SiChiTong/AGV_PowerBoard/NOAH_PM_V0.2_201709291753.pdf

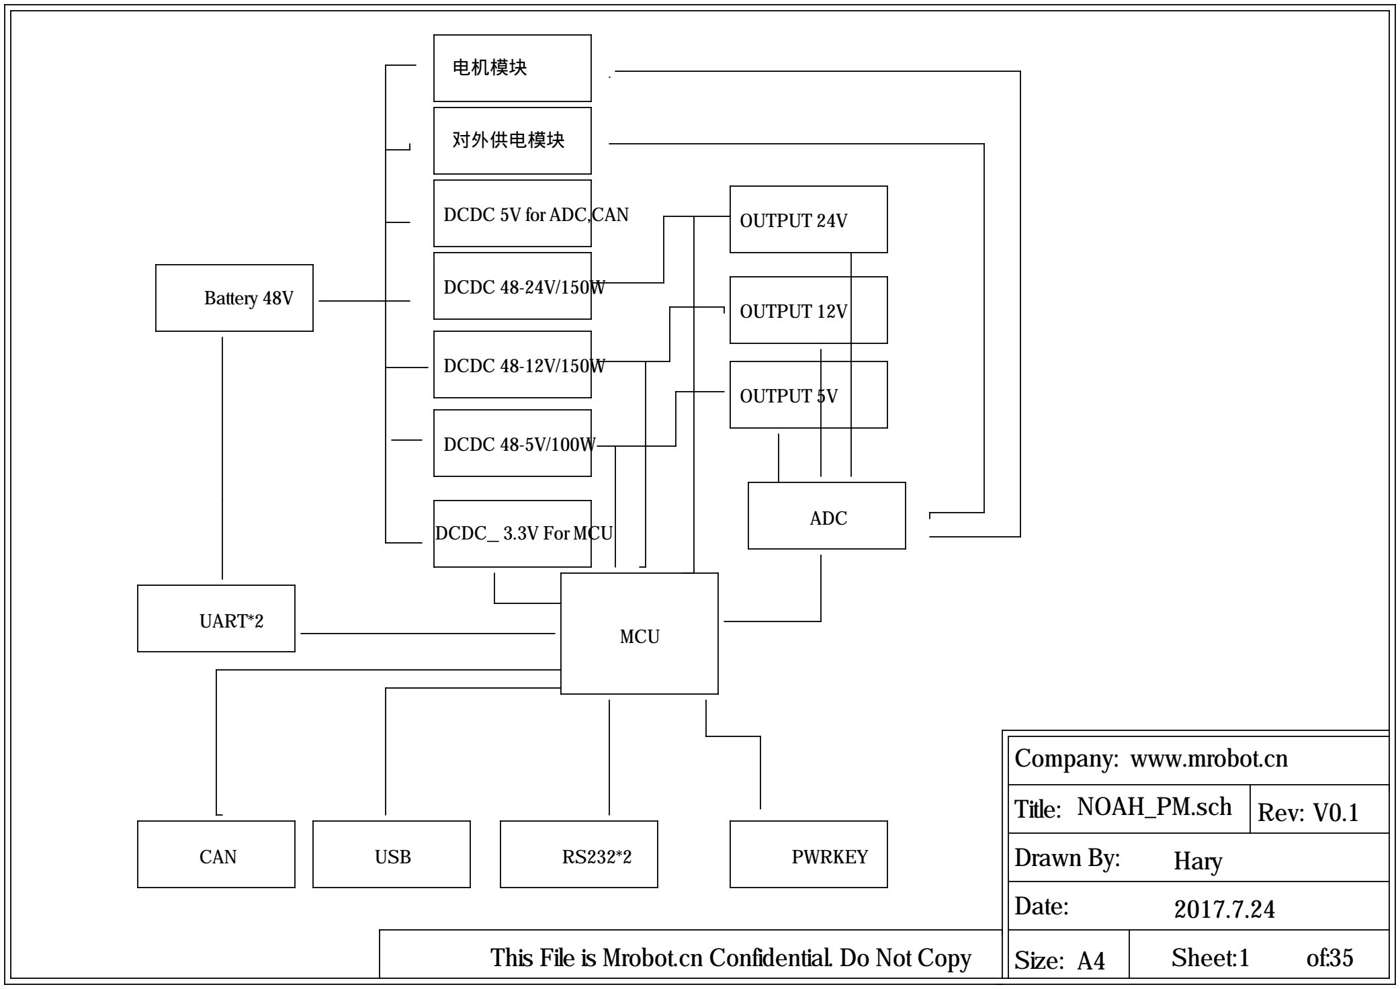
[picture p1: figure]
Company: www.mrobot.cn; Title:; Drawn By:; Date:; Size:; NOAH_PM.sch; Rev: V0.1; Hary; DCDC 48-24V/150W; DCDC 48-12V/150W; DCDC 48-5V/100W; Battery 48V; MCU; OUTPUT 24V; OUTPUT 12V; OUTPUT 5V; ADC; UART*2; CAN; USB; PWRKEY; DCDC_3.3V For MCU; DCDC 5V for ADC,CAN; 对外供电模块; 电机模块

This File is Mrobot.cn Confidential. Do Not Copy | A4 | Sheet: | of: 1 | 35

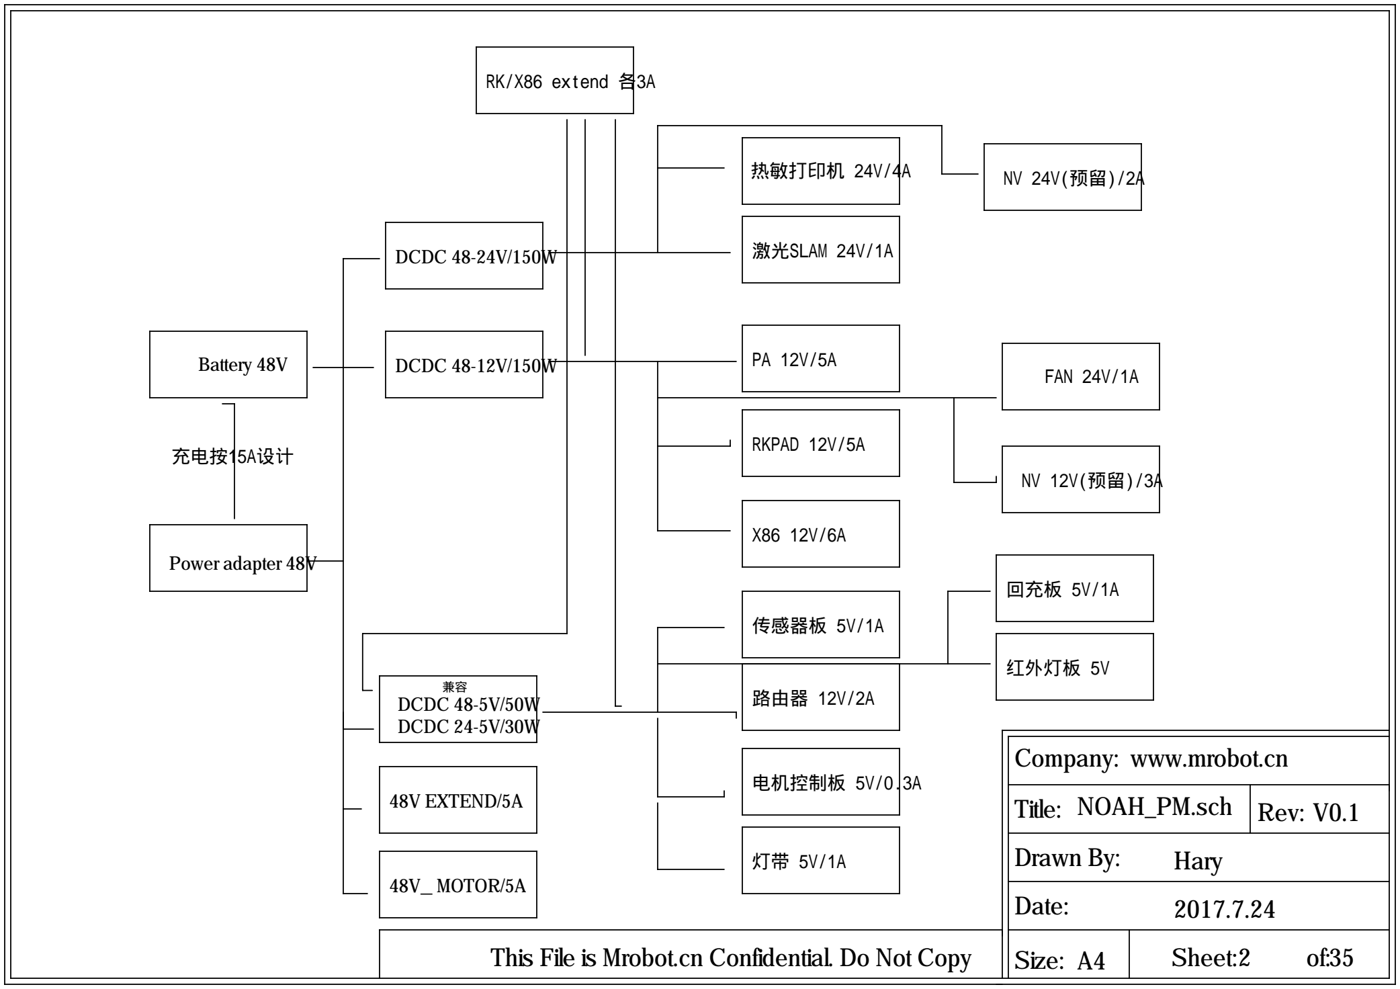
[picture p2: figure]
Company: www.mrobot.cn; Title:; Drawn By:; Date:; NOAH_PM.sch; Rev: V0.1; Hary; Battery 48V; DCDC 48-24V/150W; DCDC 48-12V/150W; DCDC 48-5V/50W; 热敏打印机 24V/4A; 激光SLAM 24V/1A; RKPAD 12V/5A; RK/X86 extend 各3A; 传感器板 5V/1A; 路由器 12V/2A; 电机控制板 5V/0.3A; FAN 24V/1A; 回充板 5V/1A; 红外灯板 5V; 48V EXTEND/5A; 48V_MOTOR/5A; Power adapter 48V; 充电按15A设计; DCDC 24-5V/30W

This File is Mrobot.cn Confidential. Do Not Copy | A4 | Sheet: | of: 2 | 35

# DC-DCÄ£¿é

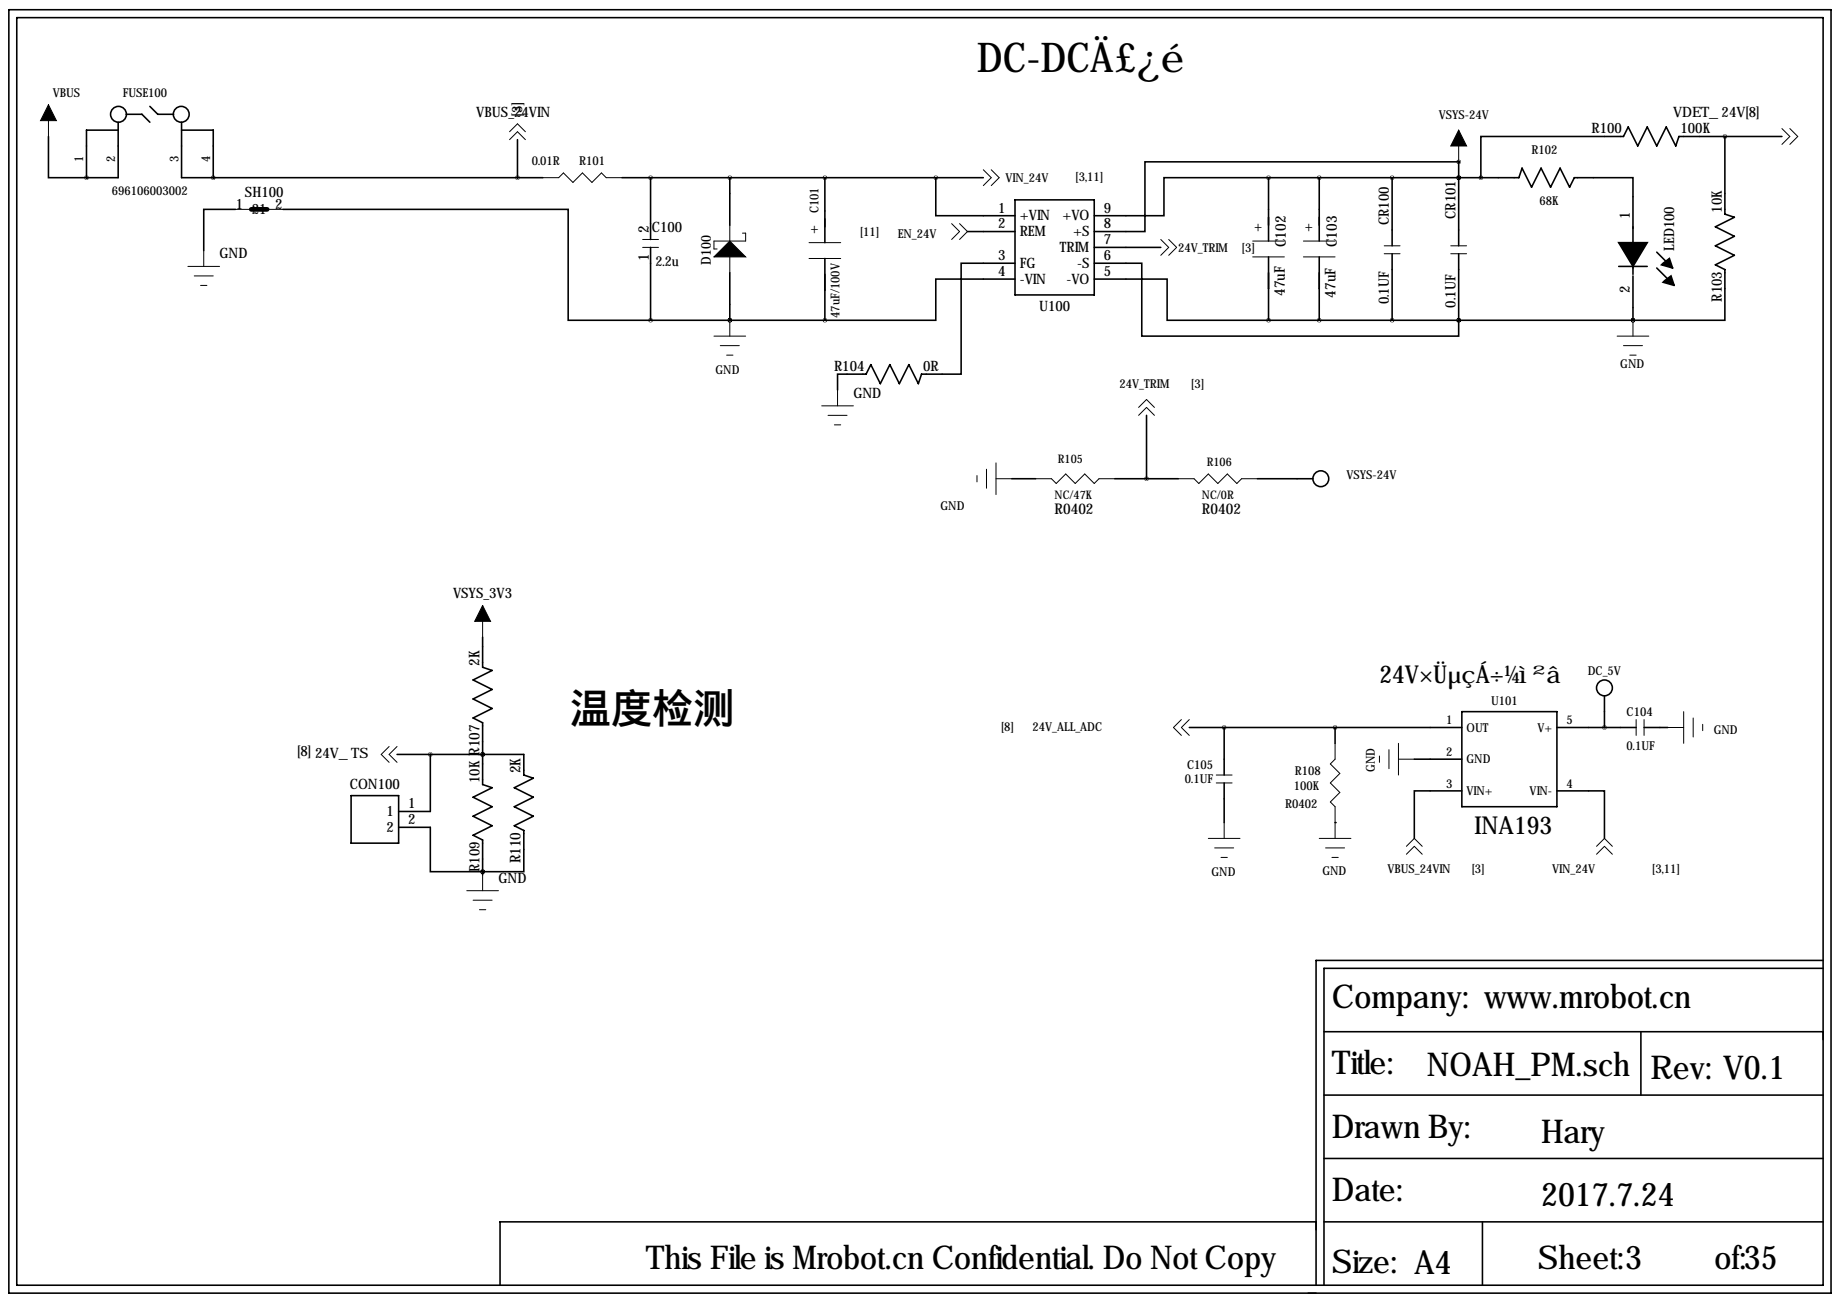
[picture p3: page 3]

Company: www.mrobot.cn

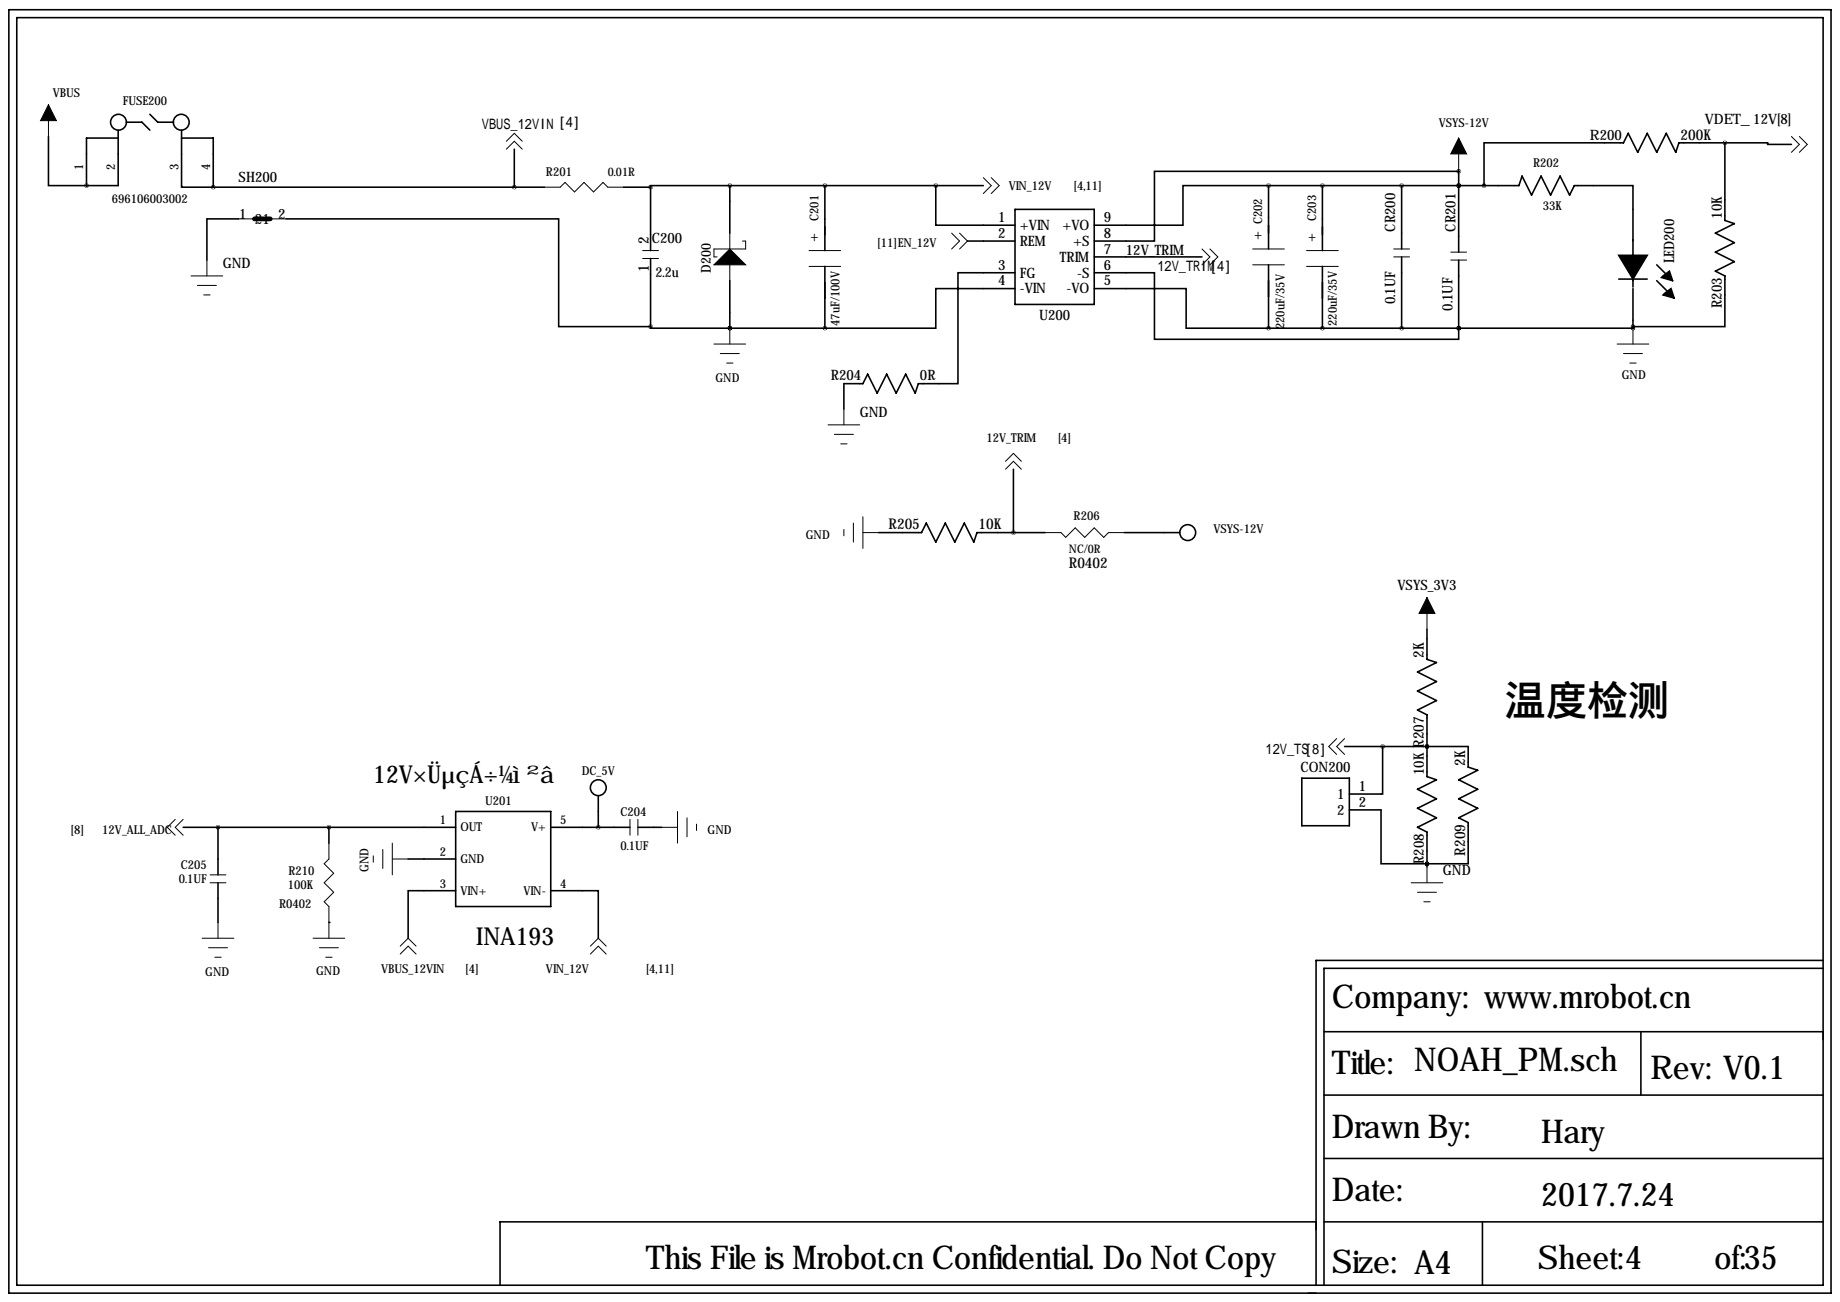
[picture p4: page 4]

Company: www.mrobot.cn

## Note:兼容四分之一砖封装

### Note:料号不对

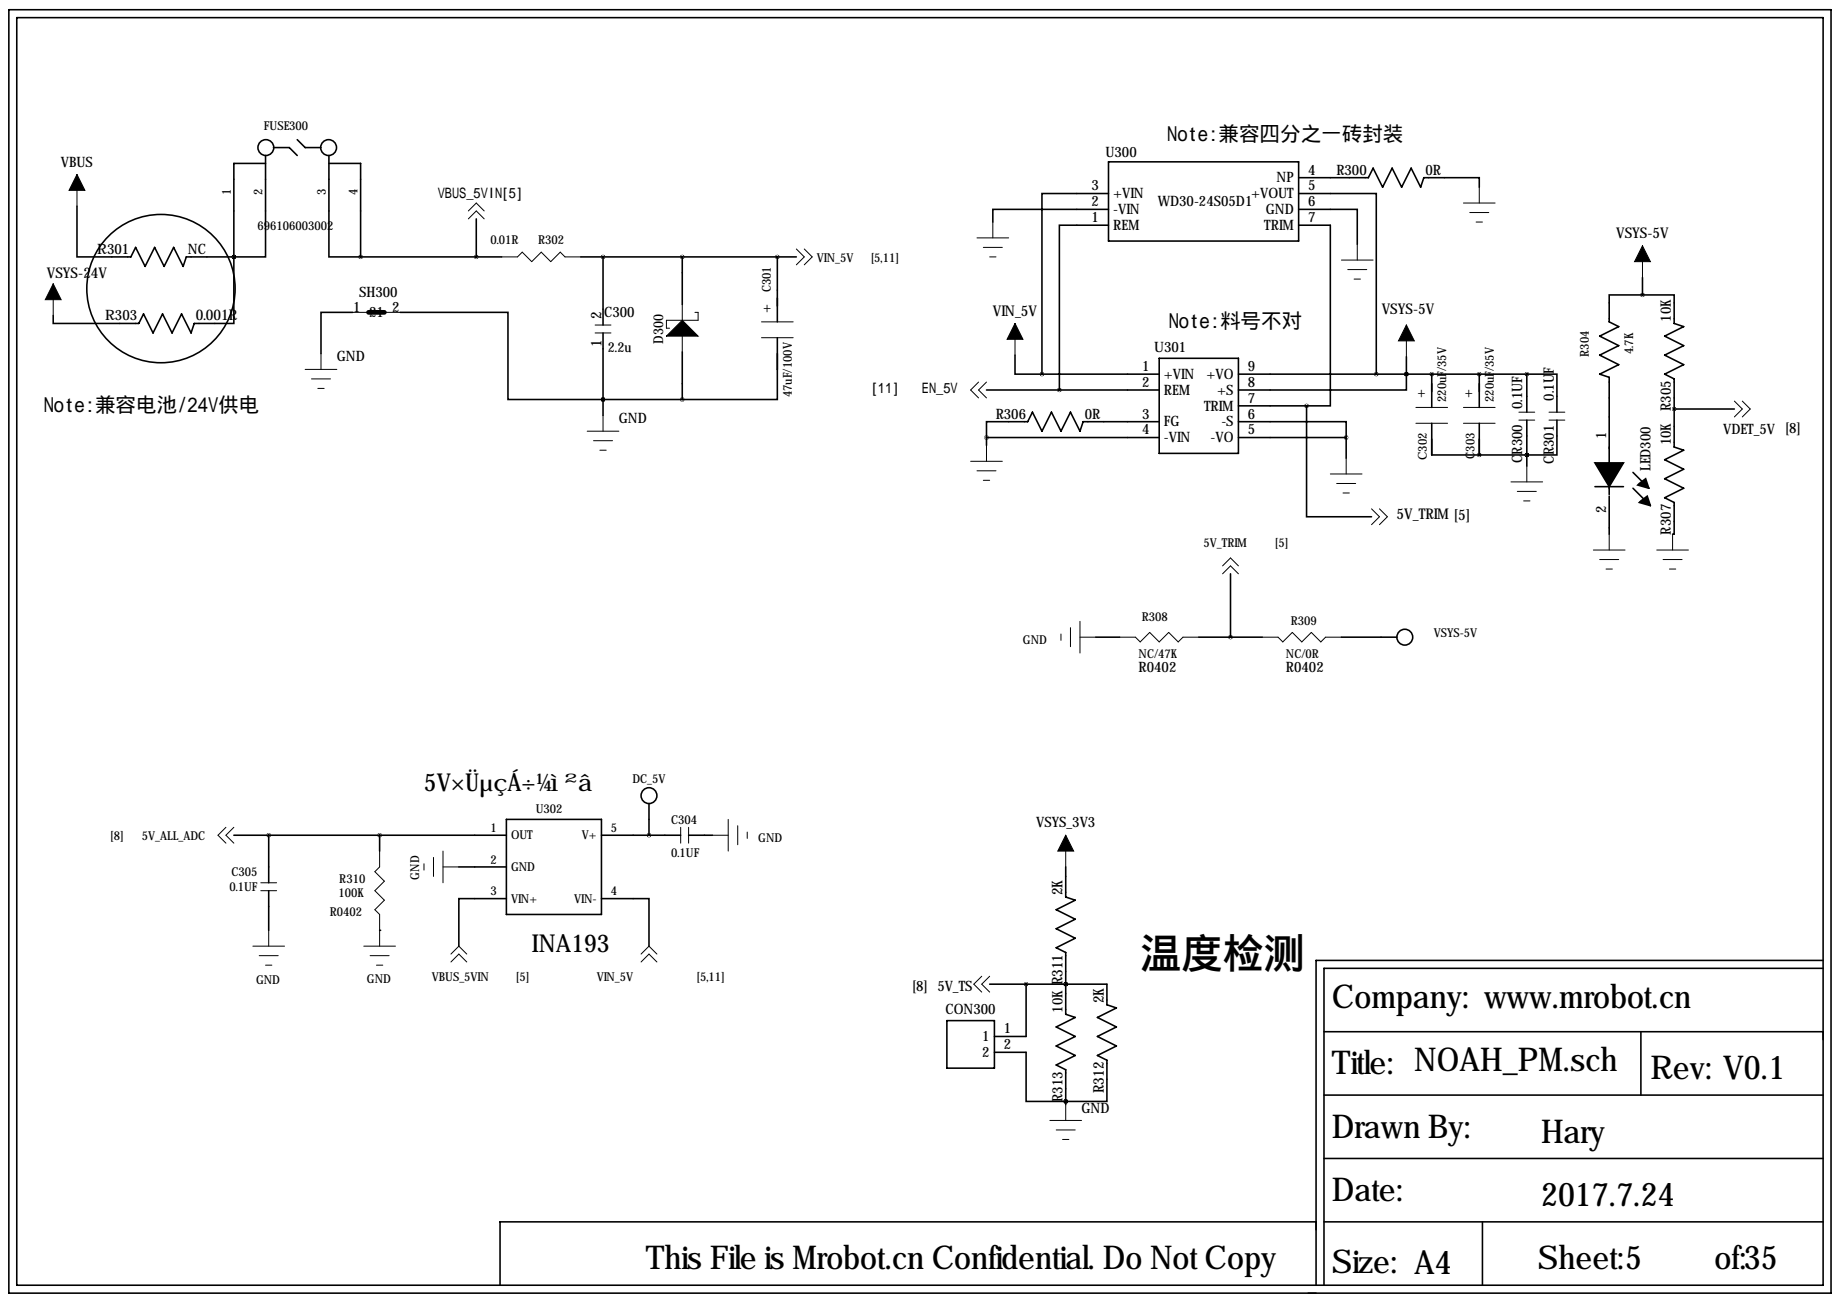
[picture p5: page 5]

Company: www.mrobot.cn

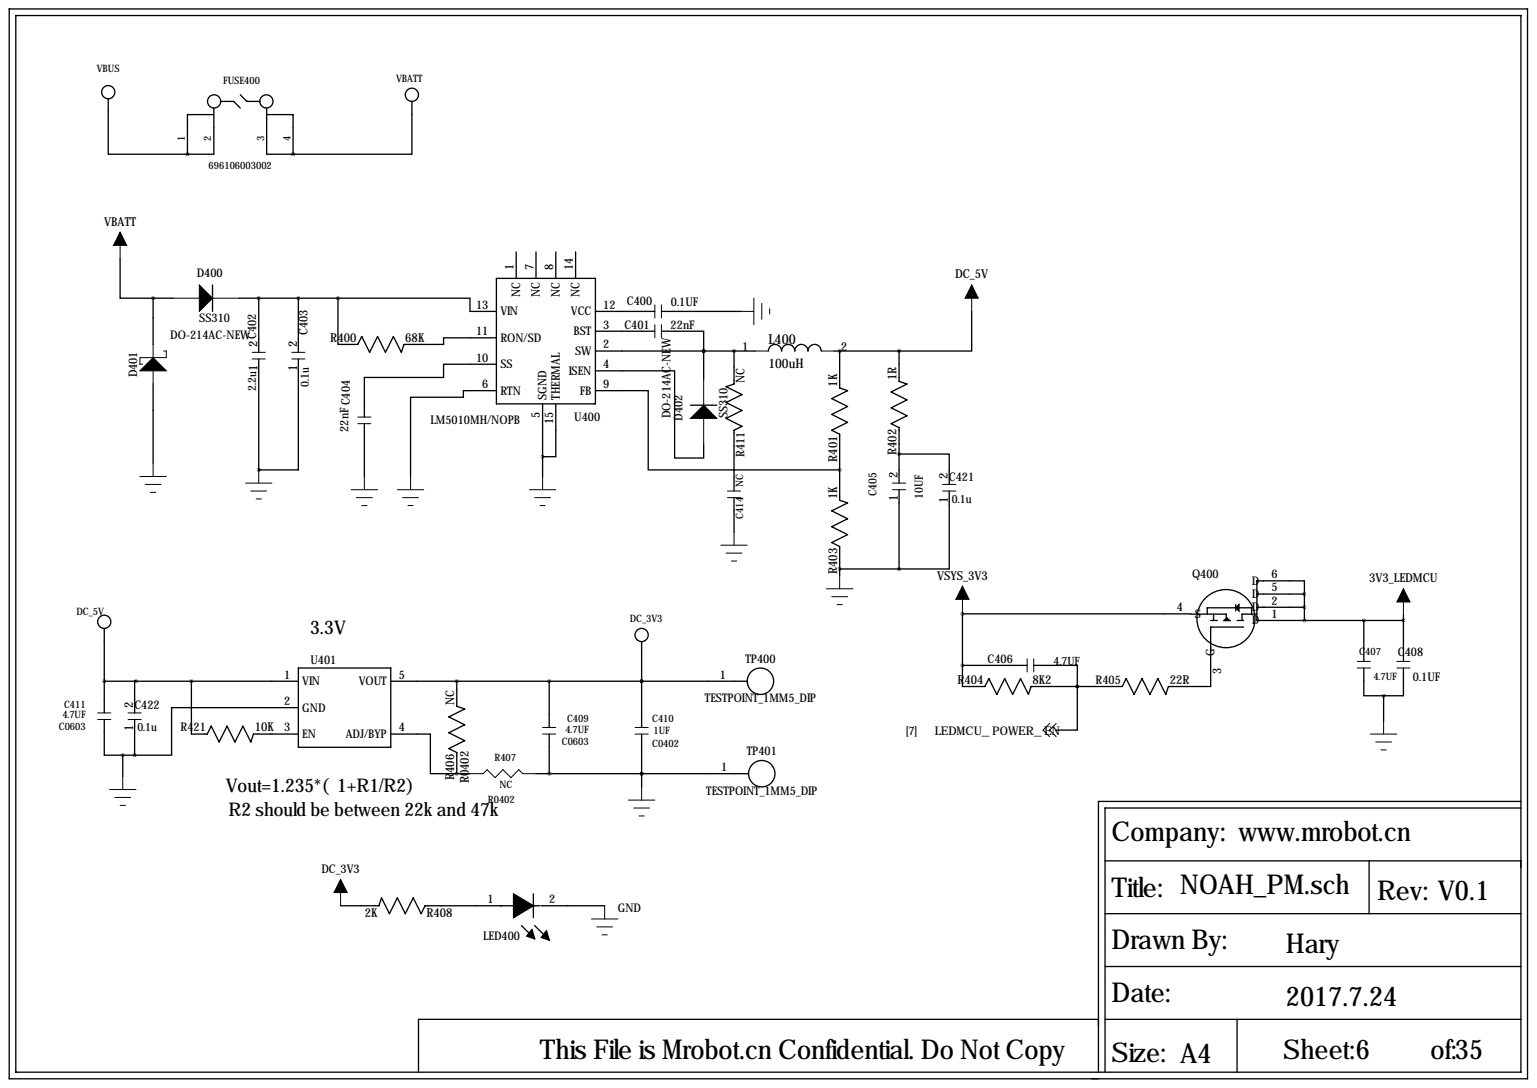
[picture p6: page 6]

Vout=1.235*(1+R1/R2)
R2 should be between 22k and 47k

Company: www.mrobot.cn

# C503 22PF Y⁵00

### VSYS_3V3

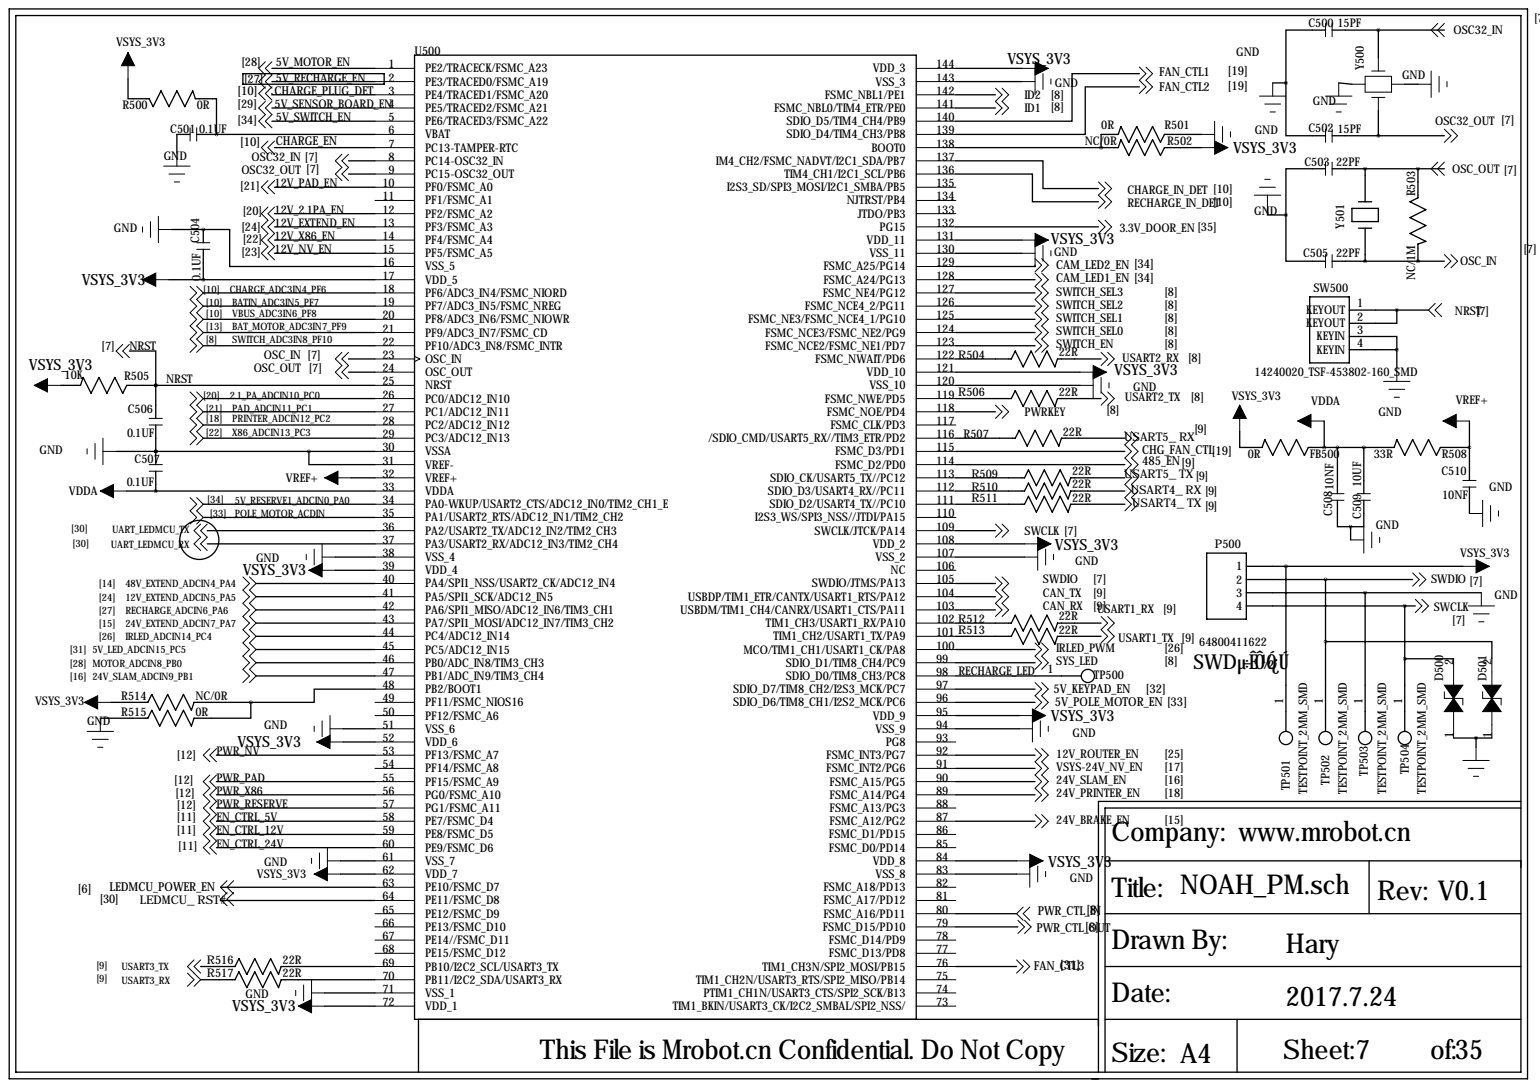
[picture p7: page 7]

### ´®¿ÚÉÕÂ¼Ê± ½Ó3.3V

## µç³ØµçÑ¹¼ì²â

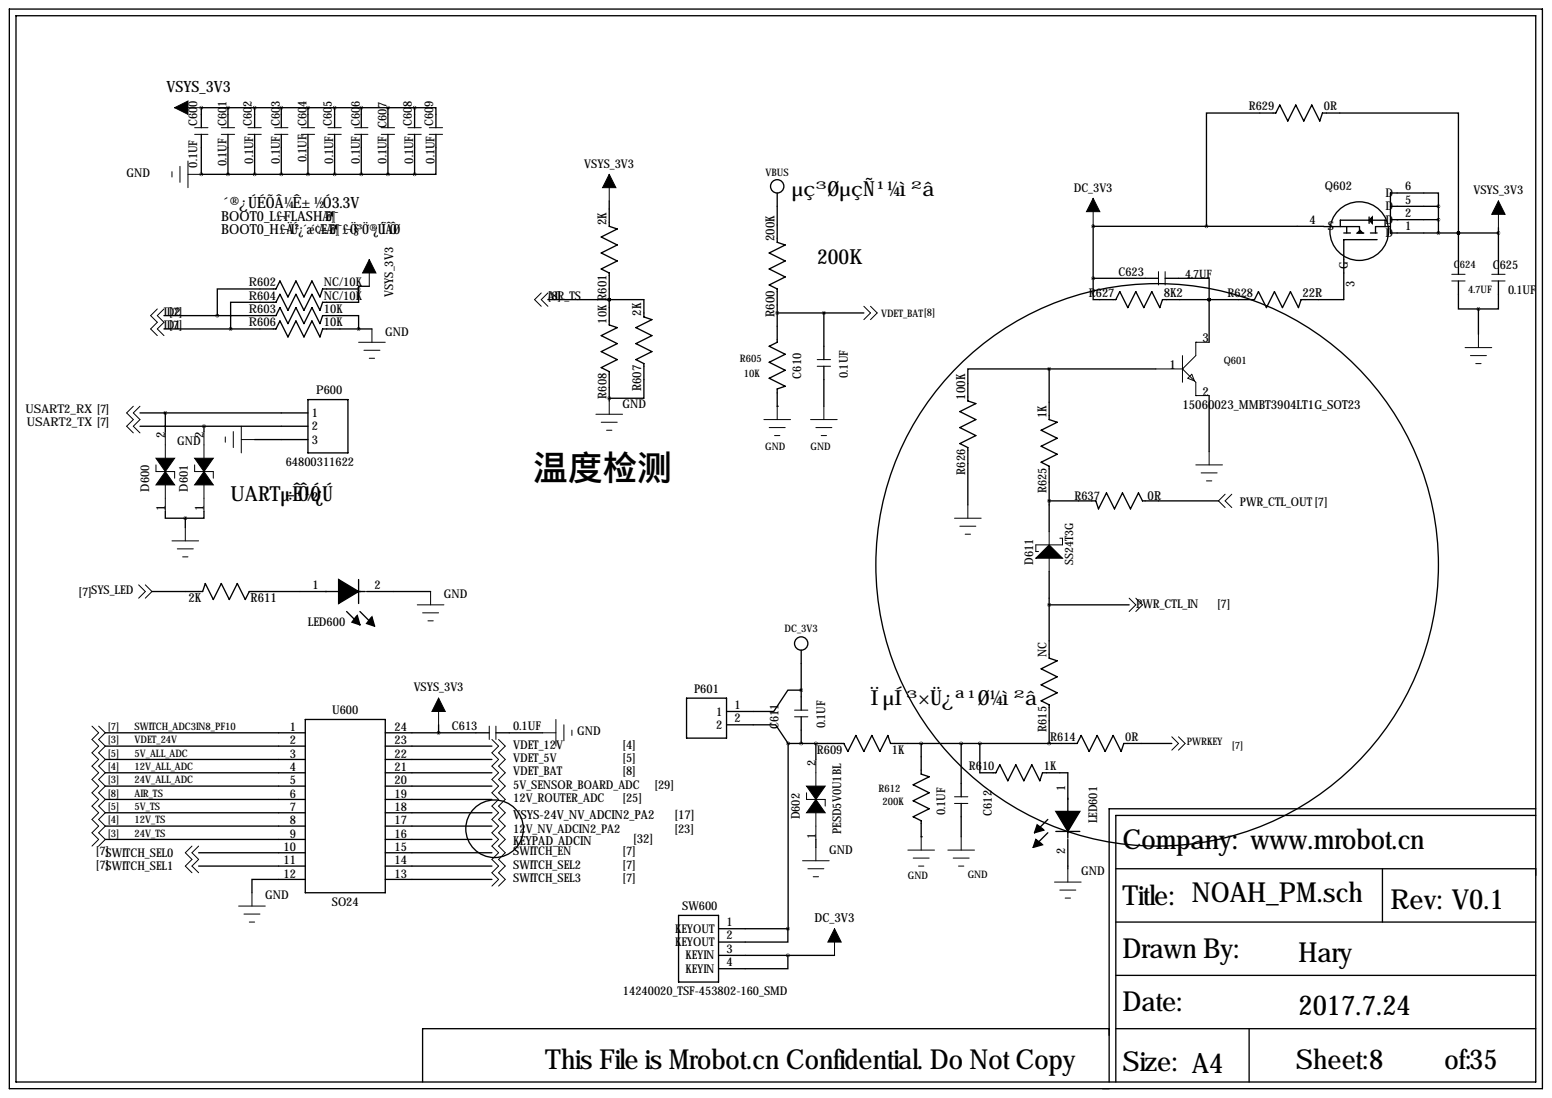
[picture p8: page 8]

BOOT0_L£¬FLASHÆô¶¯
BOOT0_H£¬ÄÚ²¿´æ´¢Æ÷Æô¶¯£¬Ö§³Ö´®¿ÚÏÂÔØ

Company: www.mrobot.cn

## X86Í¨Ñ¶¿Ú

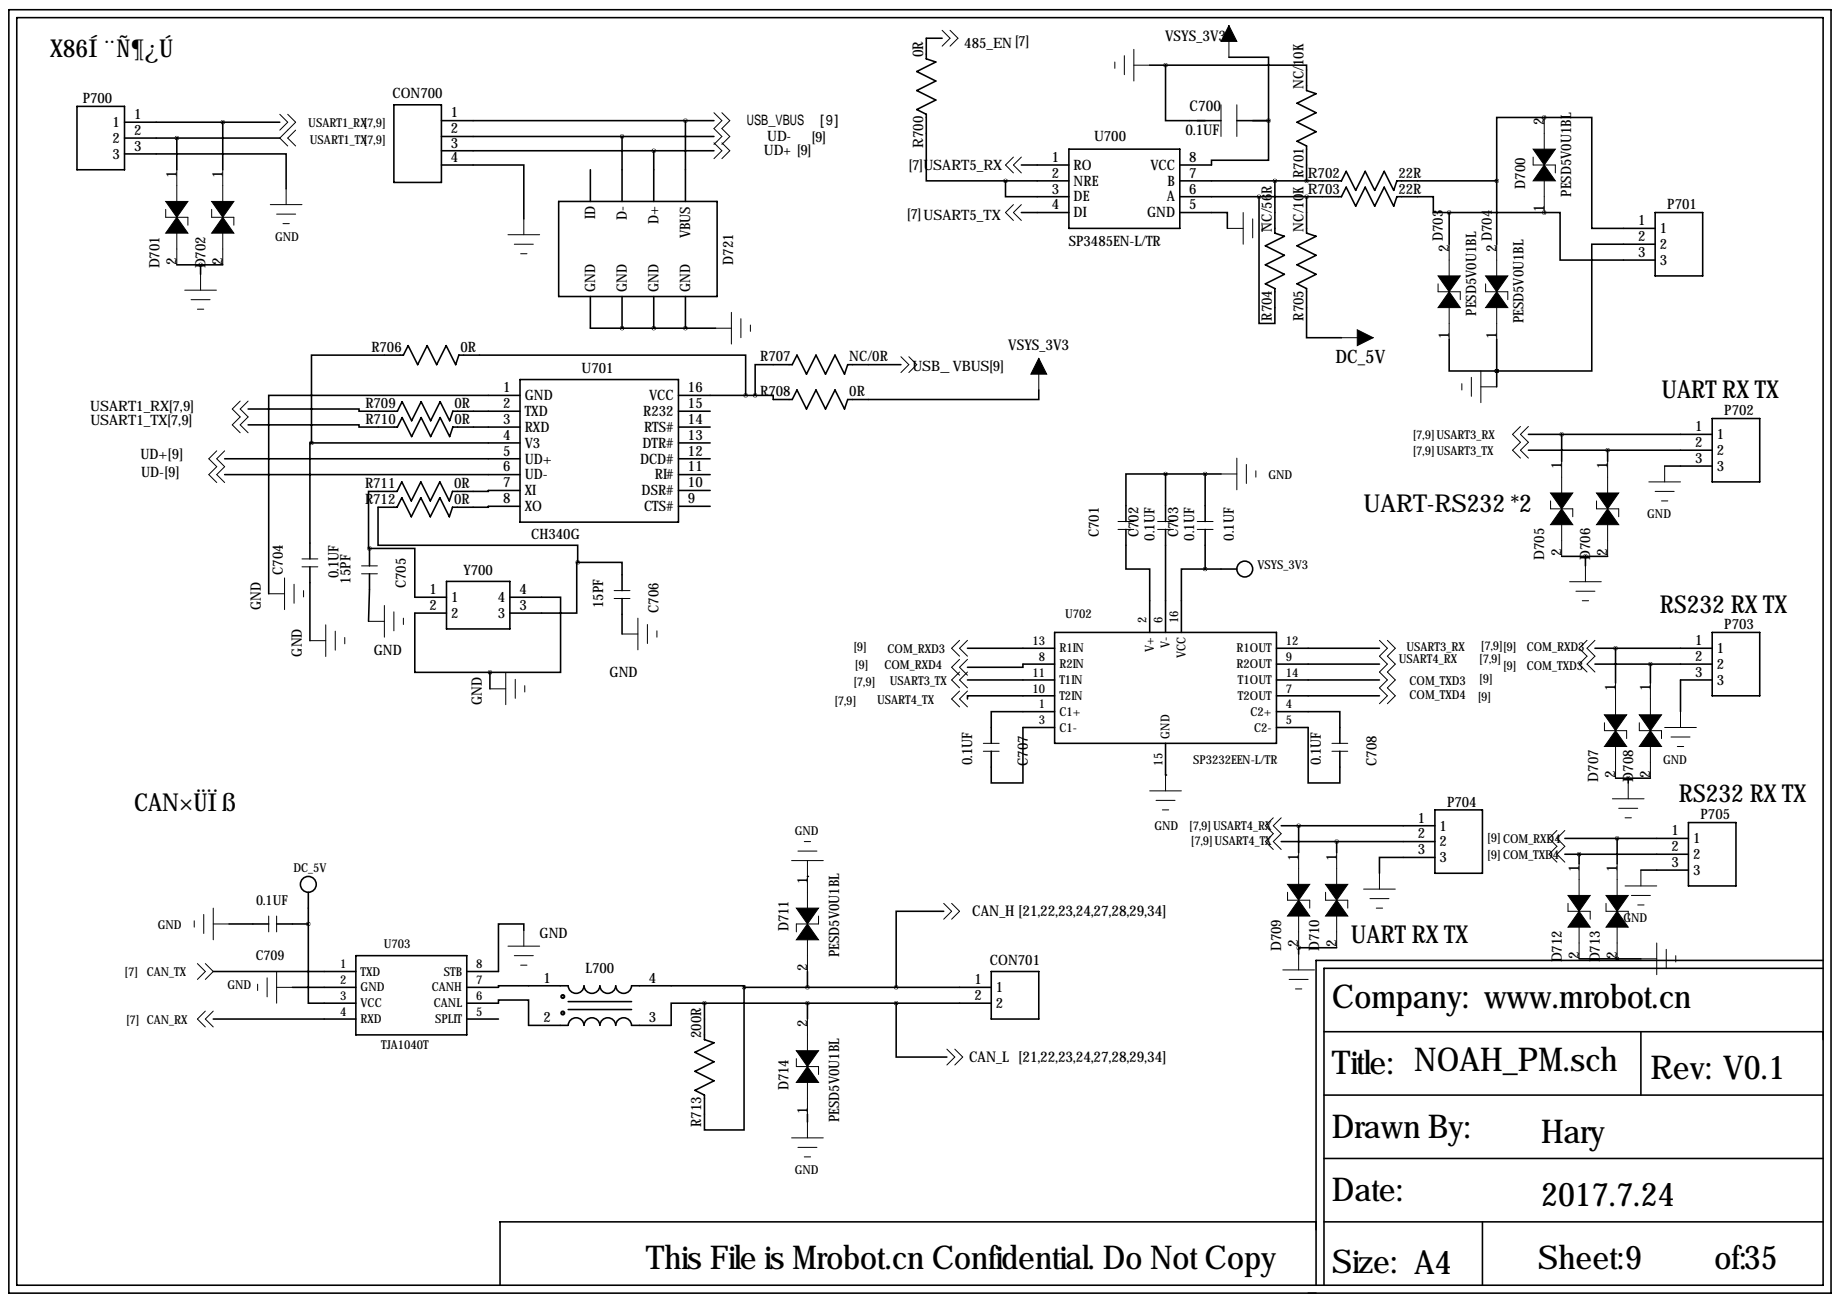
[picture p9: page 9]

Company: www.mrobot.cn

## ×ÜµçÁ÷¼ì²â

## INA193

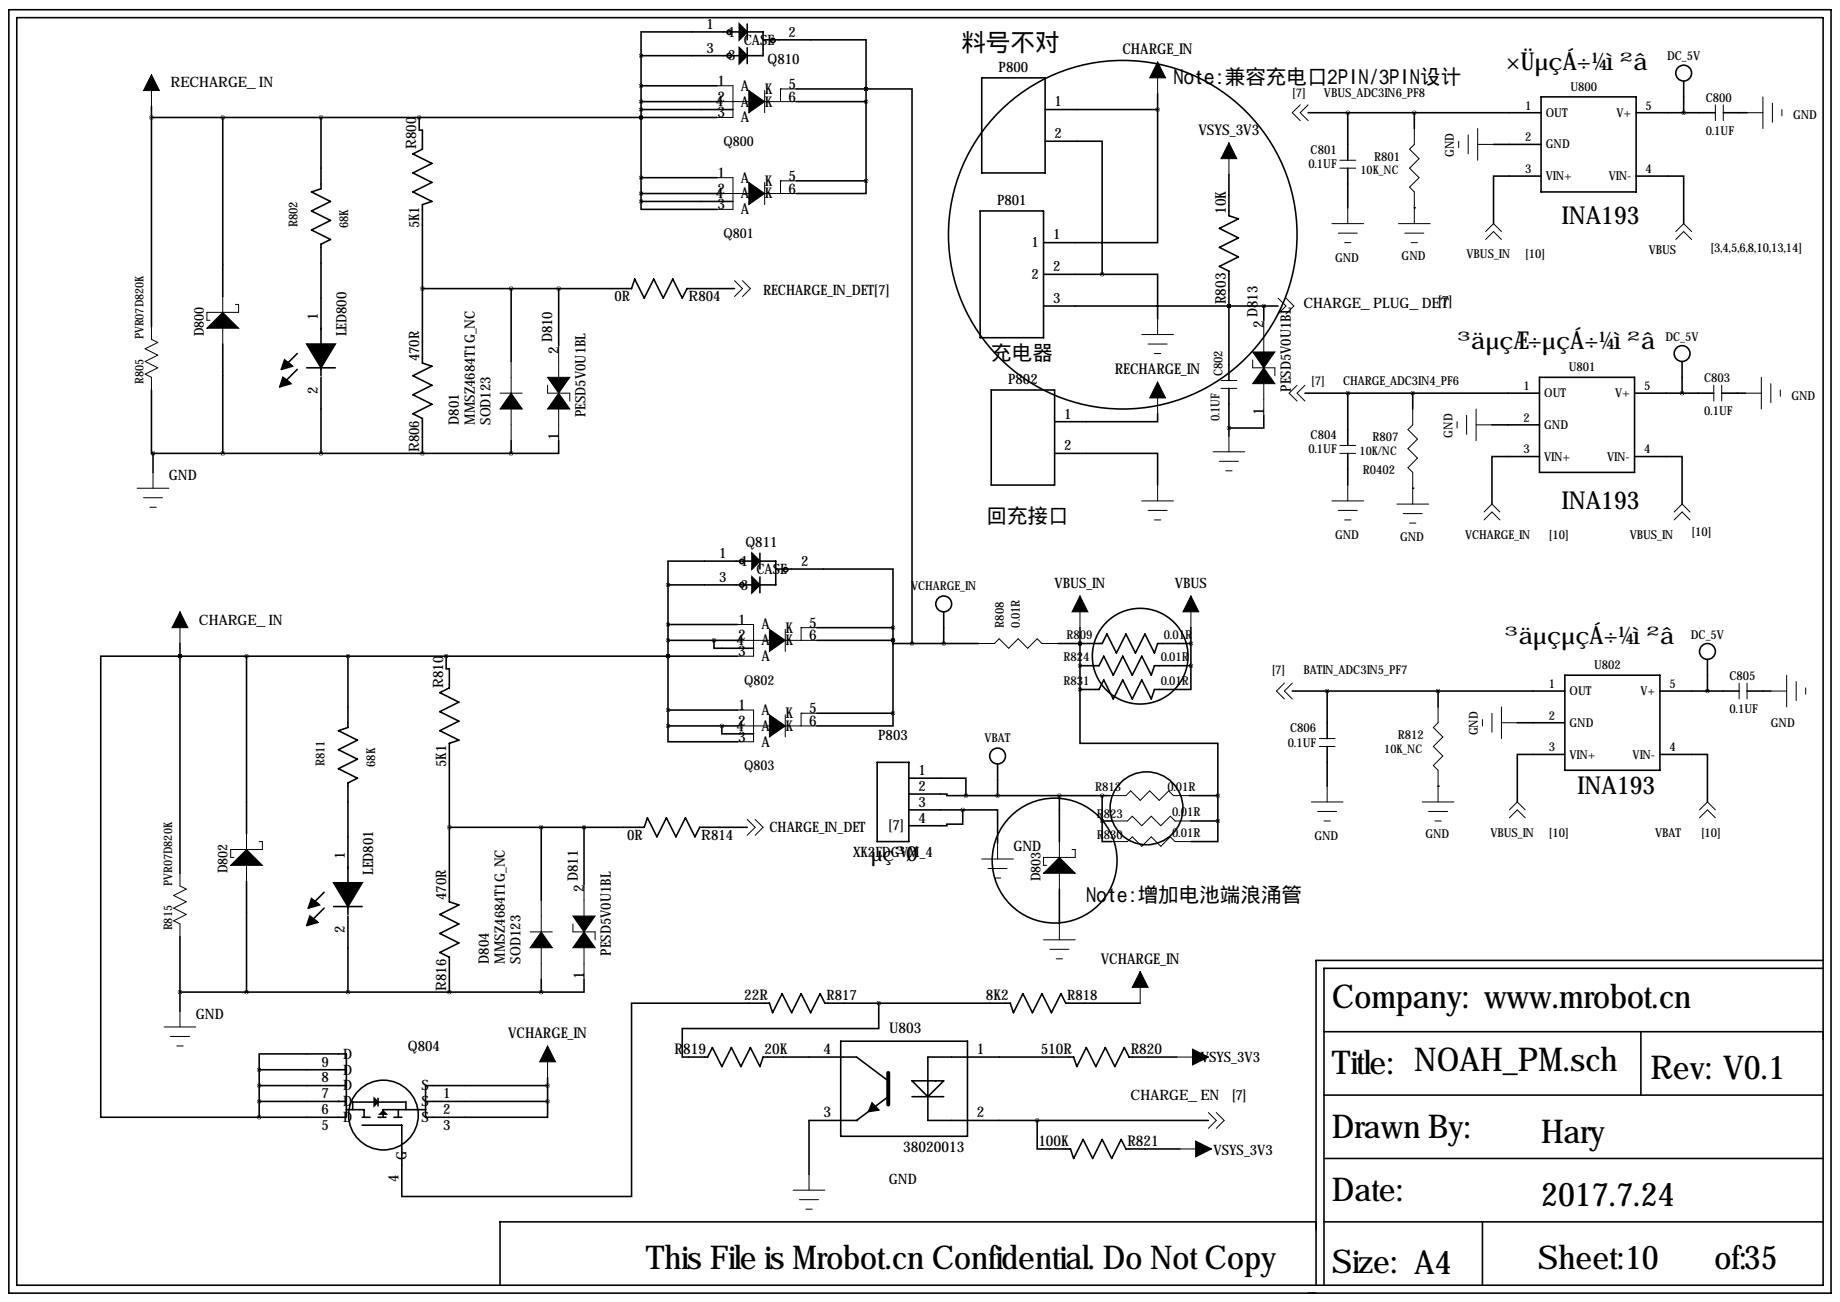
[picture p10: page 10]

Company: www.mrobot.cn

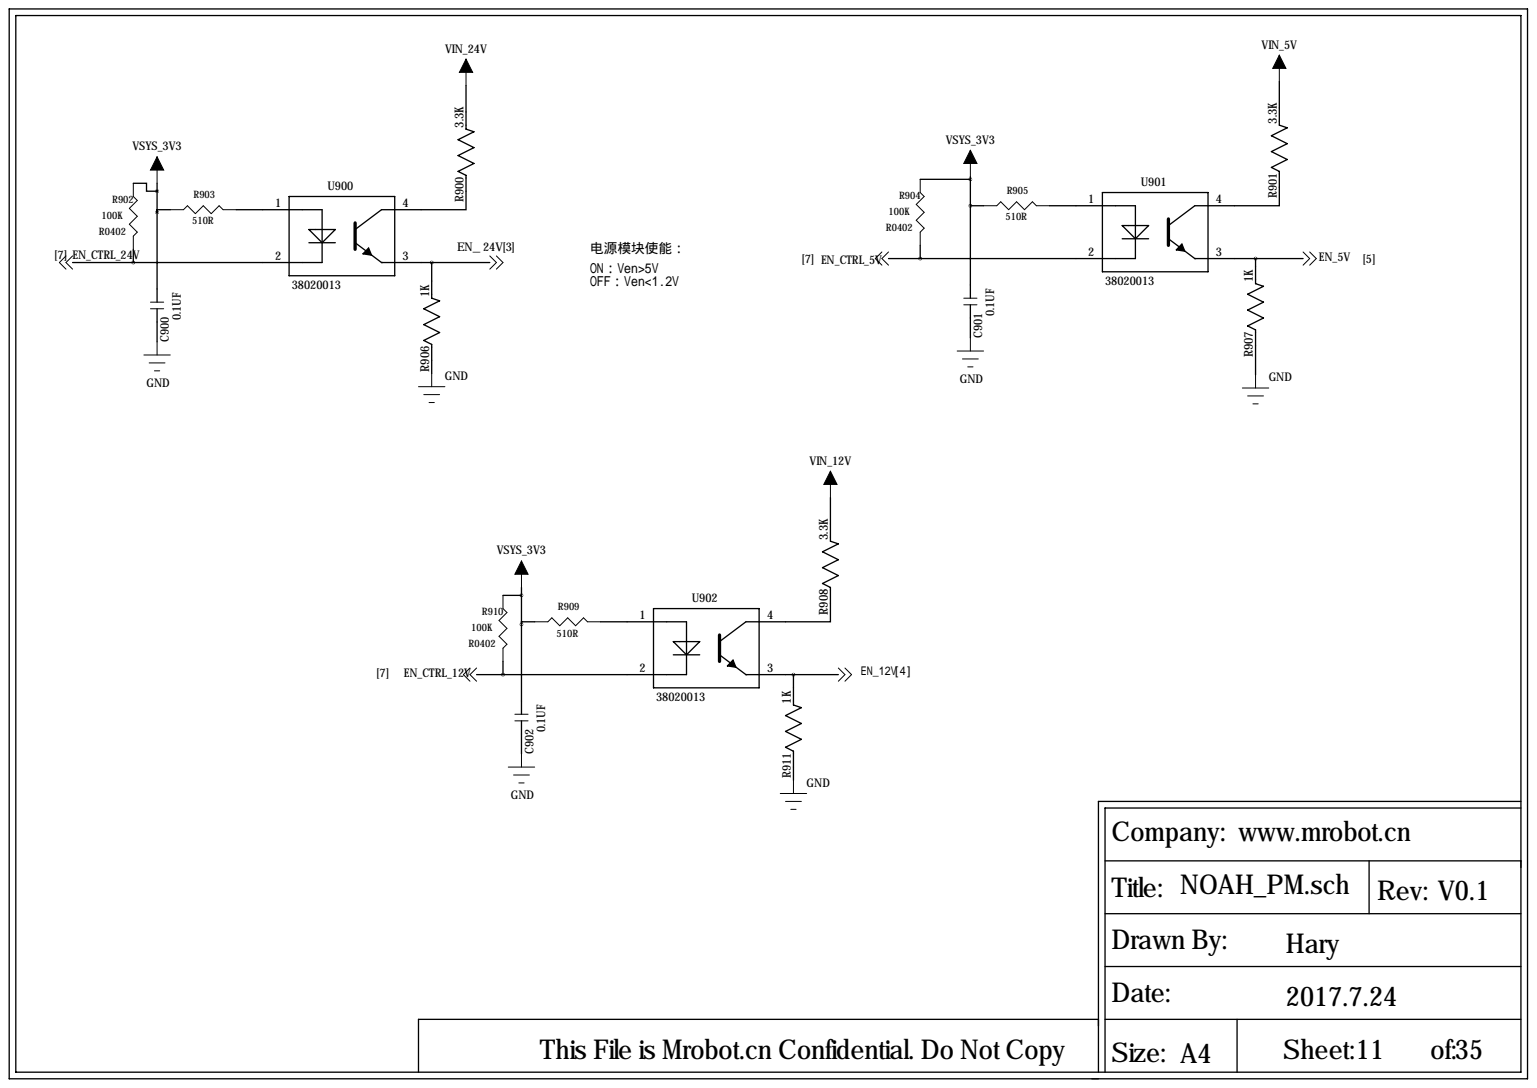
[picture p11: page 11]

Company: www.mrobot.cn

PAD PWRKEY | X86 PWRKEY

## C Q¹⁰⁰⁰

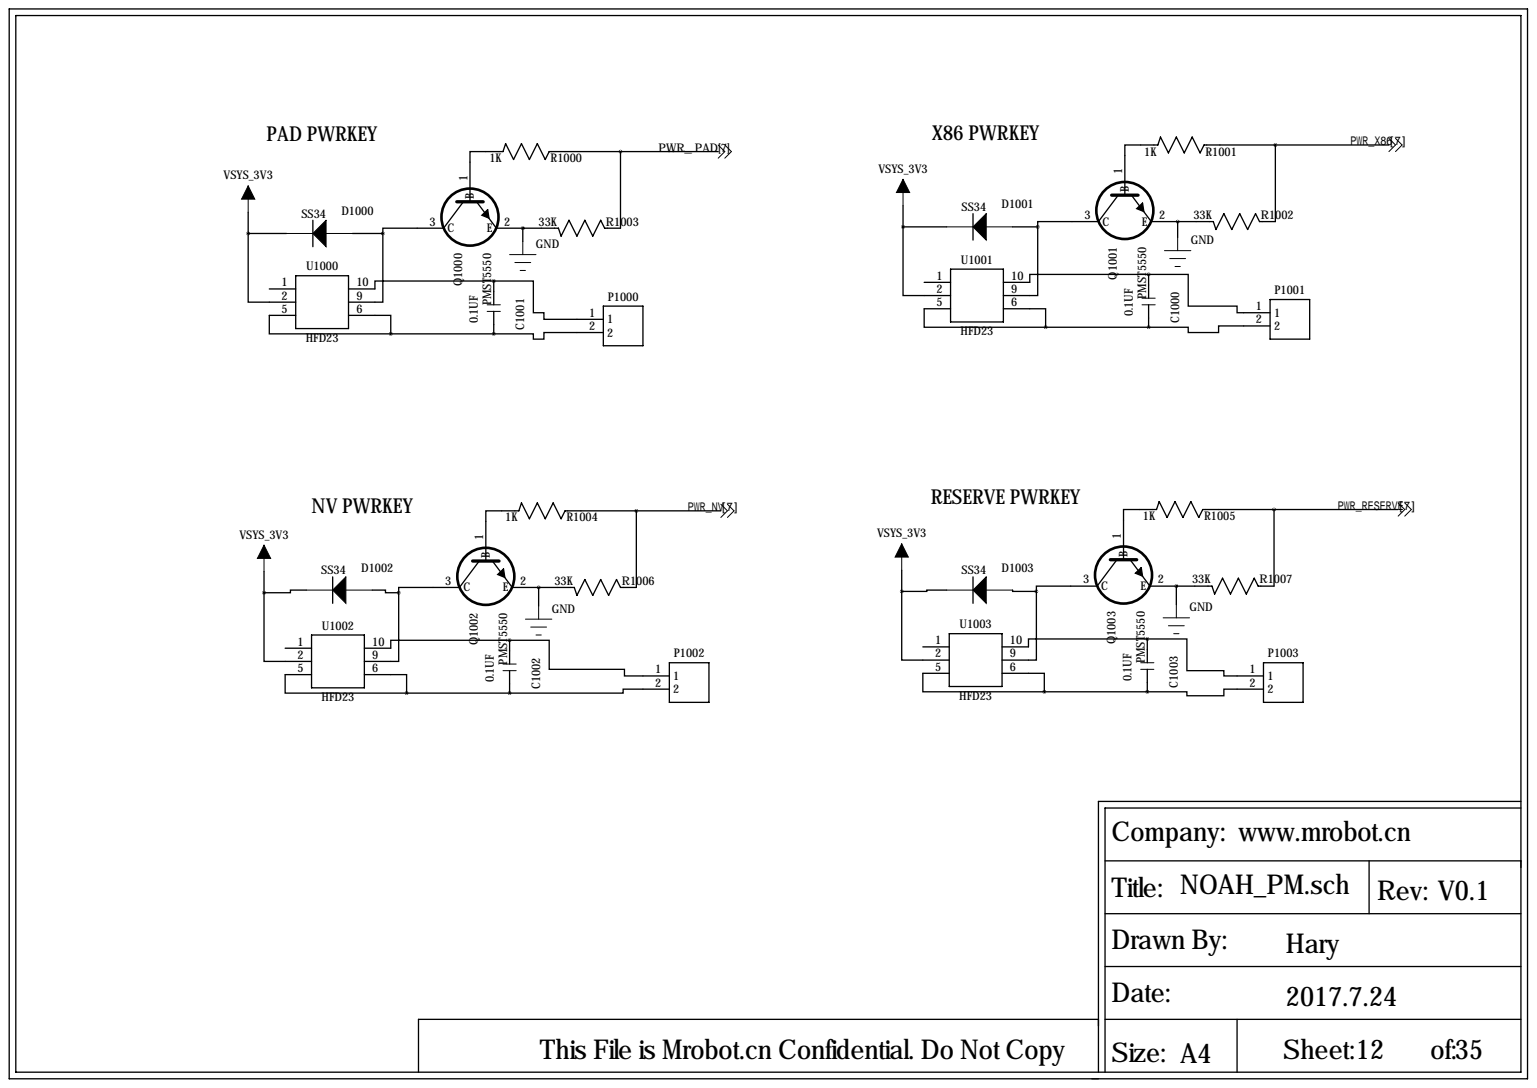
[picture p12: page 12]

Company: www.mrobot.cn

## 电机驱动器48V

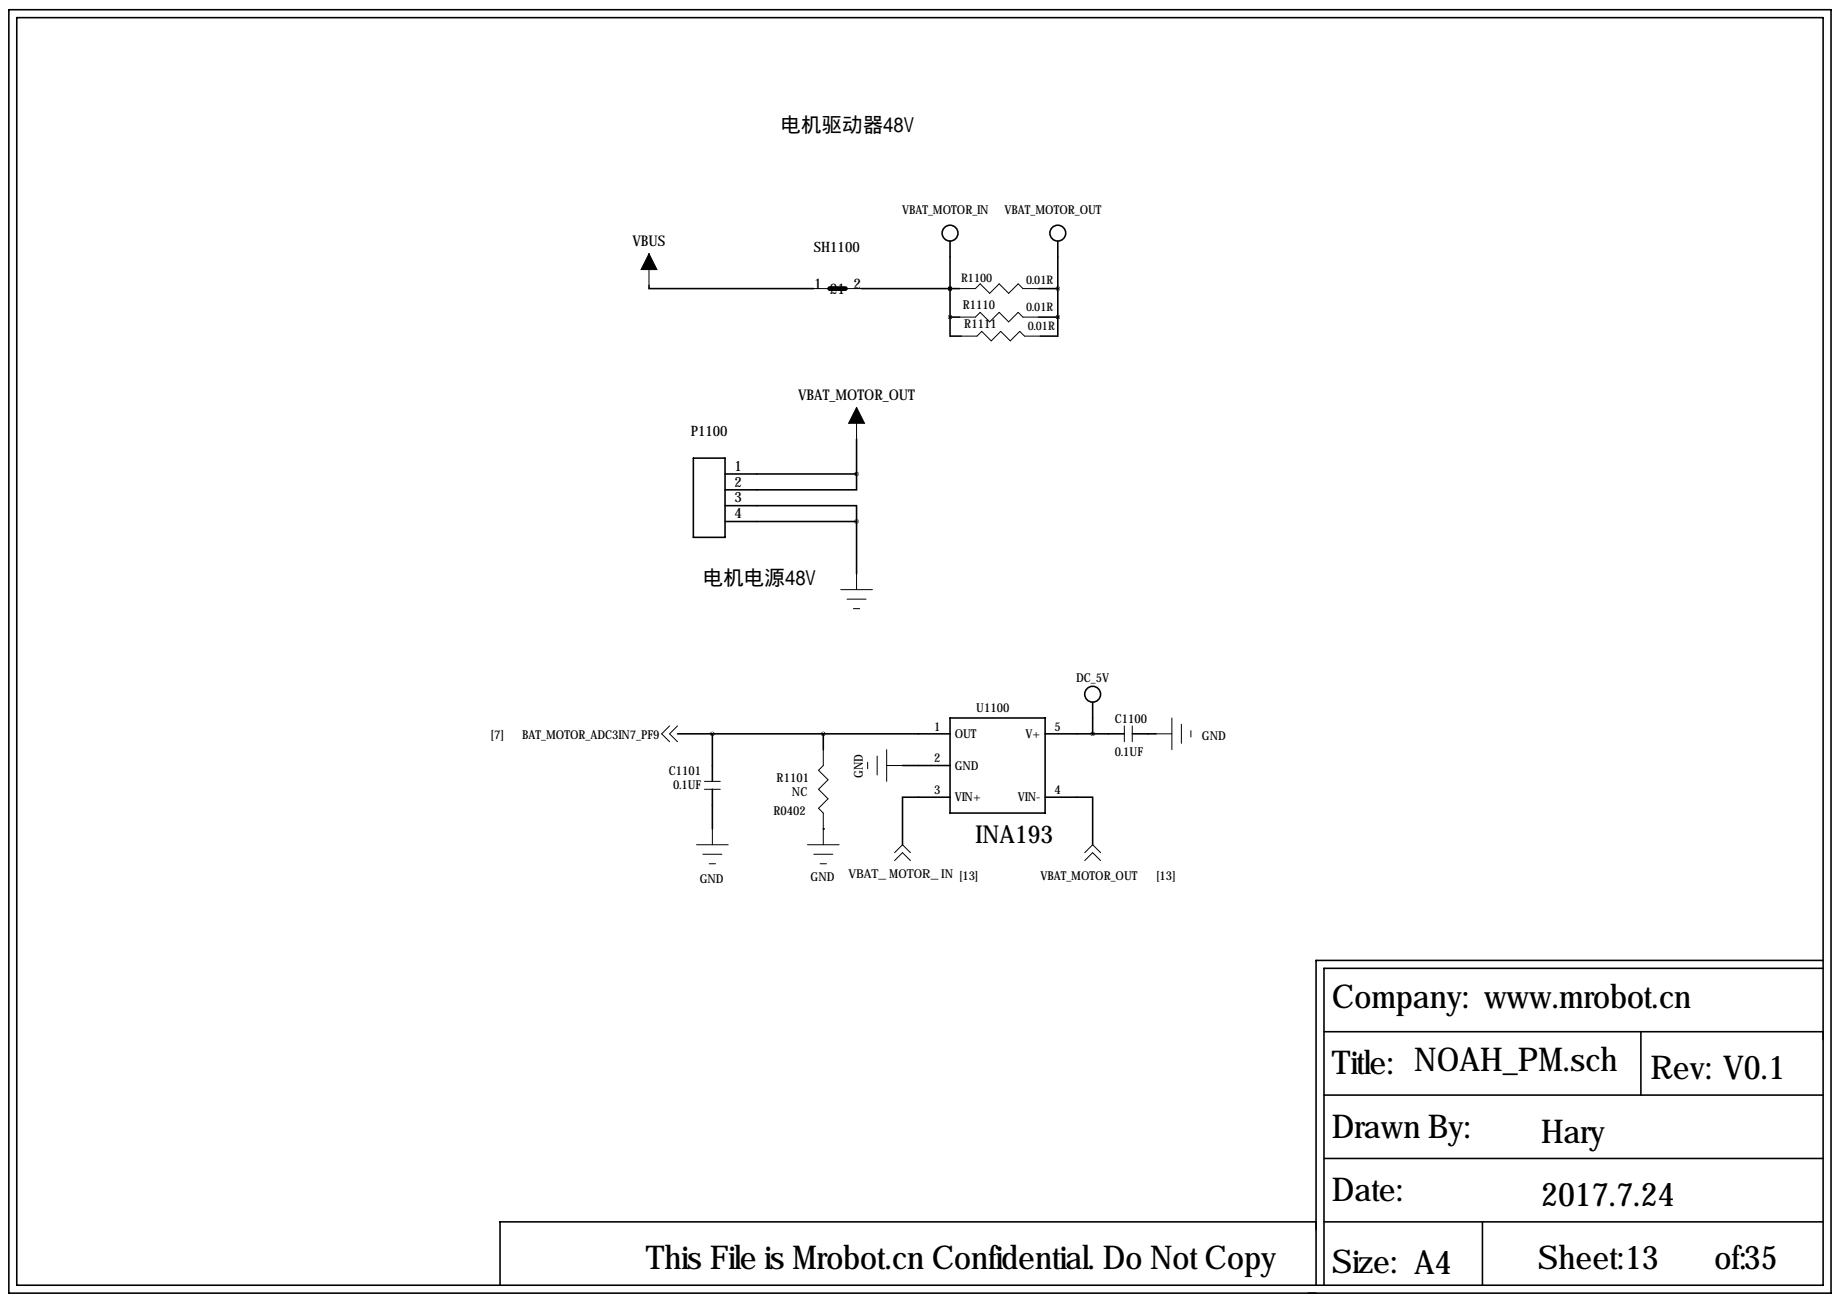
[picture p13: page 13]

Company: www.mrobot.cn

## 对外供电模块48V

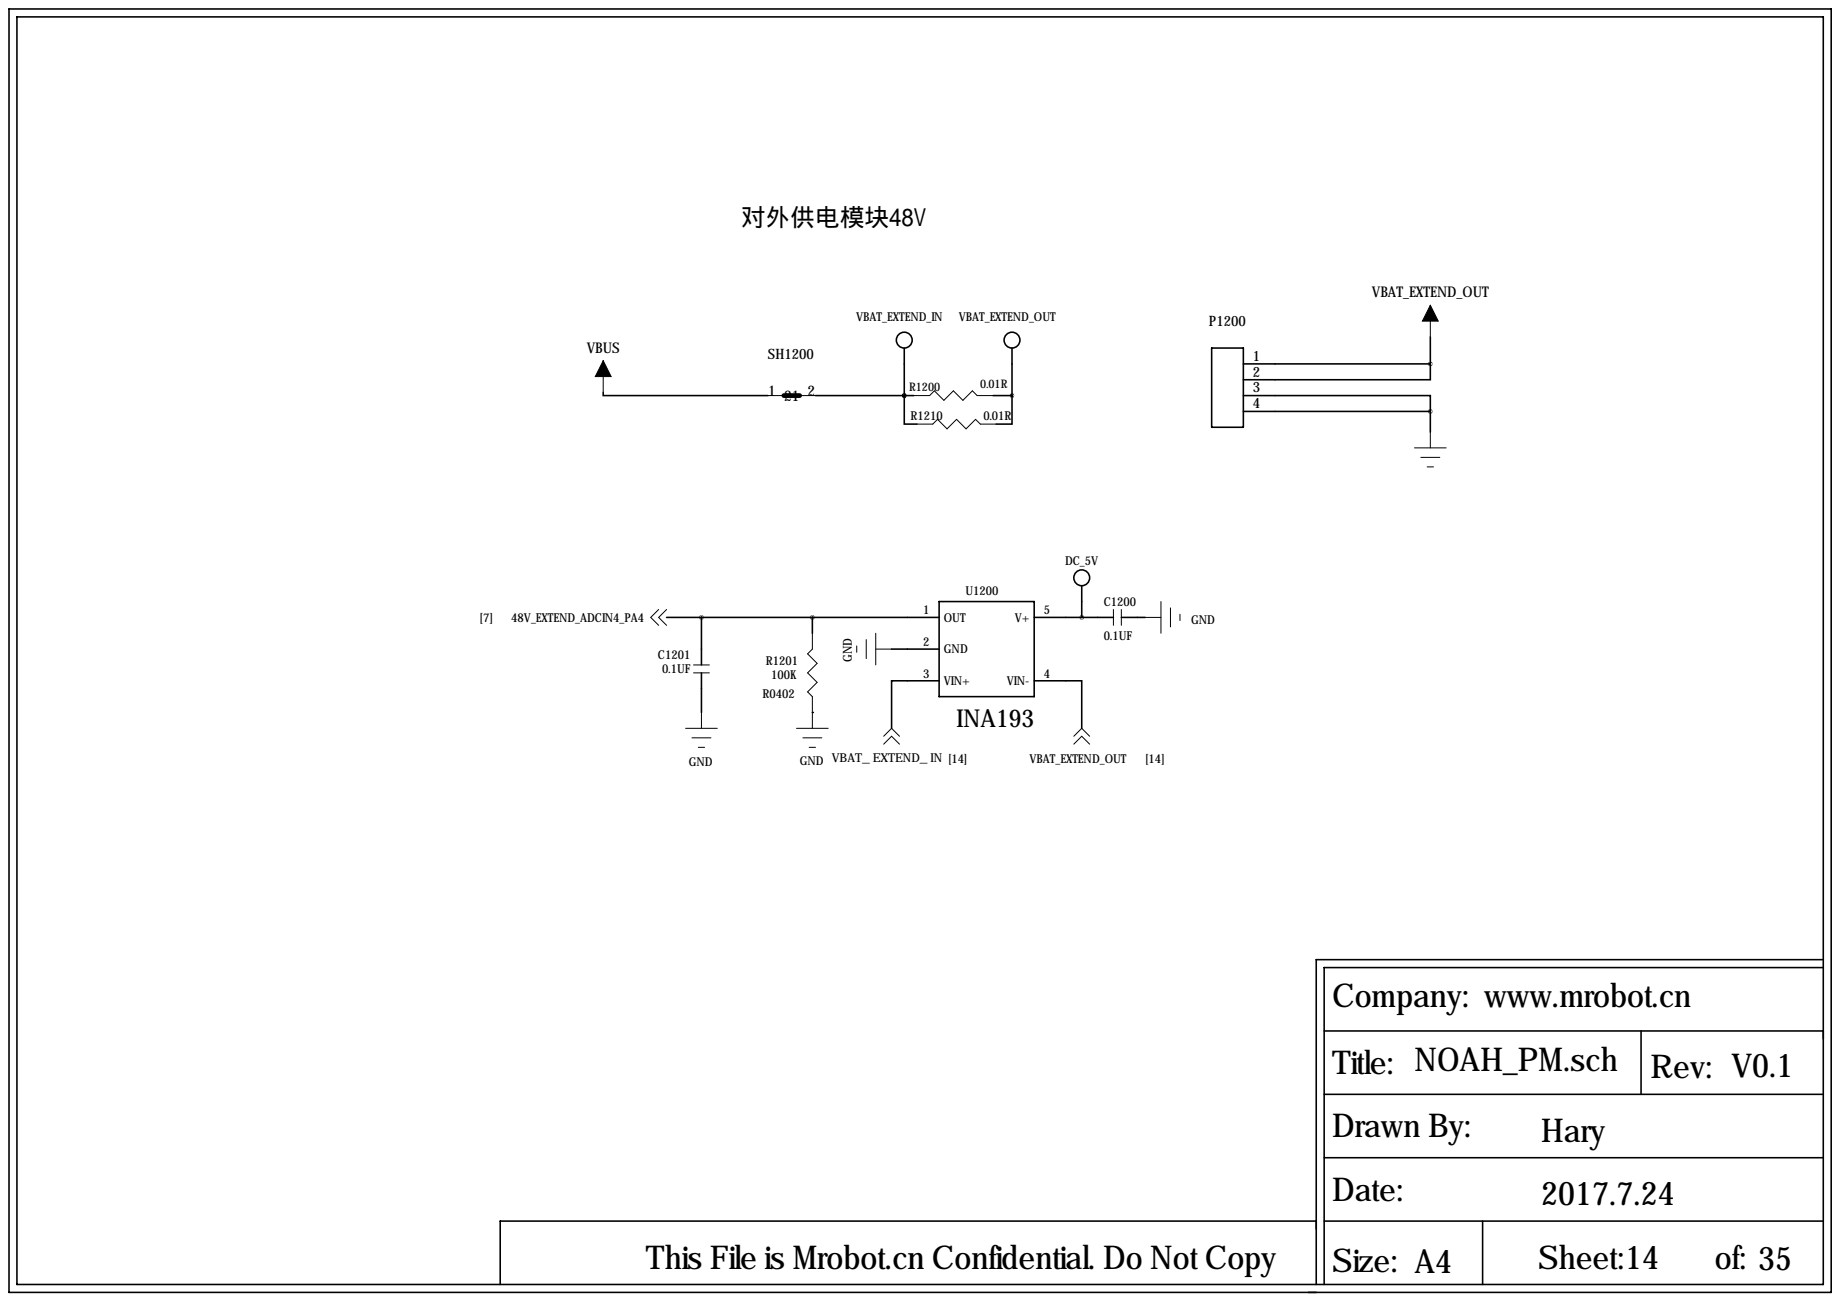
[picture p14: page 14]

Company: www.mrobot.cn

## 转接板24V

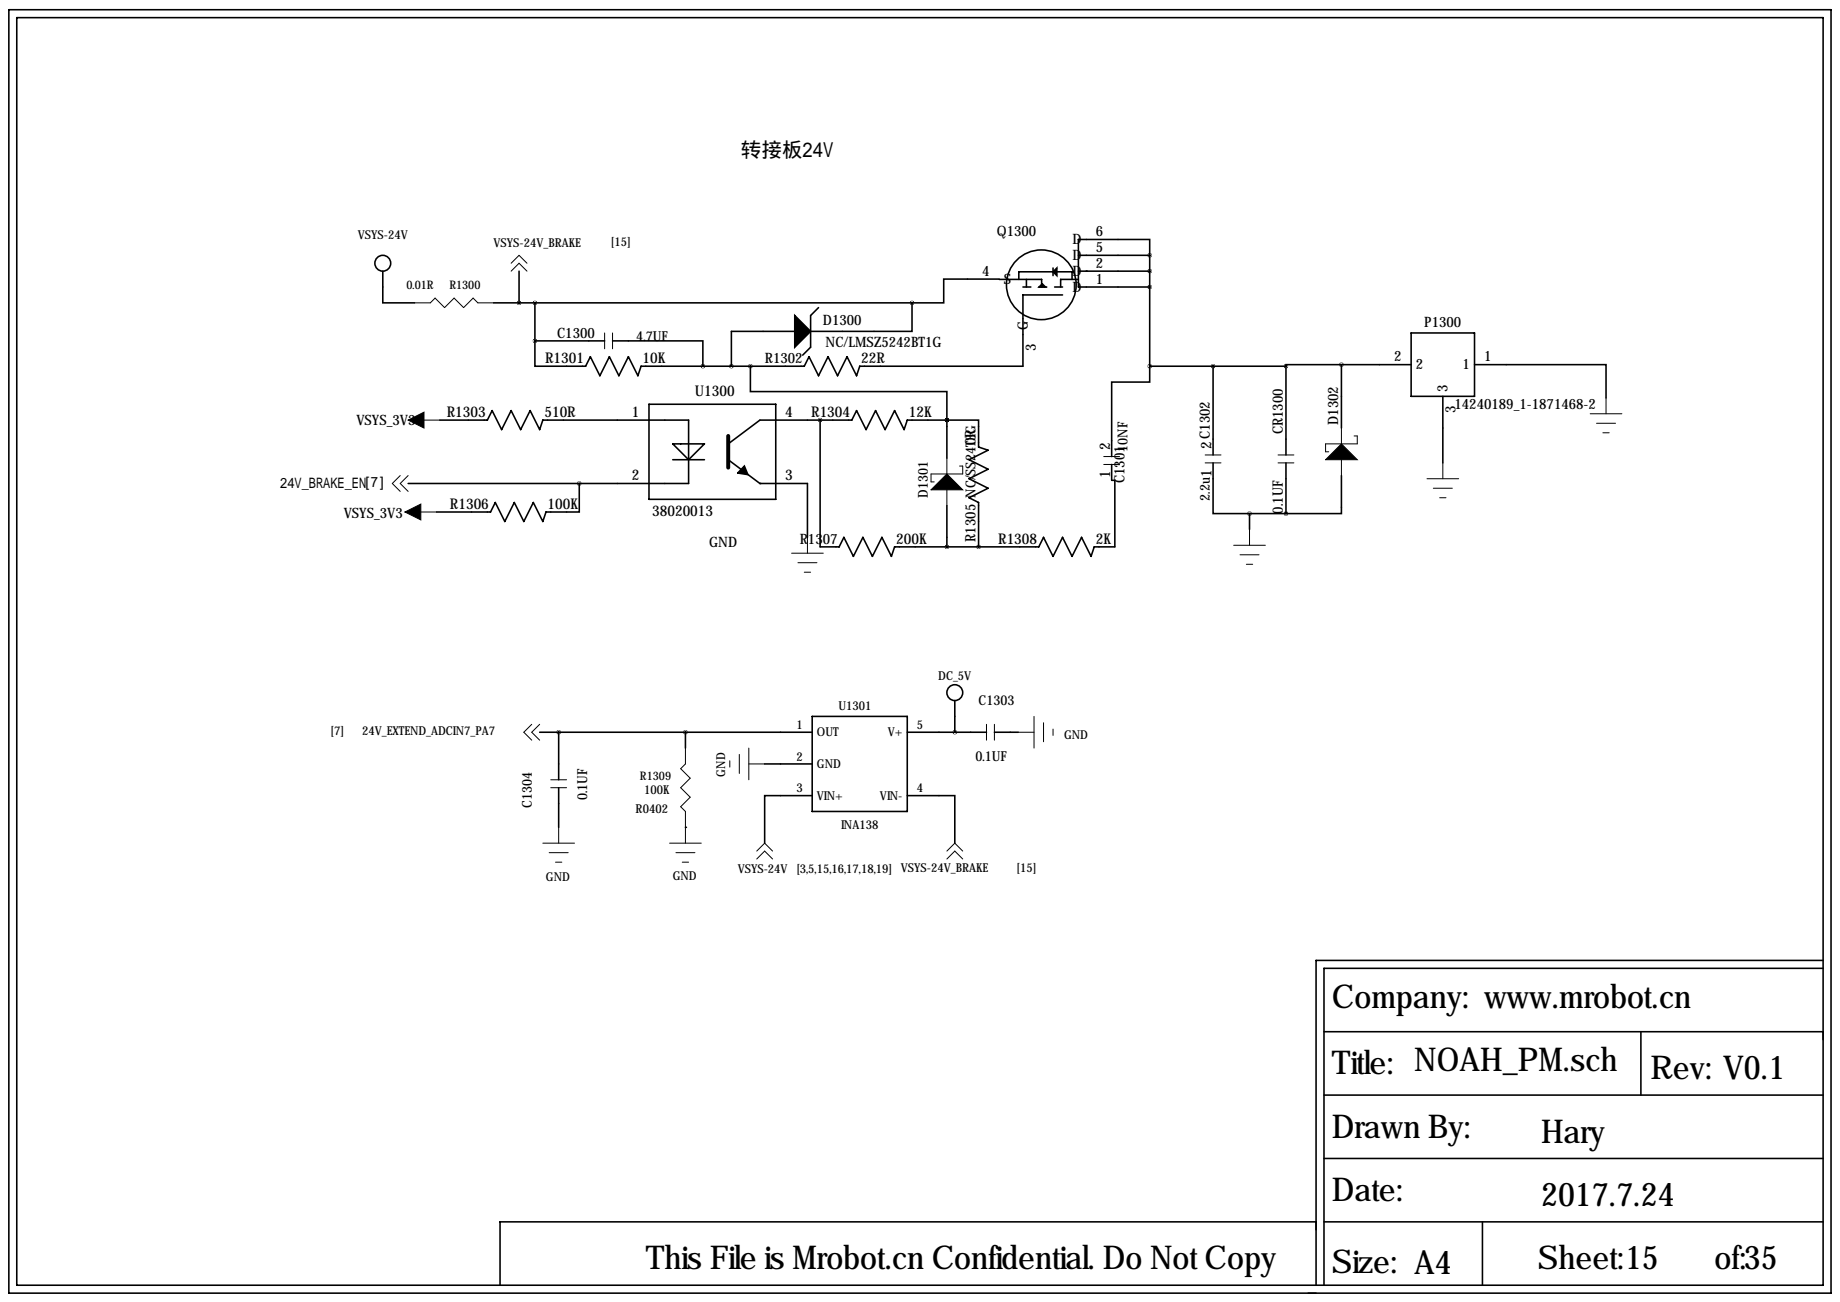
[picture p15: page 15]

Company: www.mrobot.cn

## ¼¤¹âSLAM 24V

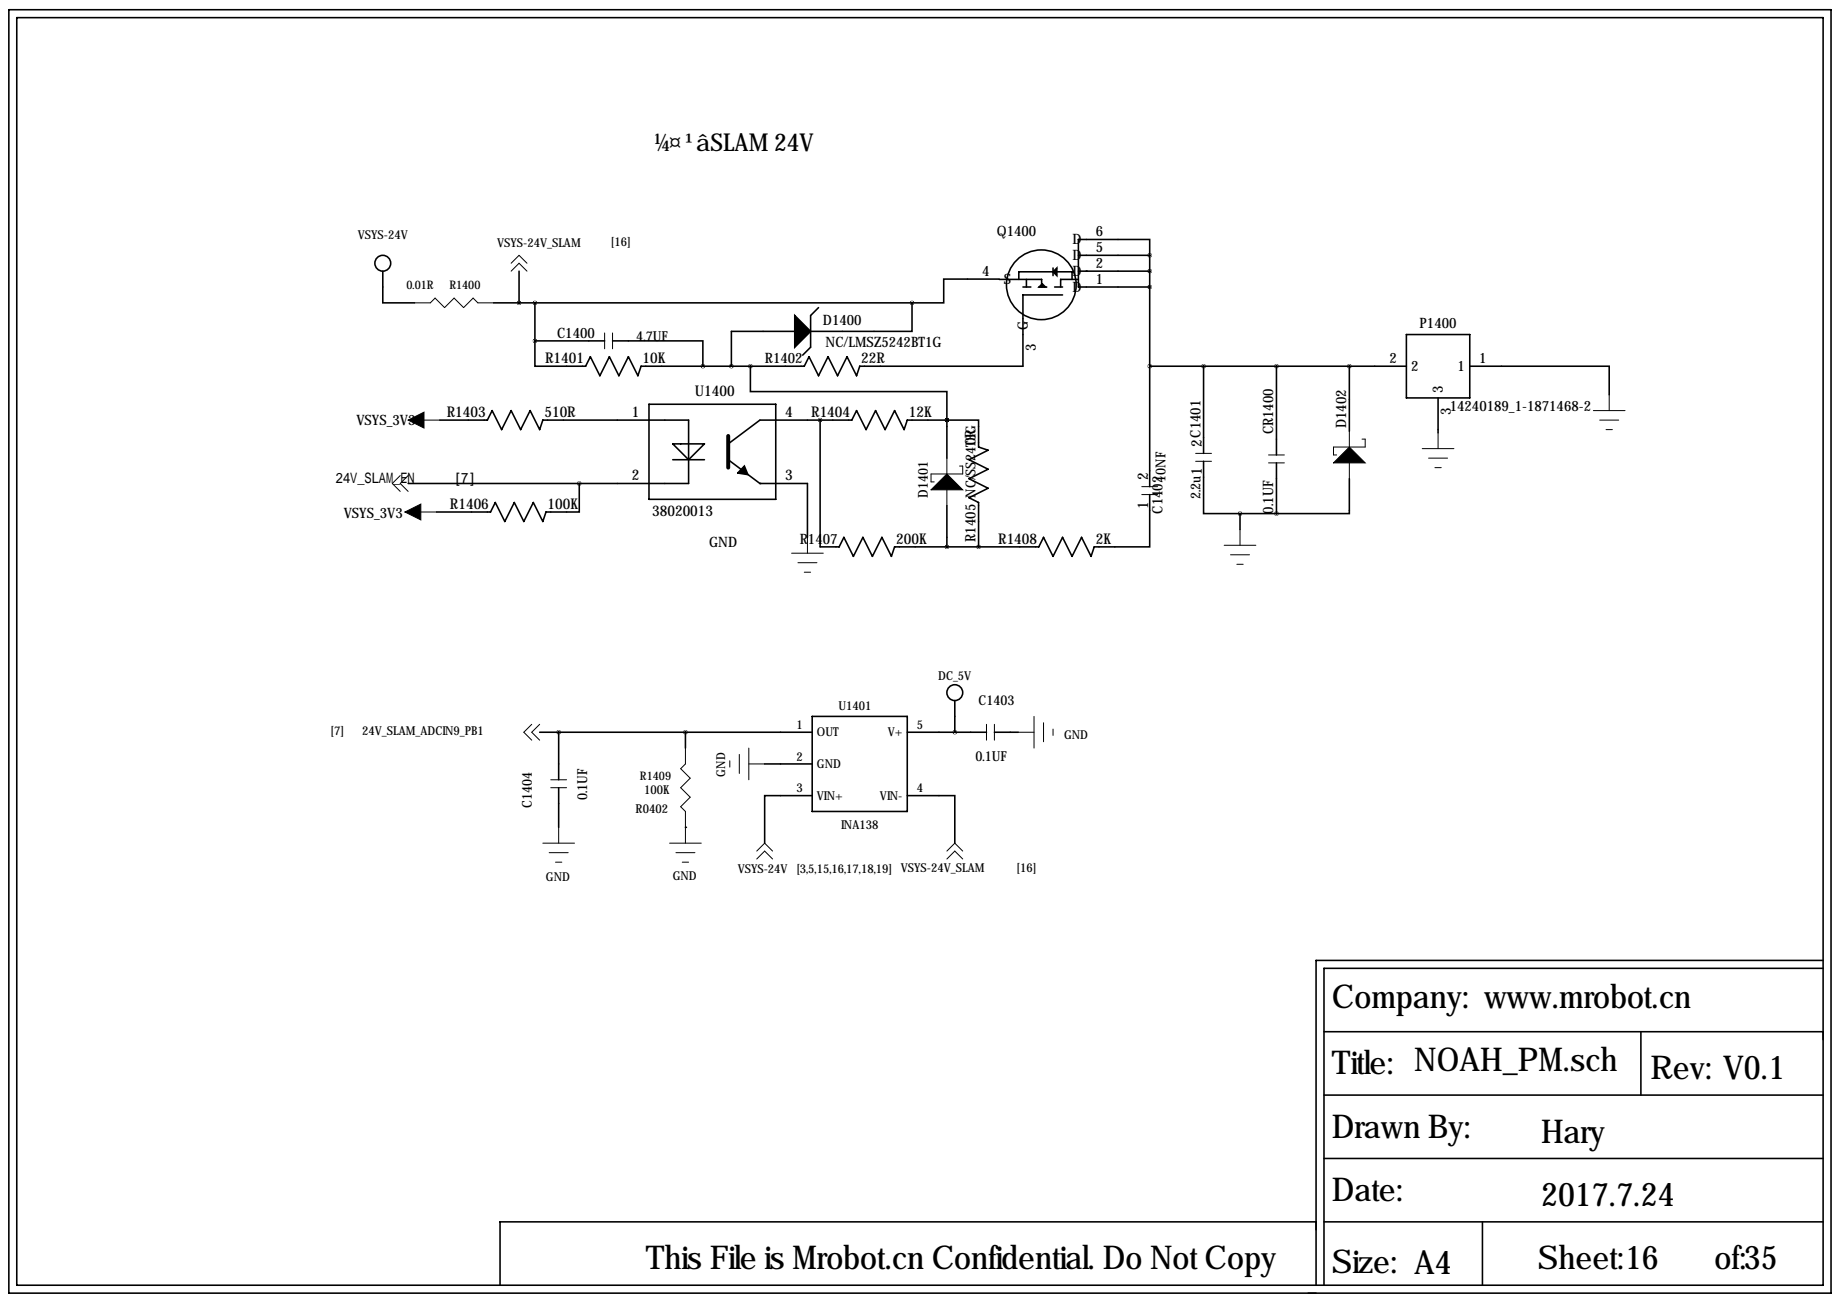
[picture p16: page 16]

Company: www.mrobot.cn

## NV板 24V

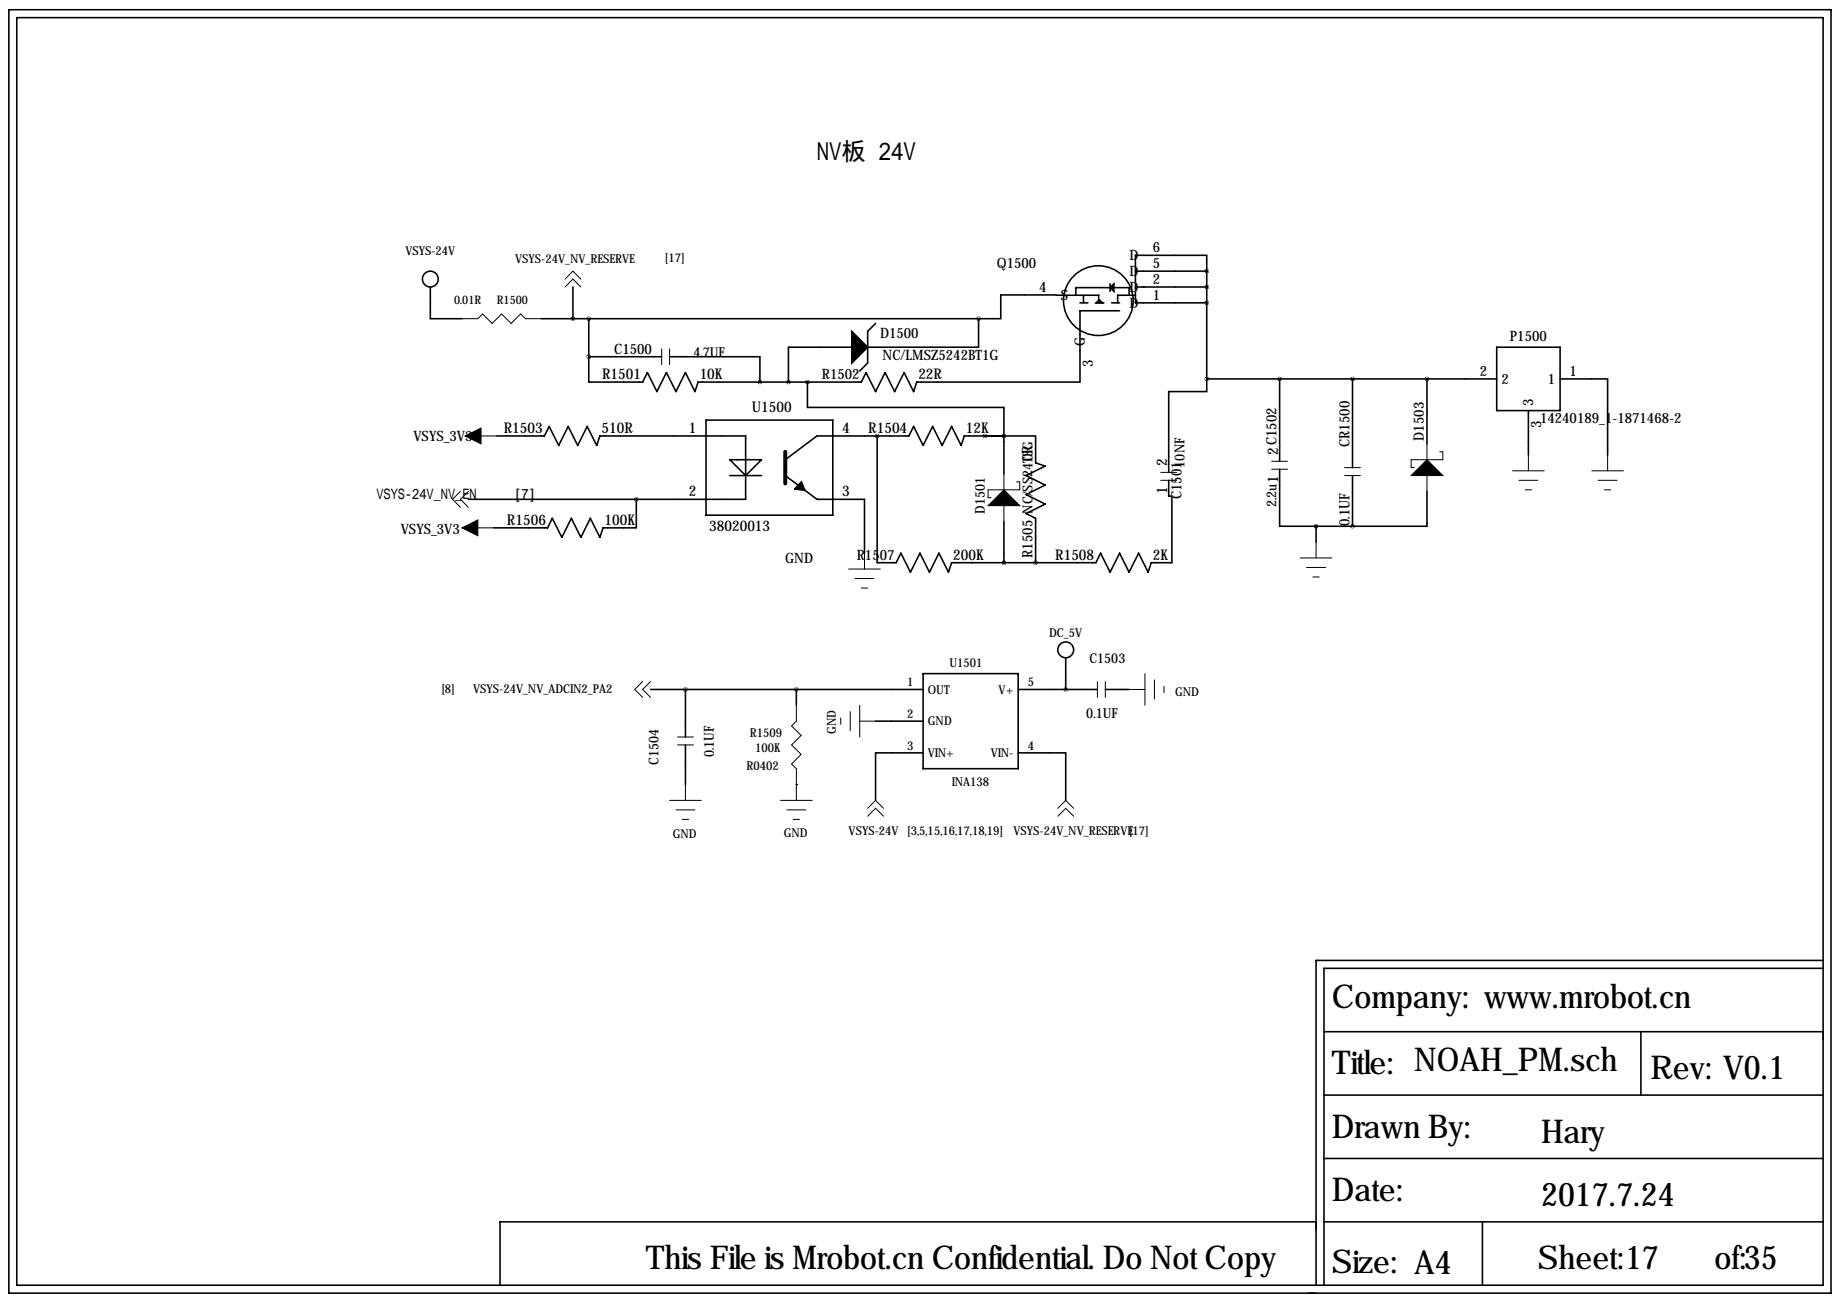
[picture p17: page 17]

Company: www.mrobot.cn

## 预留 24V

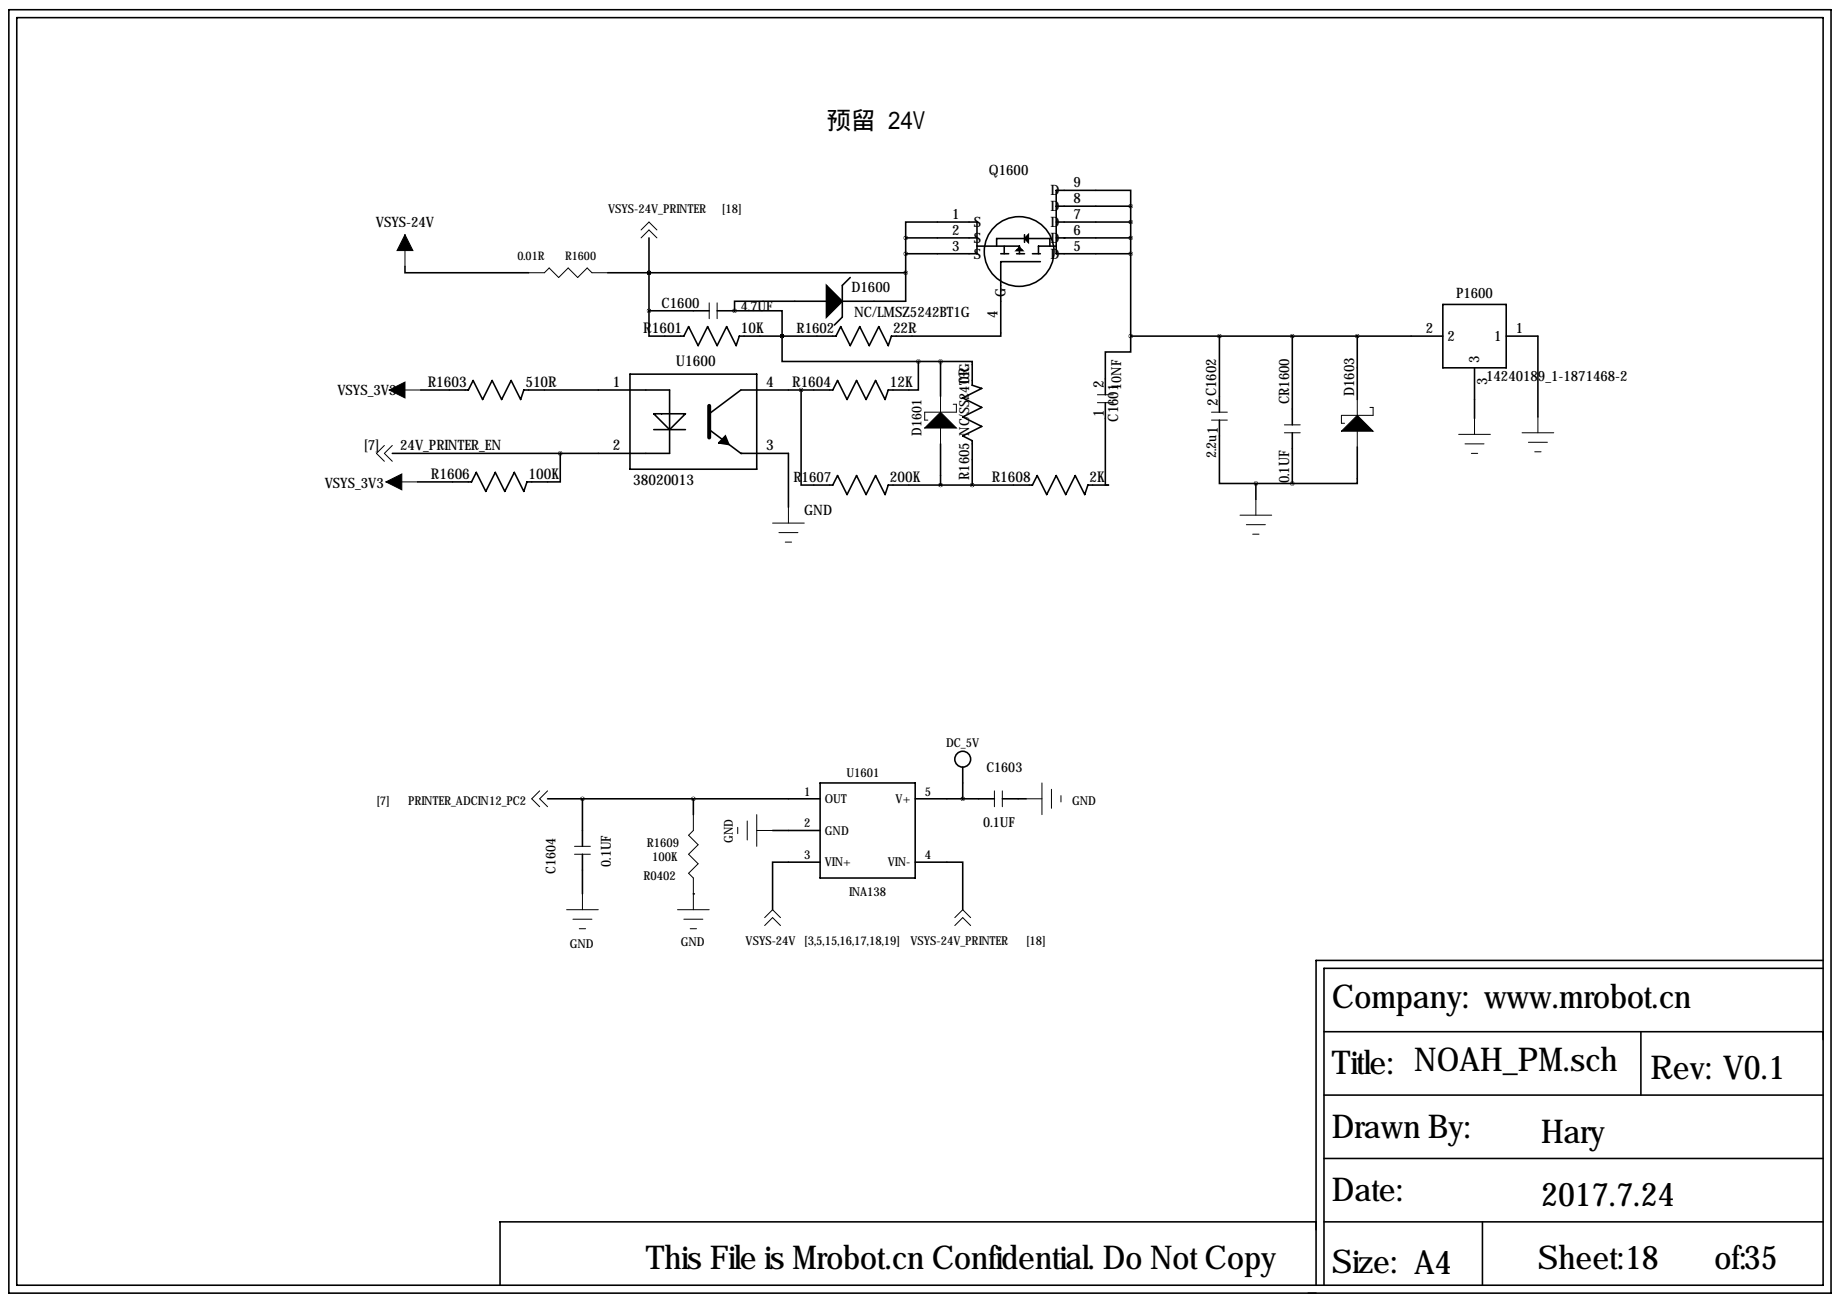
[picture p18: page 18]

Company: www.mrobot.cn

## FAN

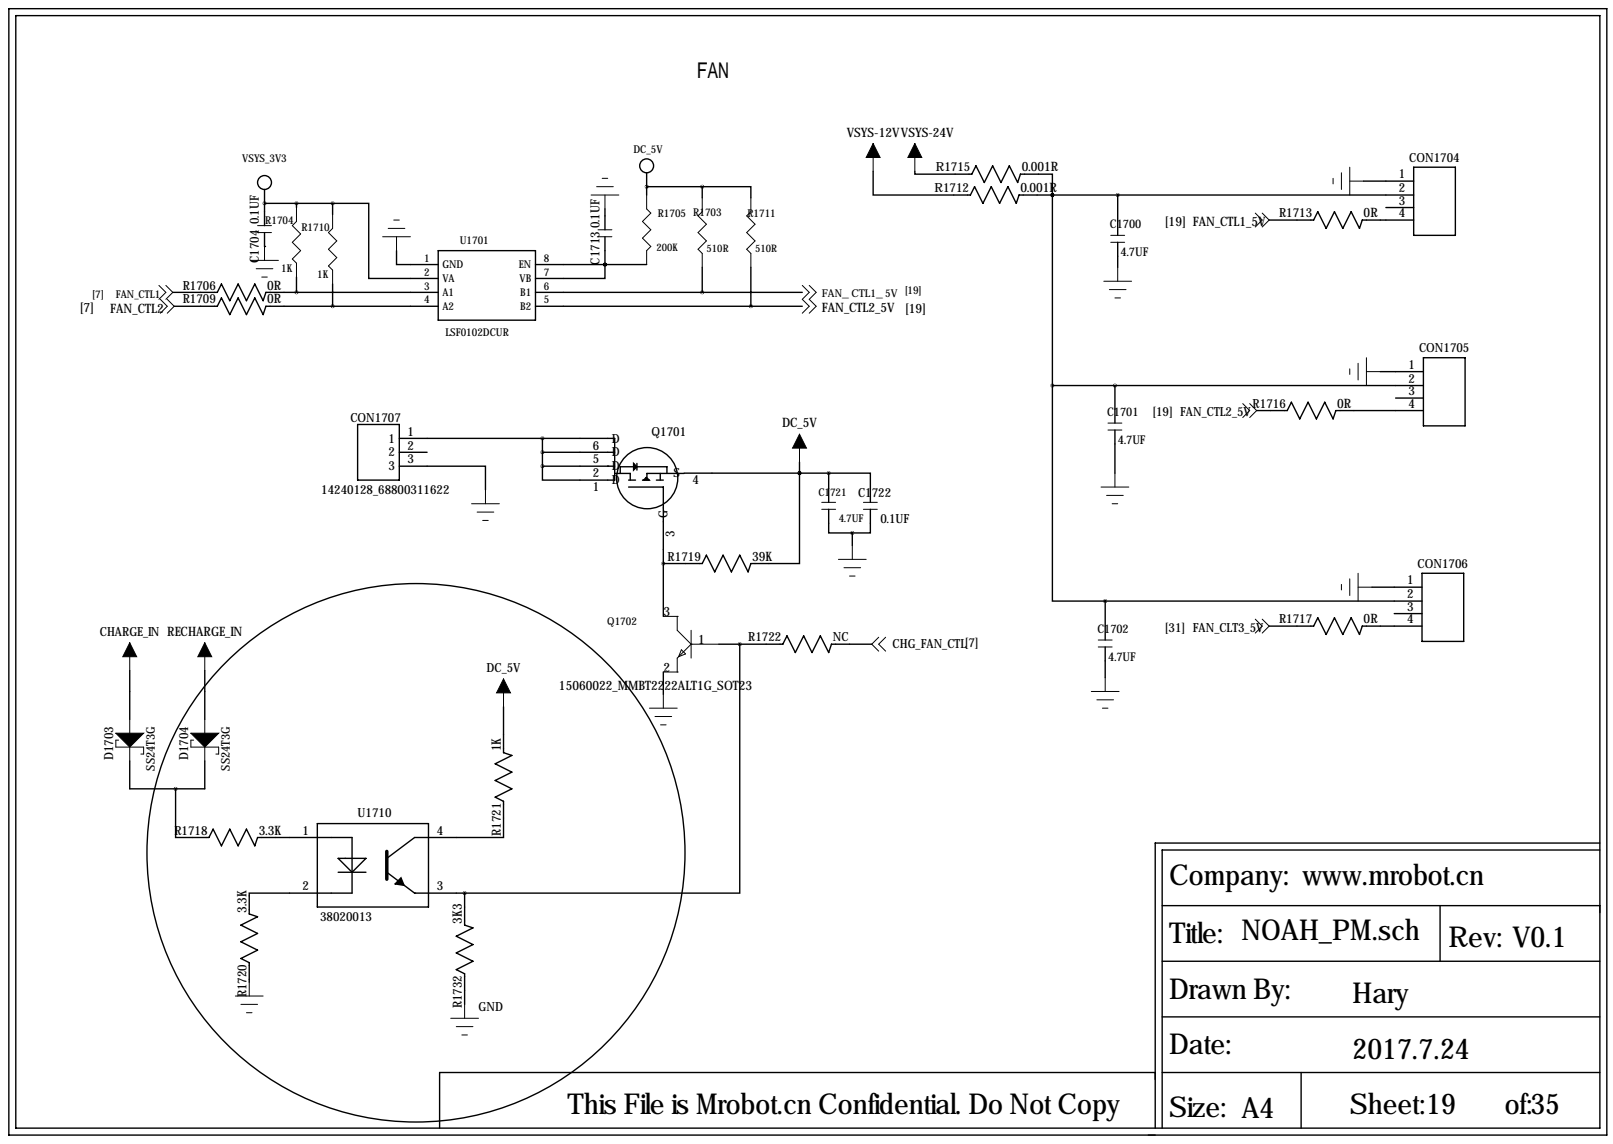
[picture p19: page 19]

Company: www.mrobot.cn

## 2.0声道 PA 12V

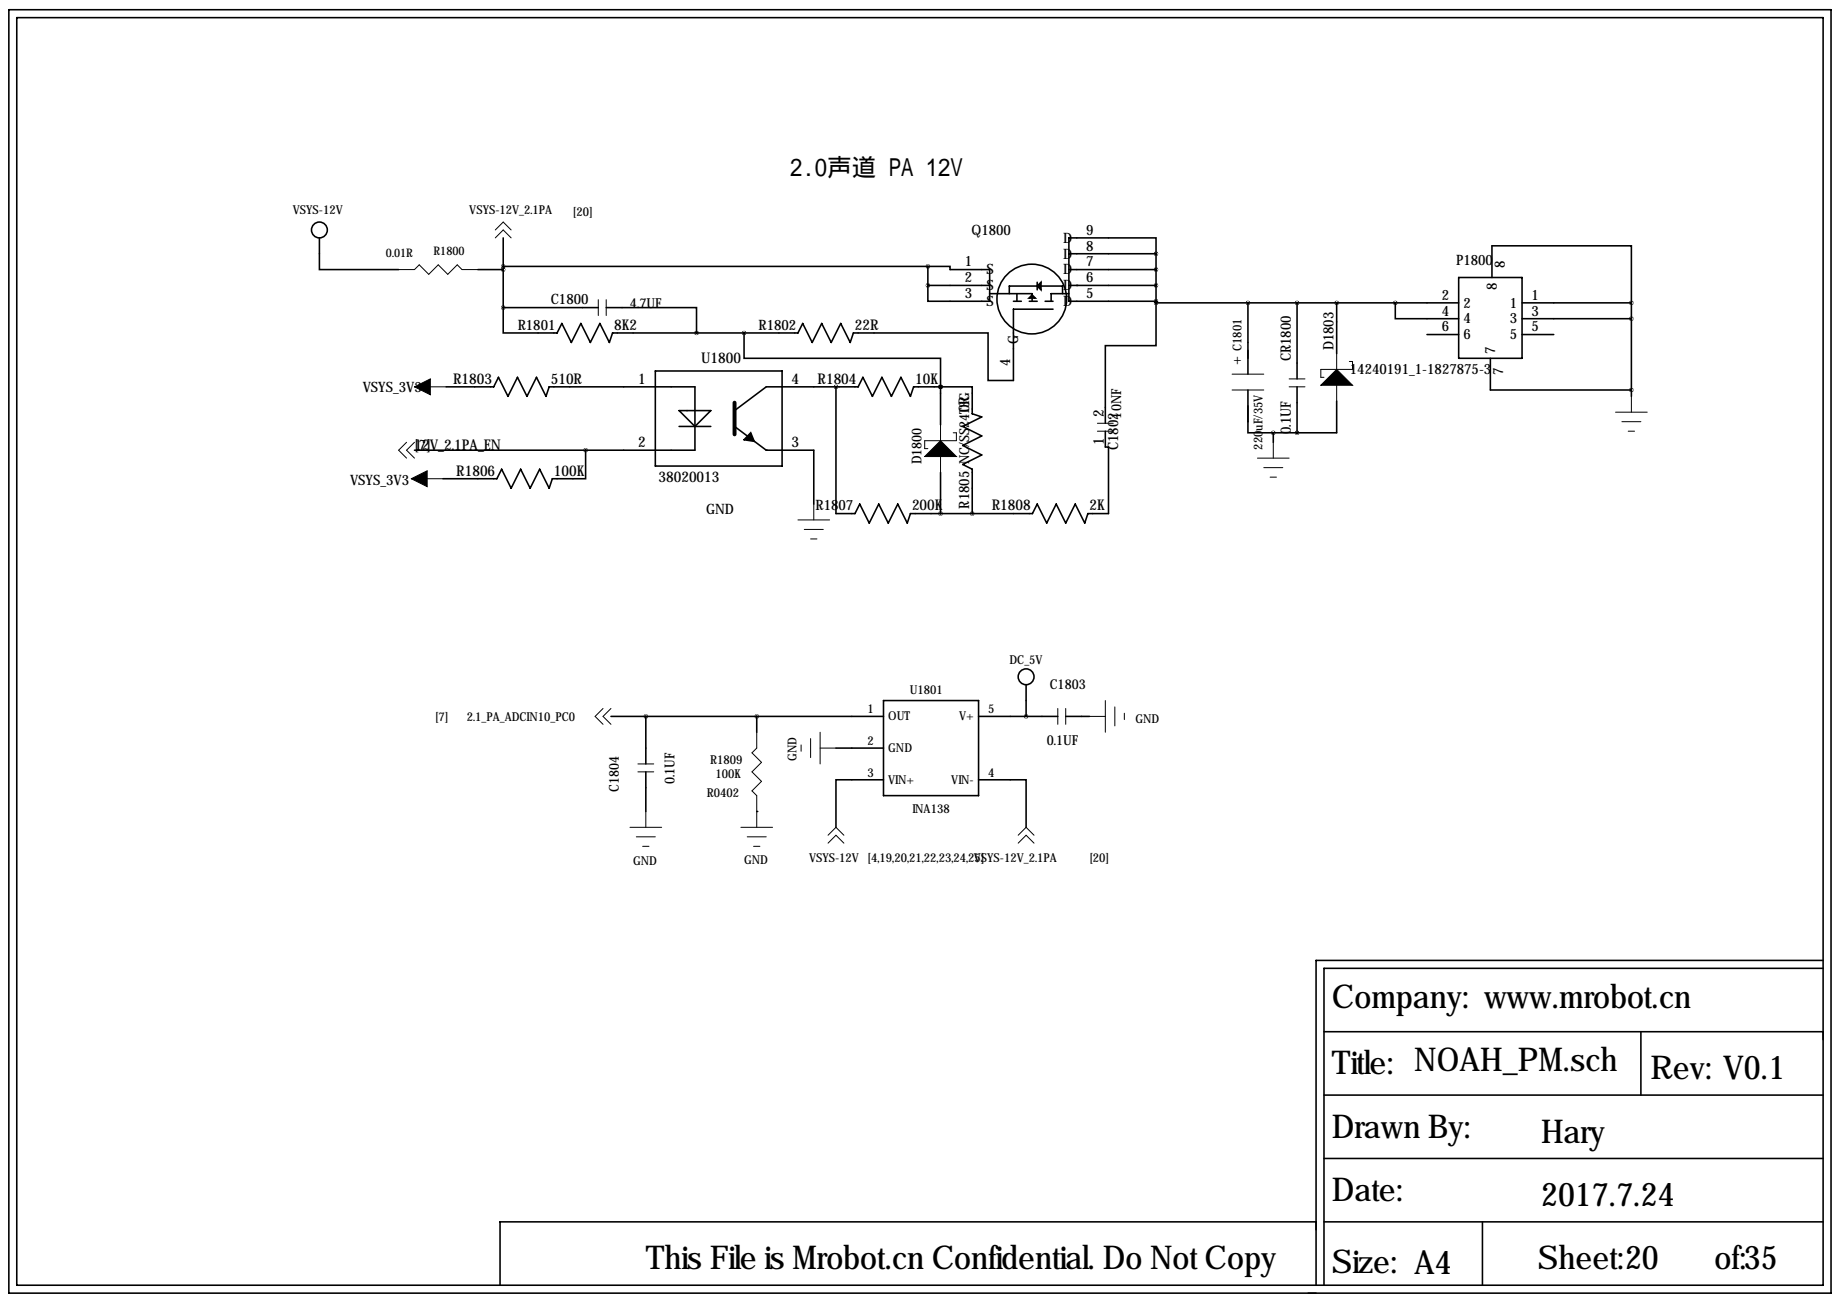
[picture p20: page 20]

Company: www.mrobot.cn

## RK板 12V

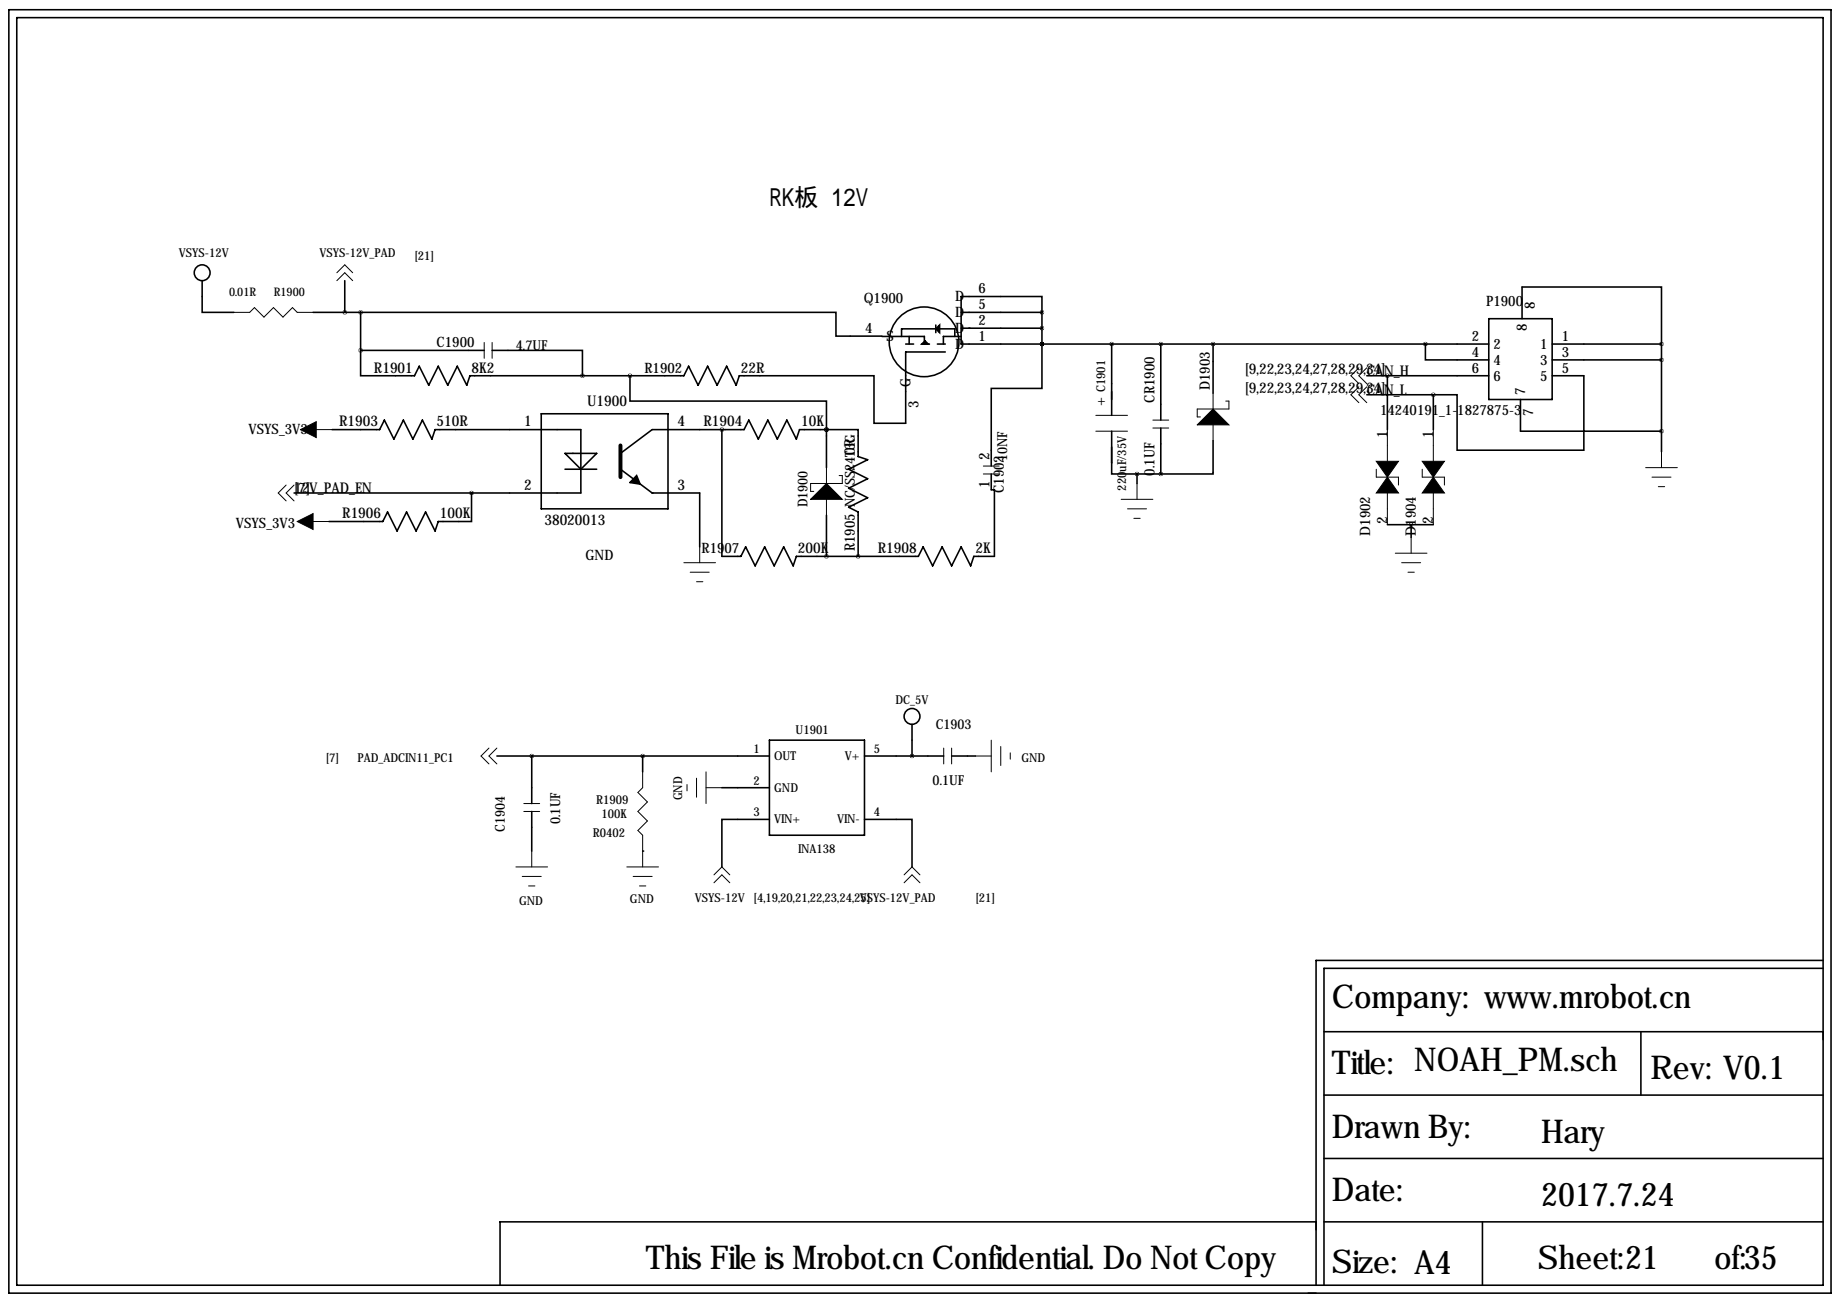
[picture p21: page 21]

Company: www.mrobot.cn

## X86工控板 12V

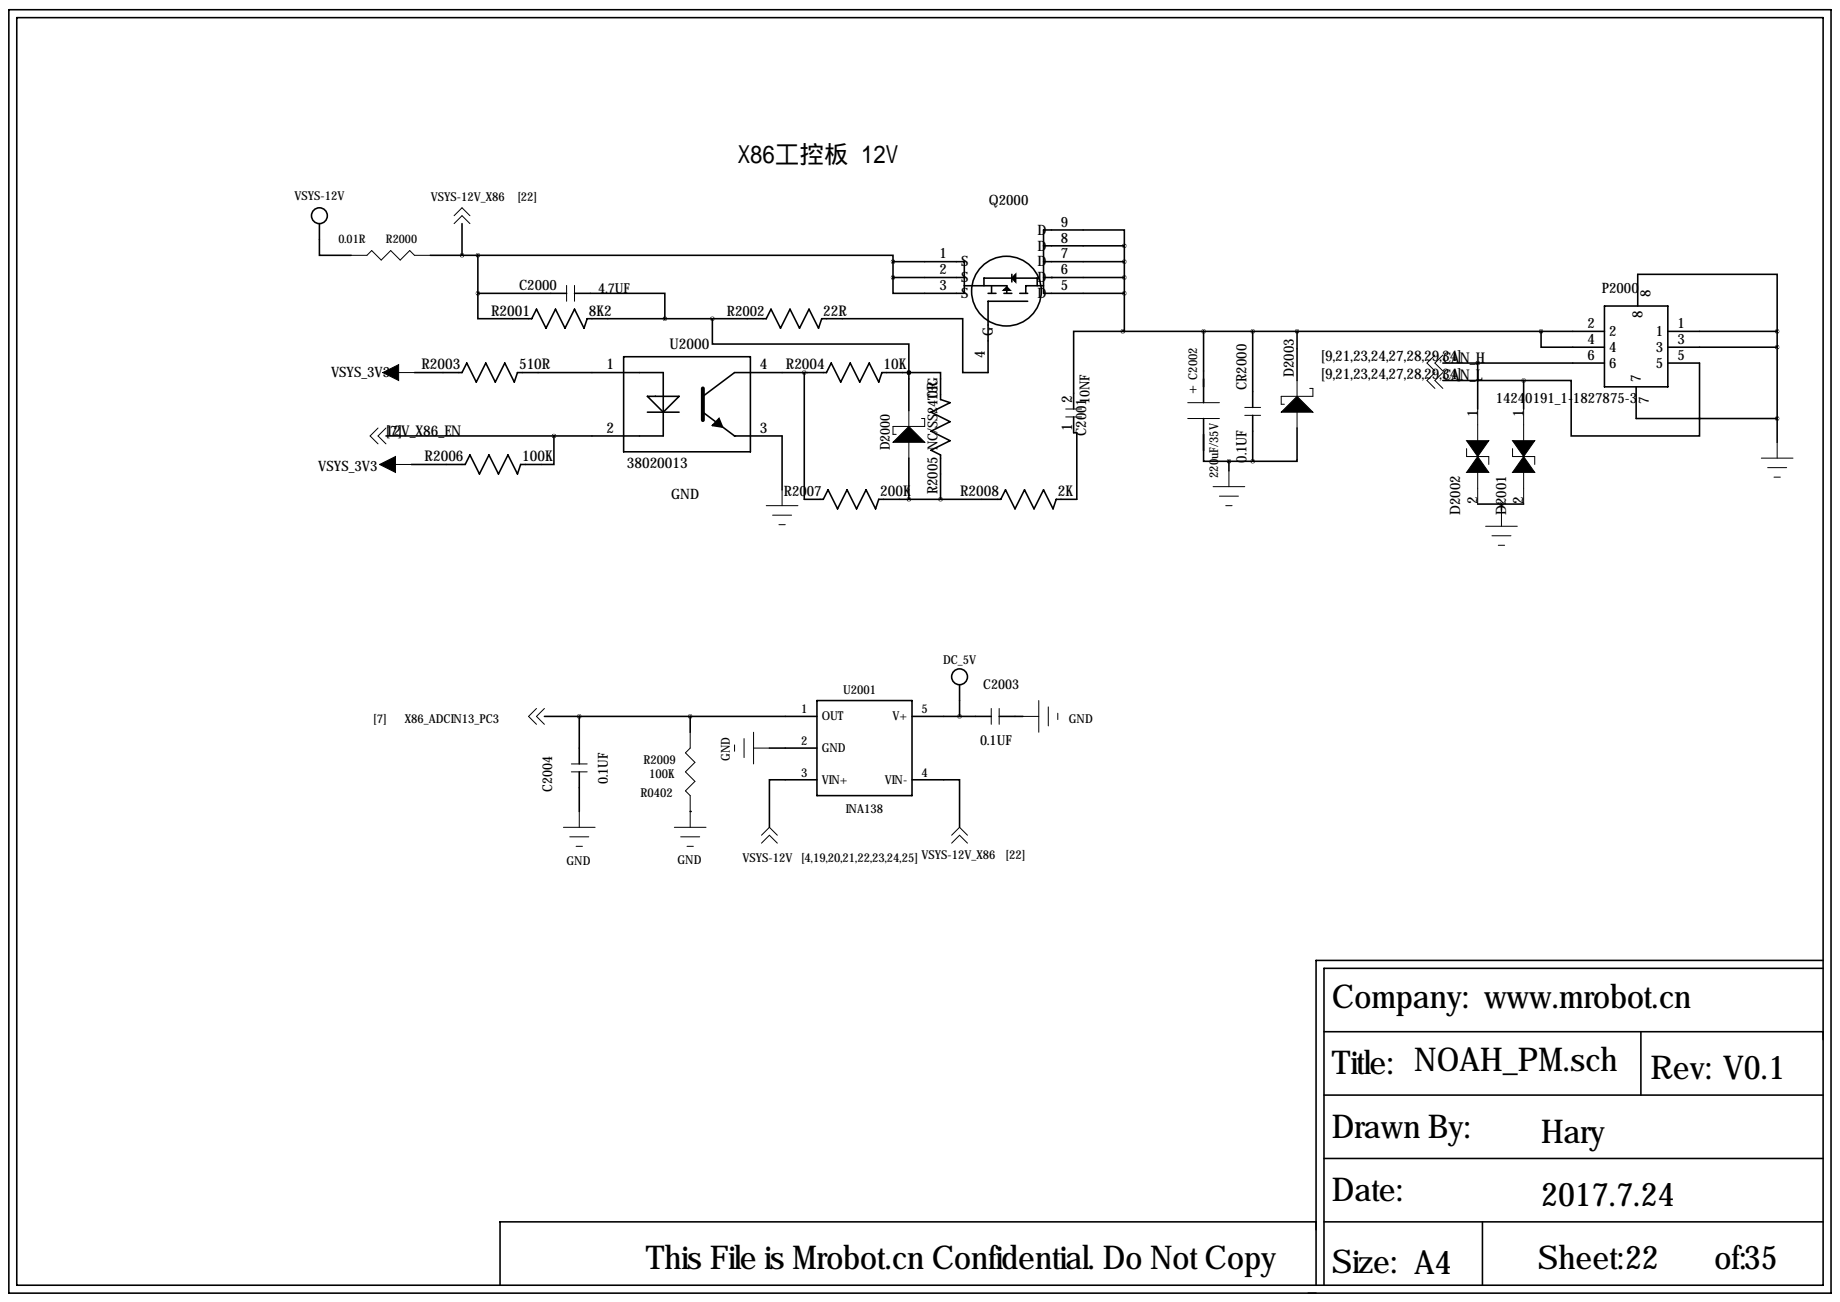
[picture p22: page 22]

Company: www.mrobot.cn

# 超声波 12V

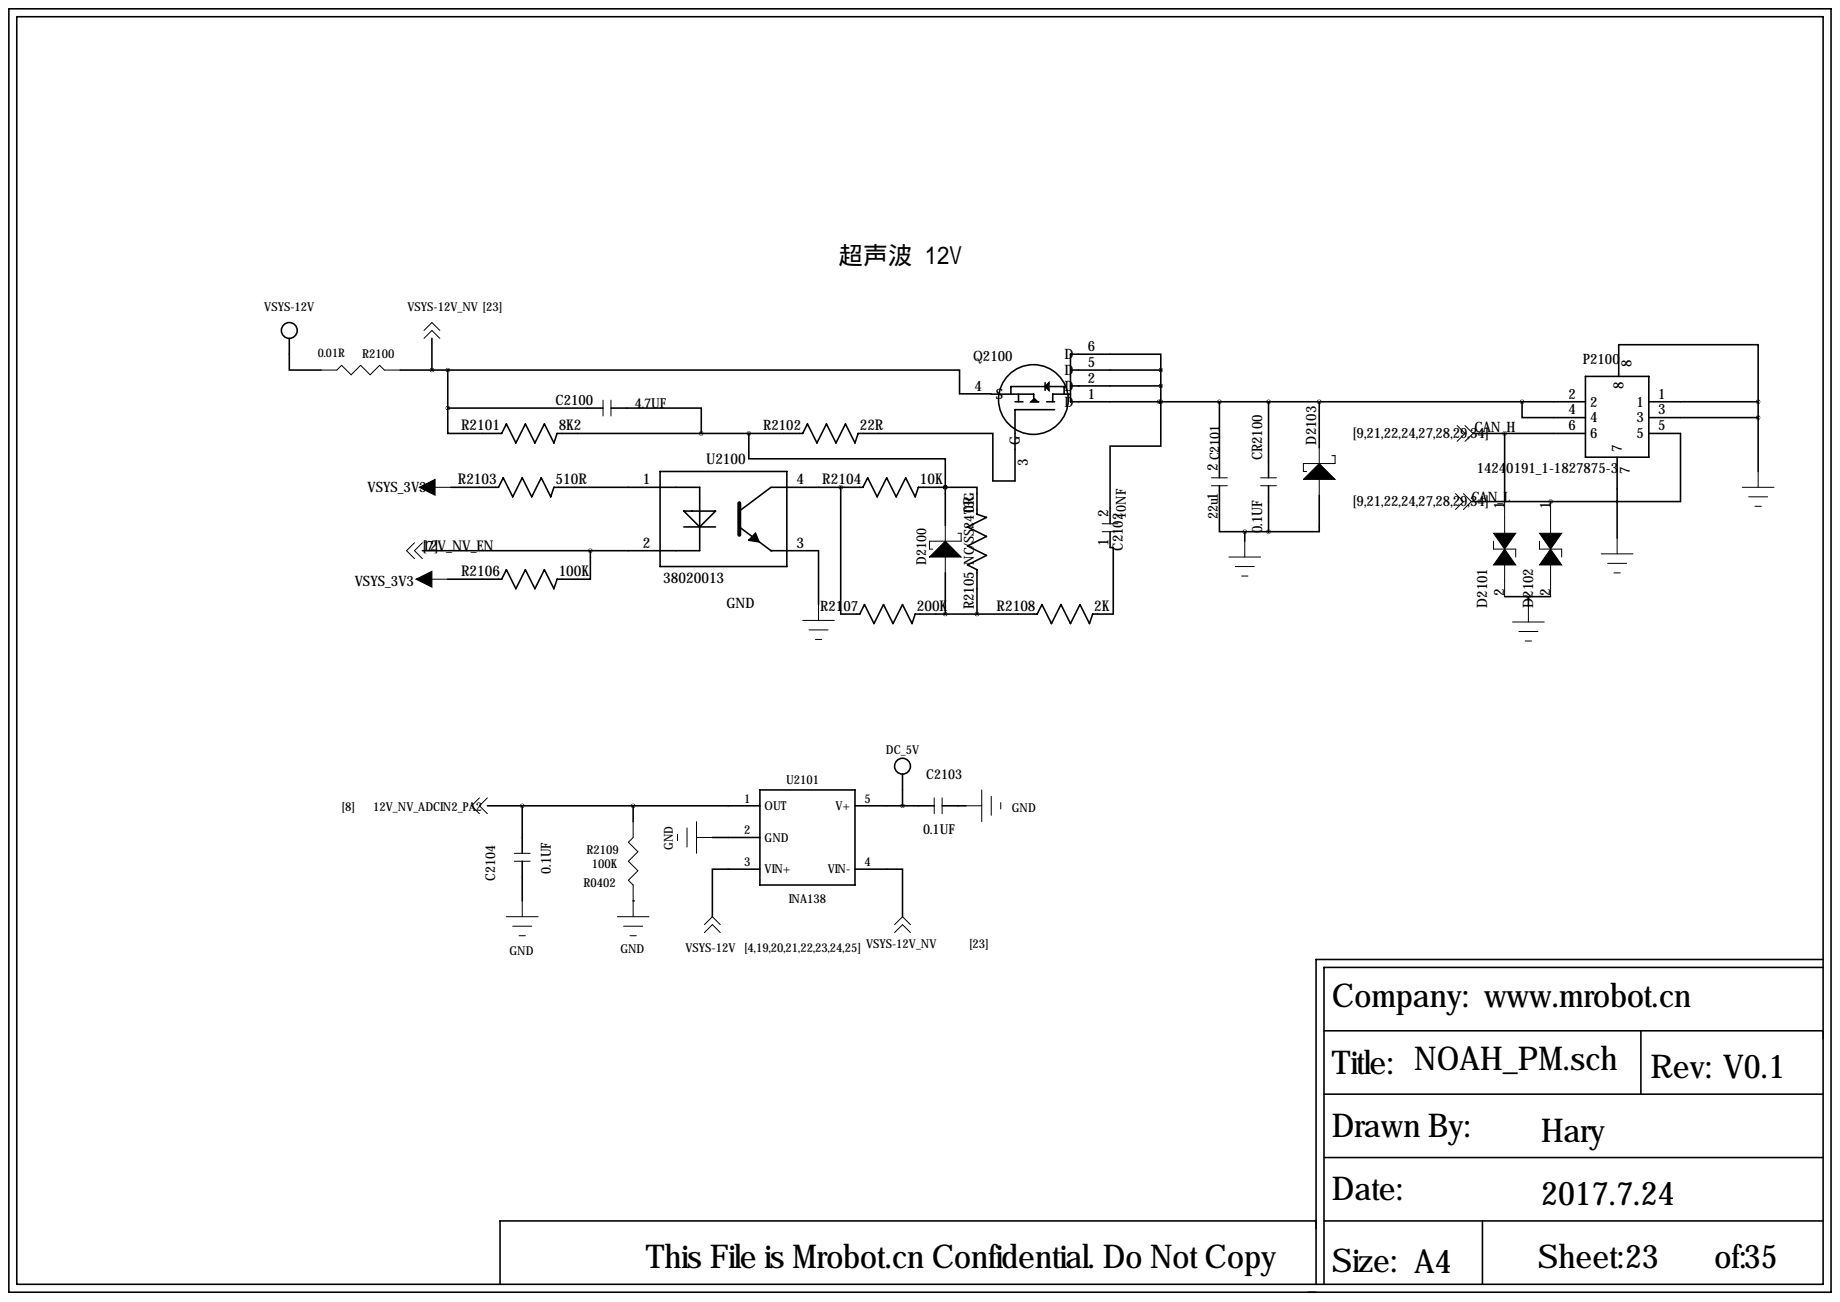
[picture p23: page 23]

Company: www.mrobot.cn

## 预留 12V

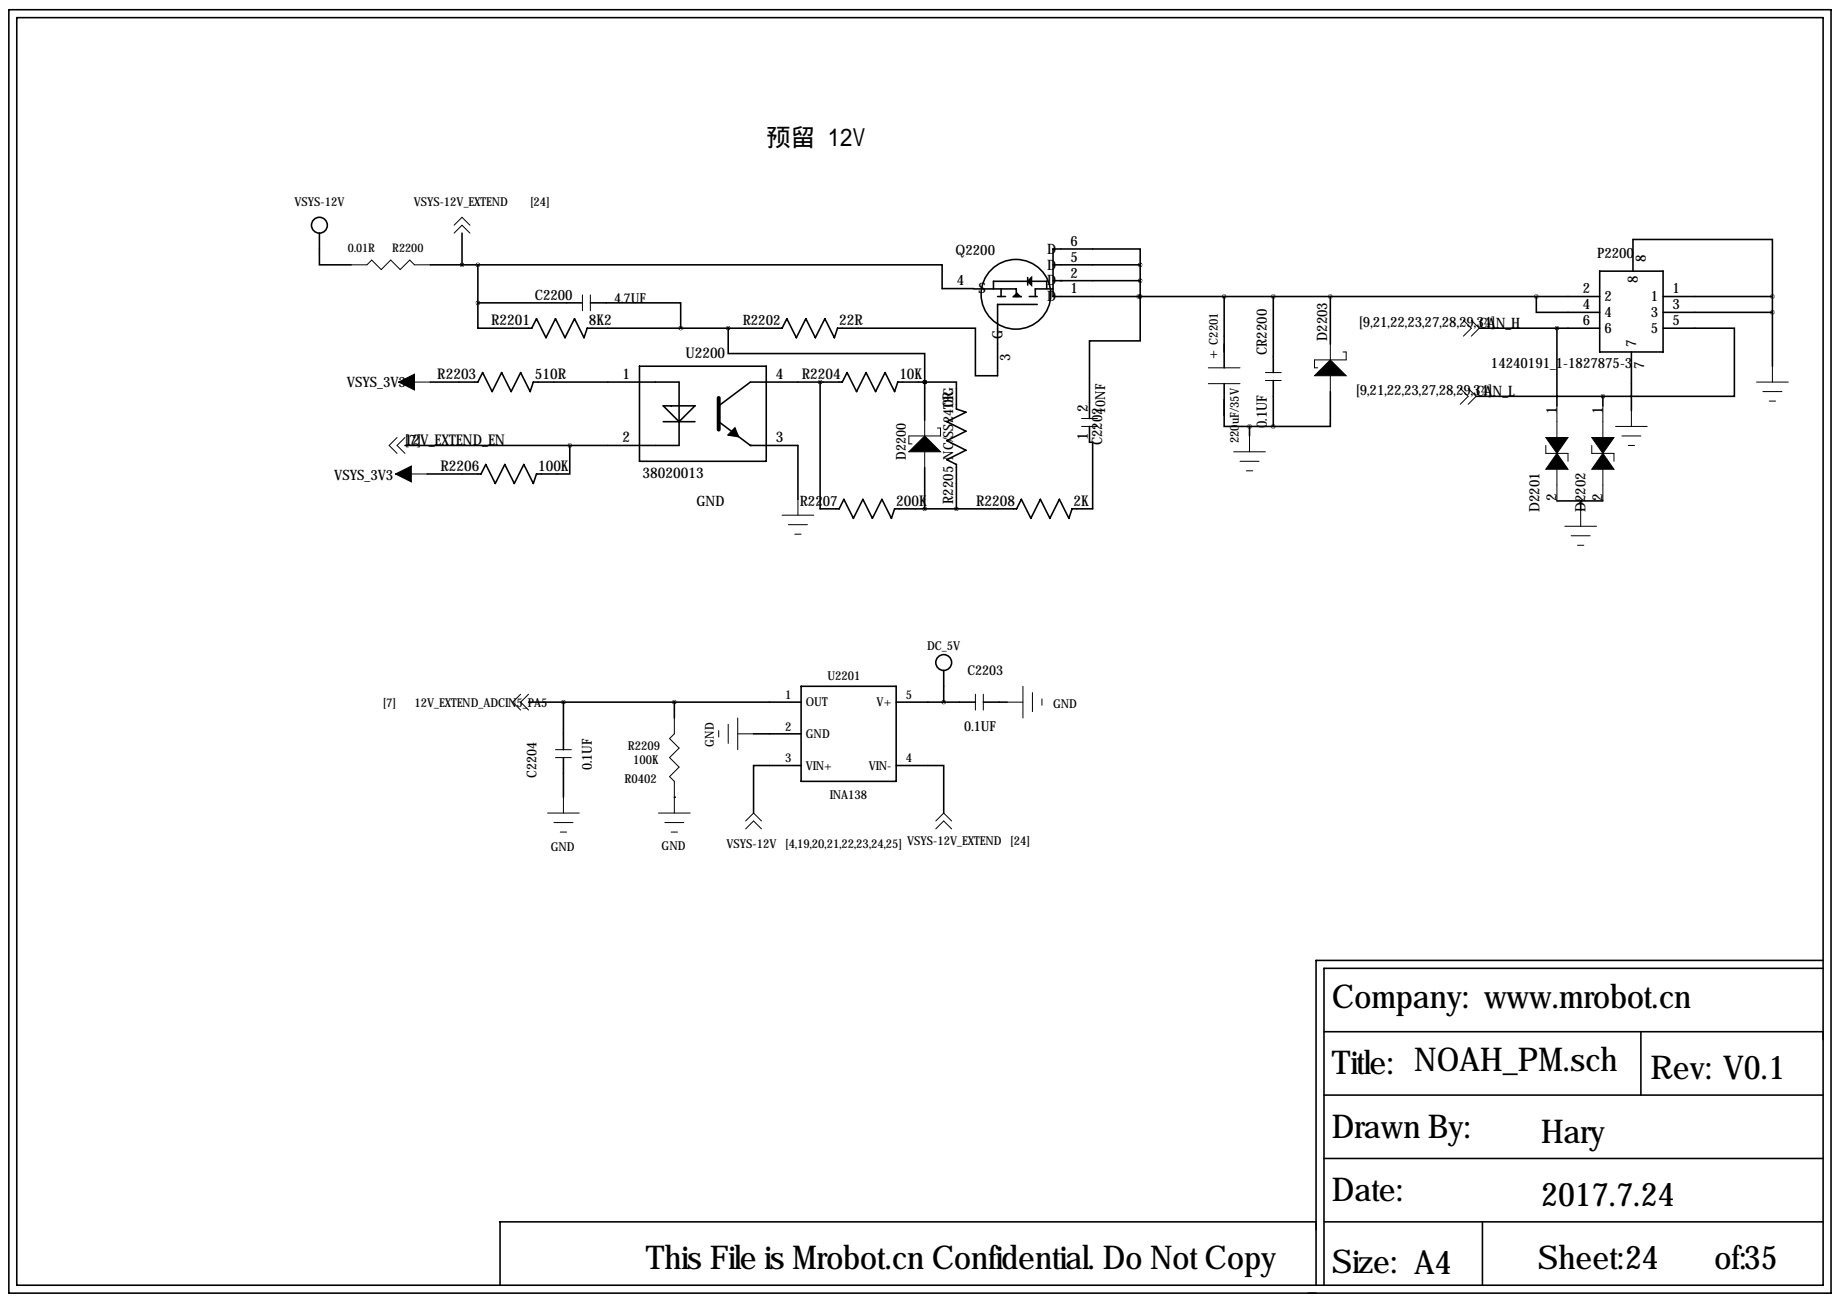
[picture p24: page 24]

Company: www.mrobot.cn

## 路由12V

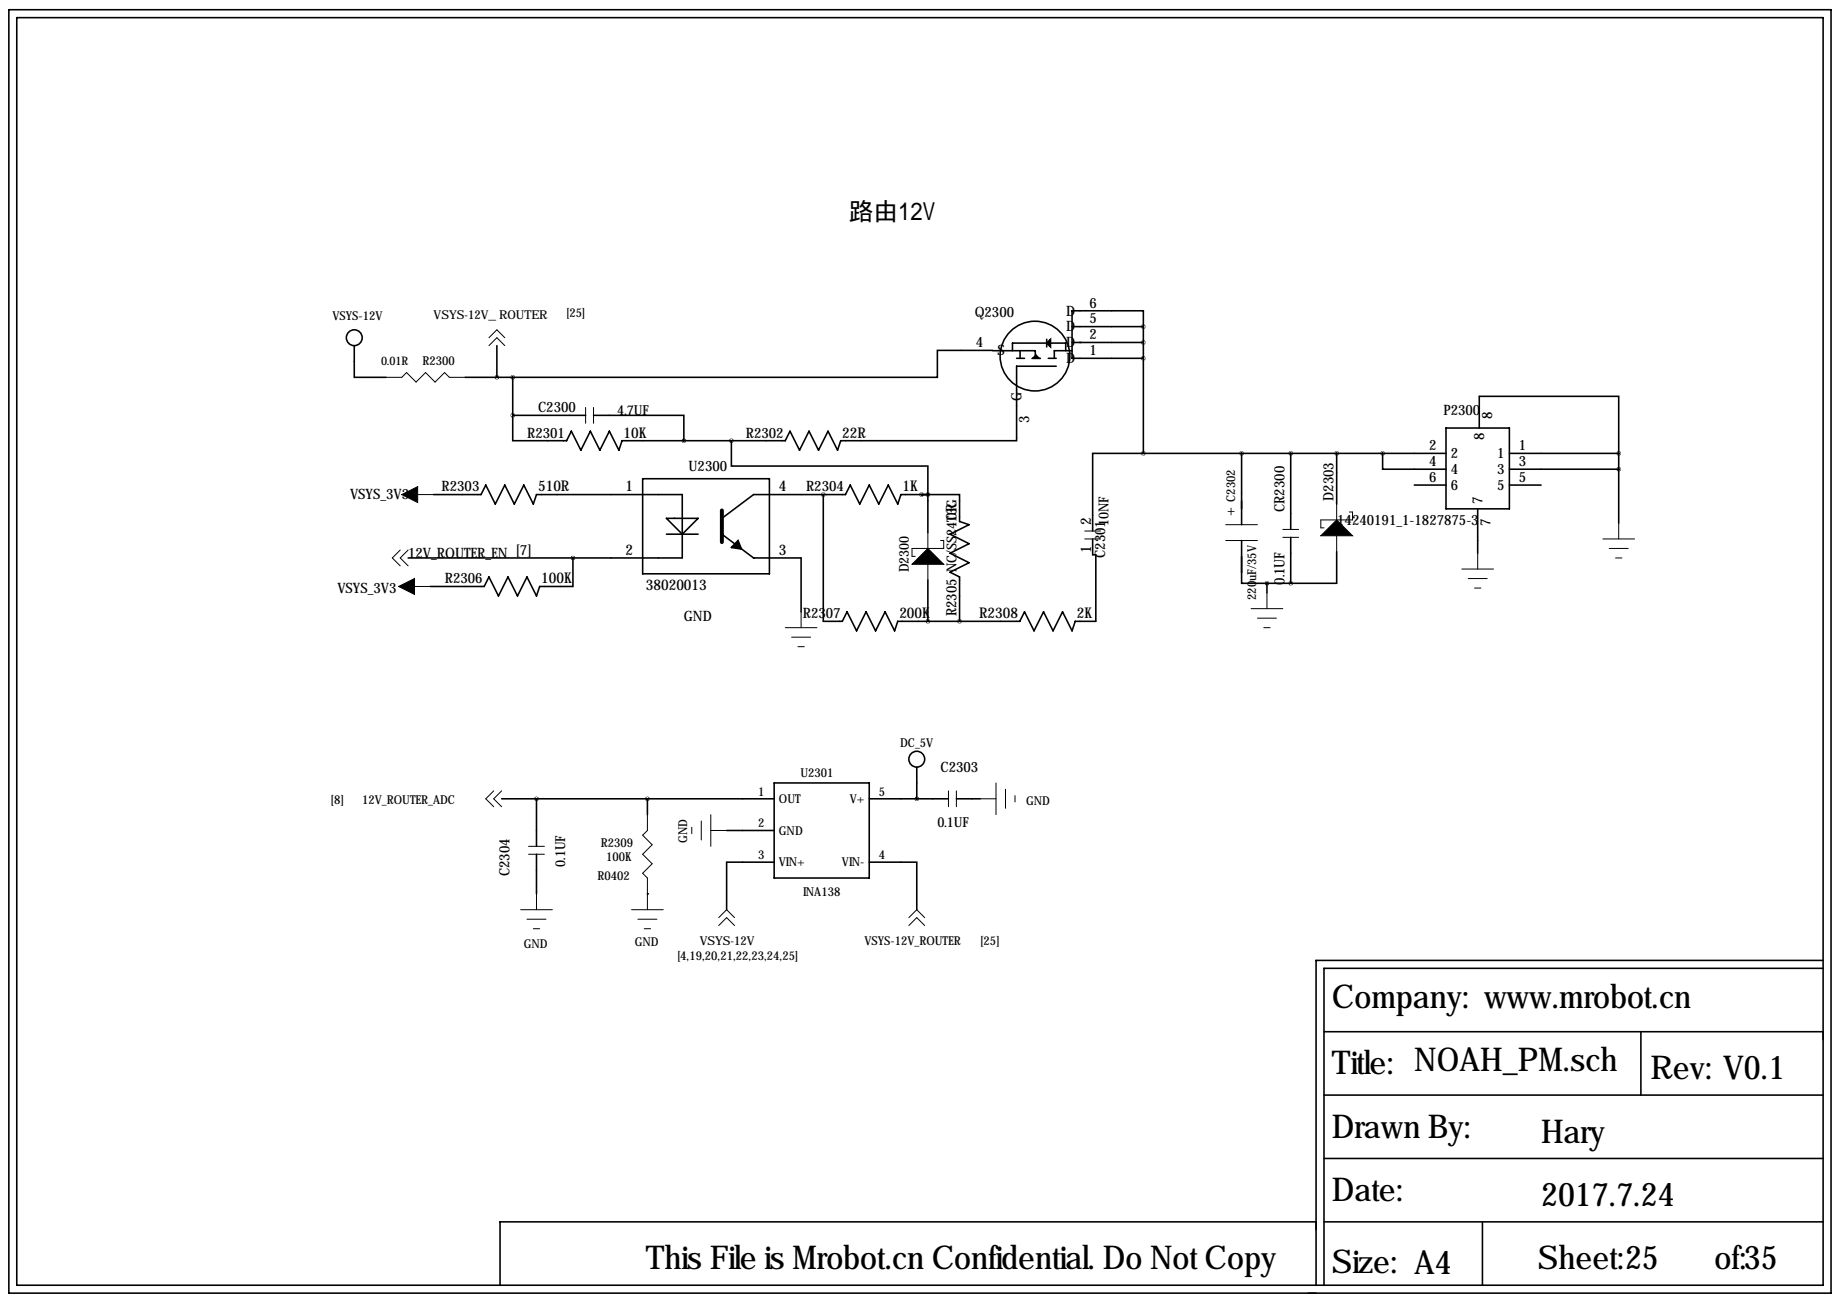
[picture p25: page 25]

Company: www.mrobot.cn

## 红外灯板 电流源

# SS24T3GR24¹2 NC

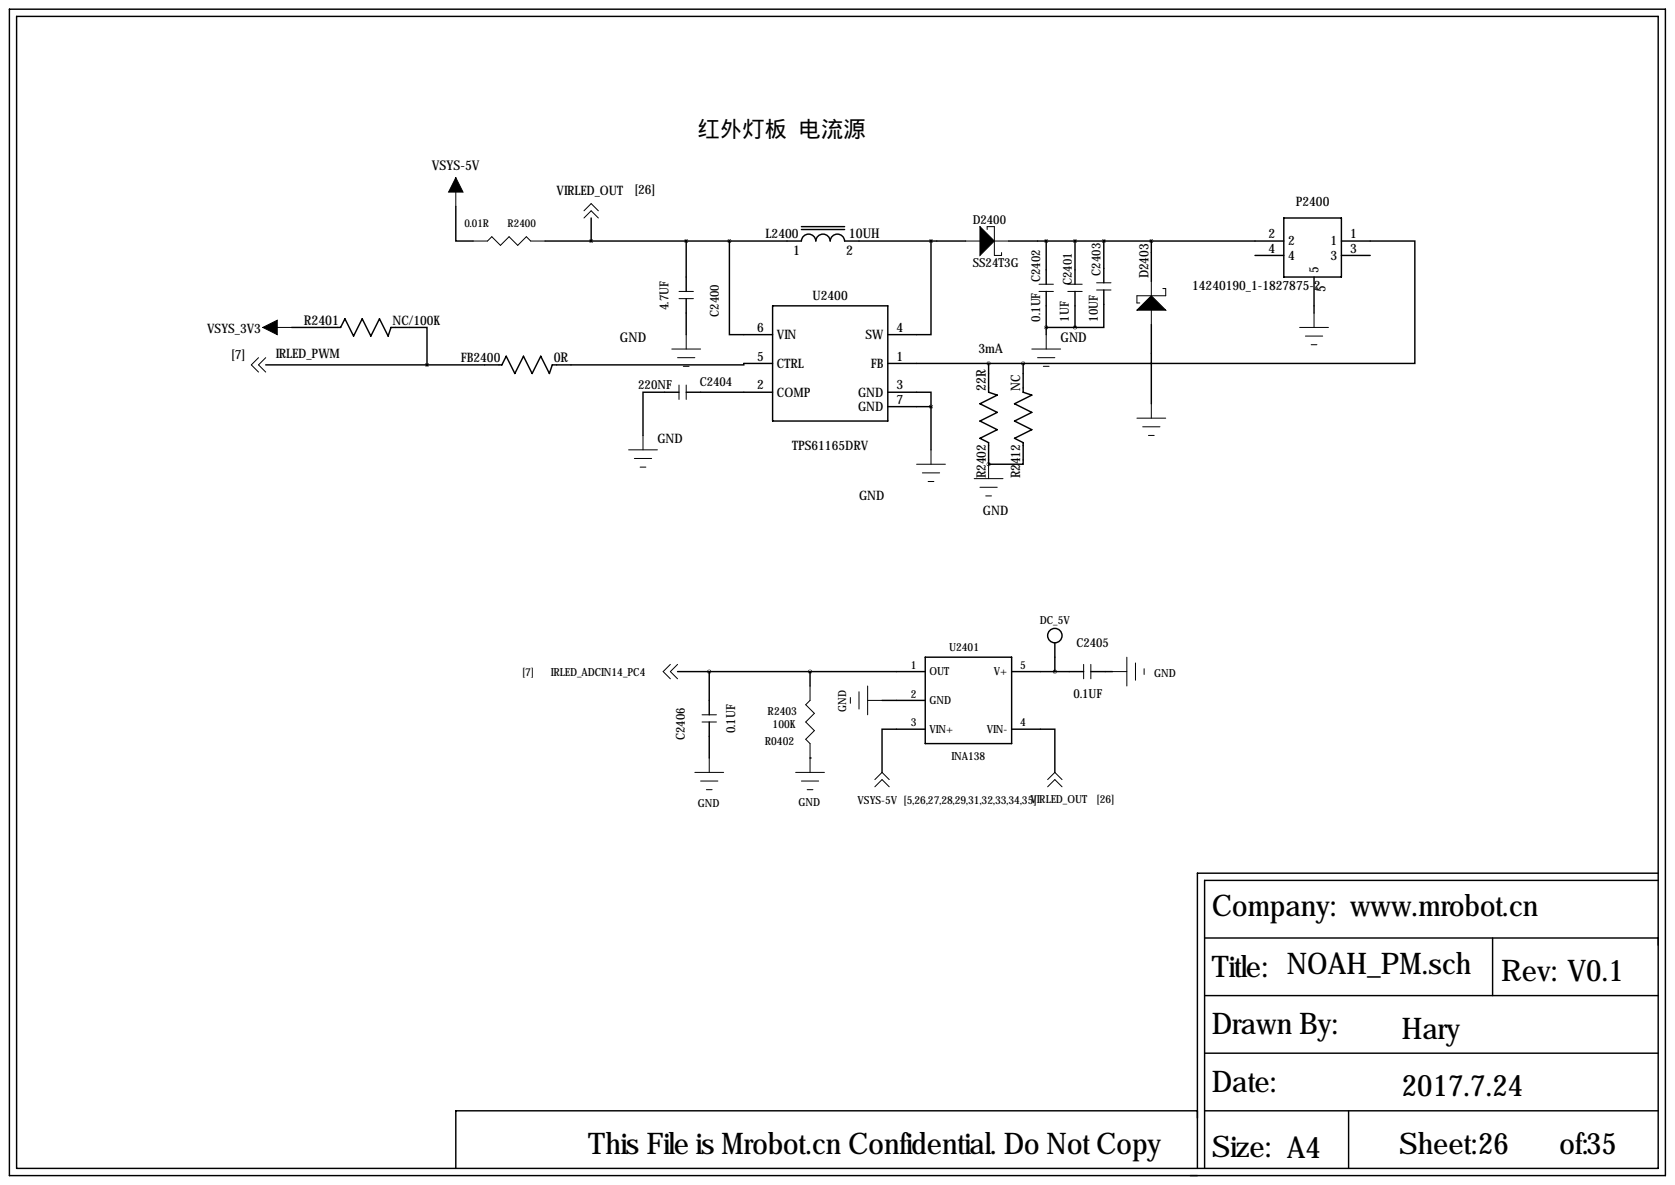
[picture p26: page 26]

Company: www.mrobot.cn

## 回充板 5V

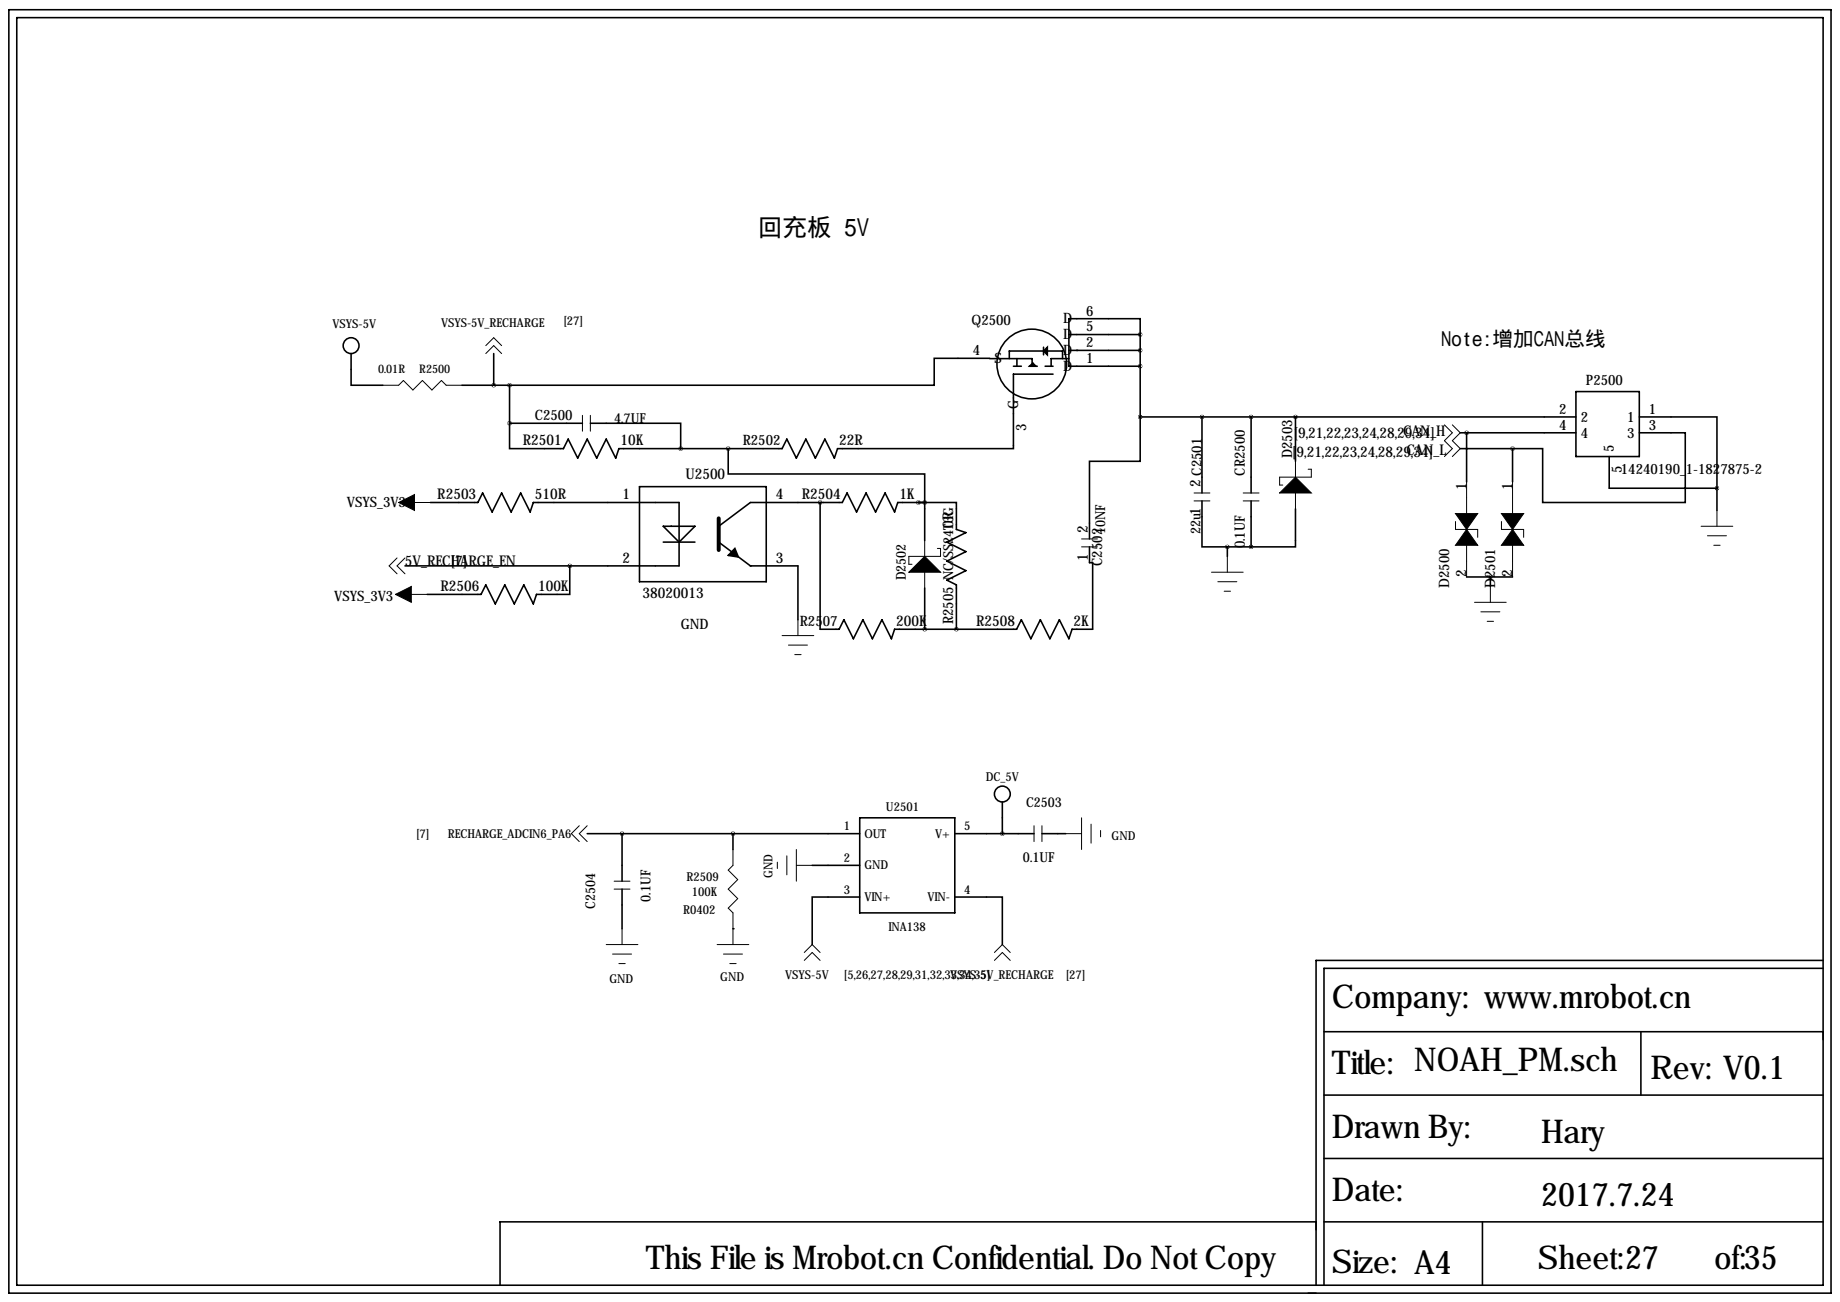
[picture p27: page 27]

Company: www.mrobot.cn

## 电机控制板5V

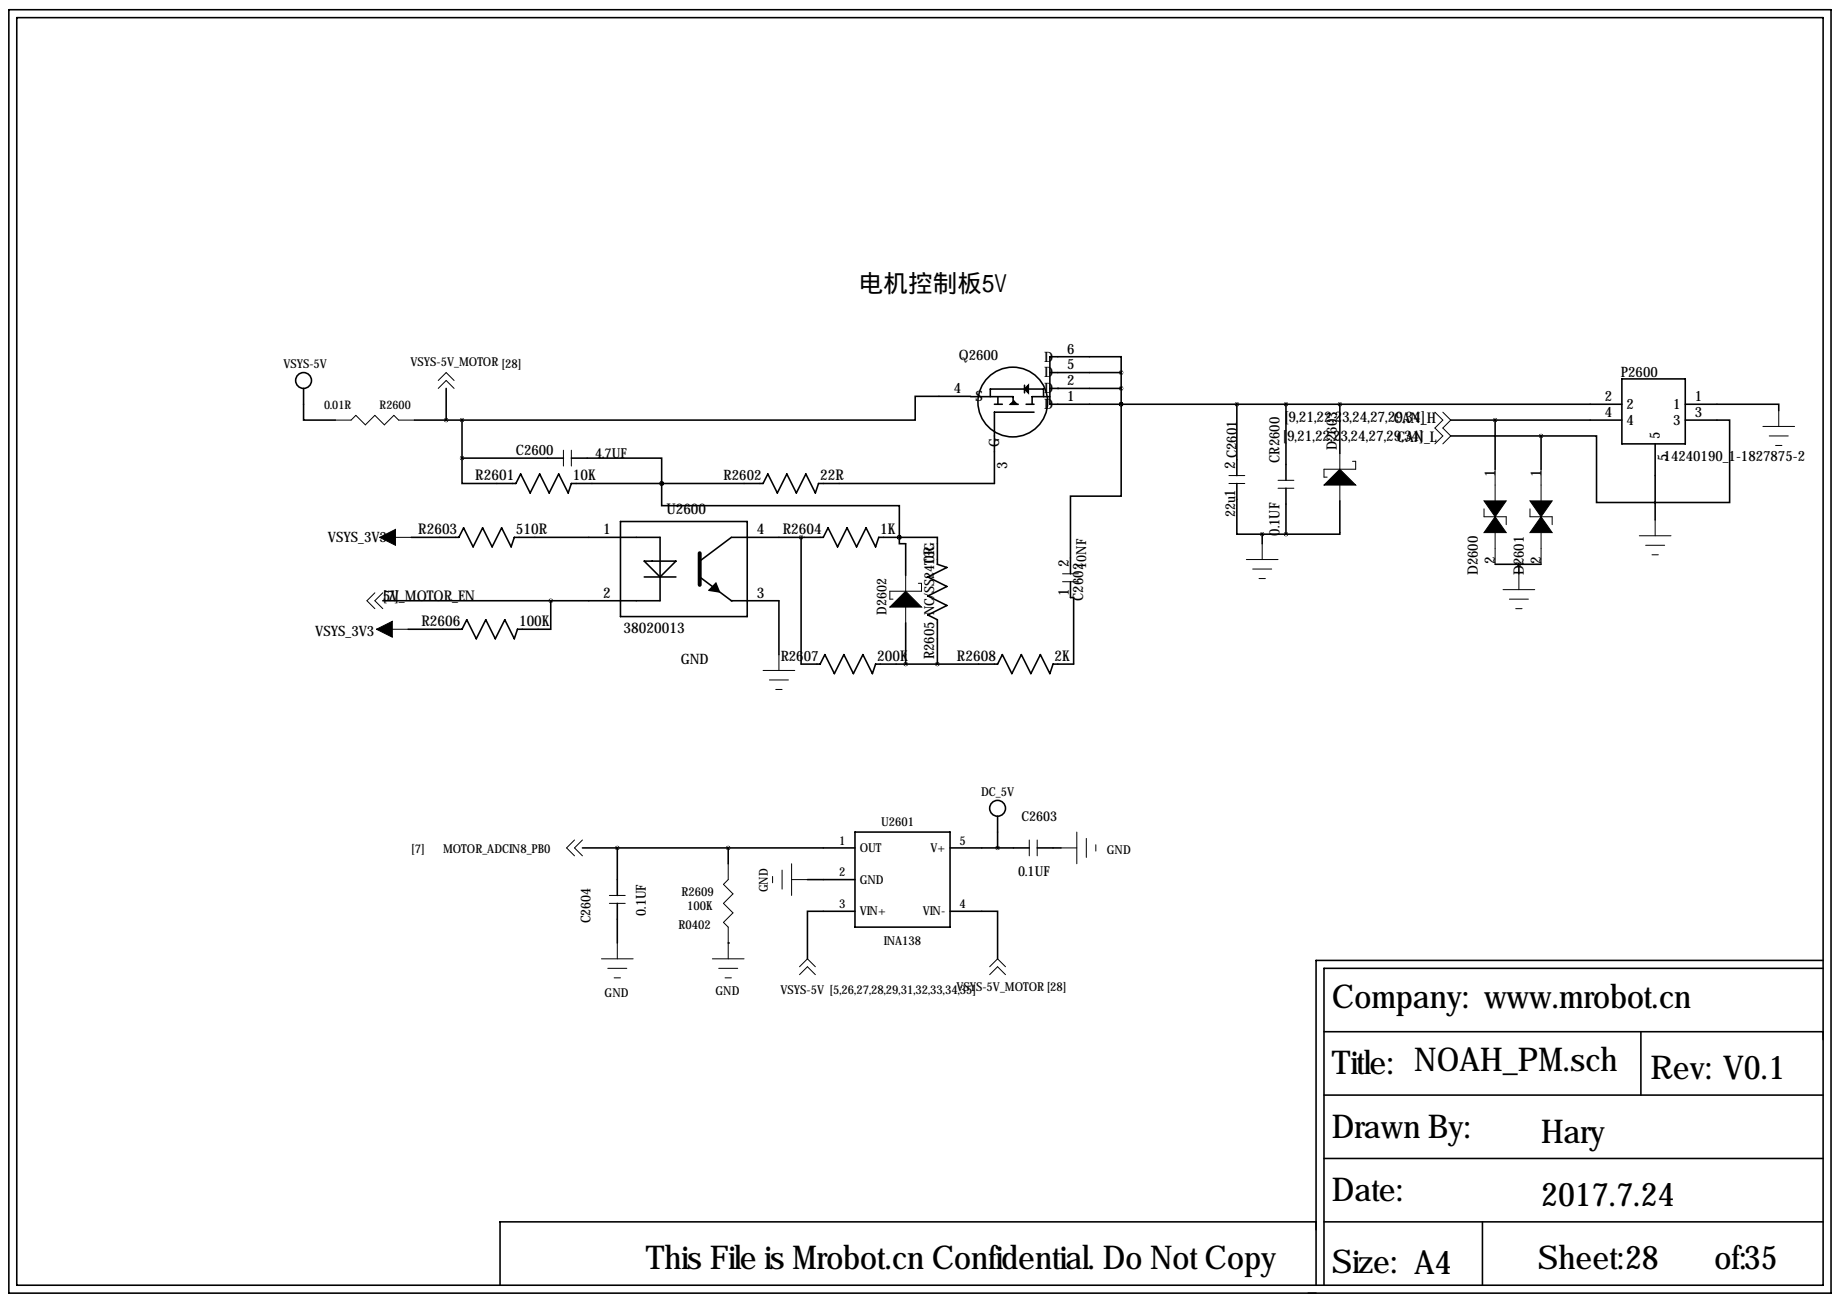
[picture p28: page 28]

Company: www.mrobot.cn

## 传感器板 5V

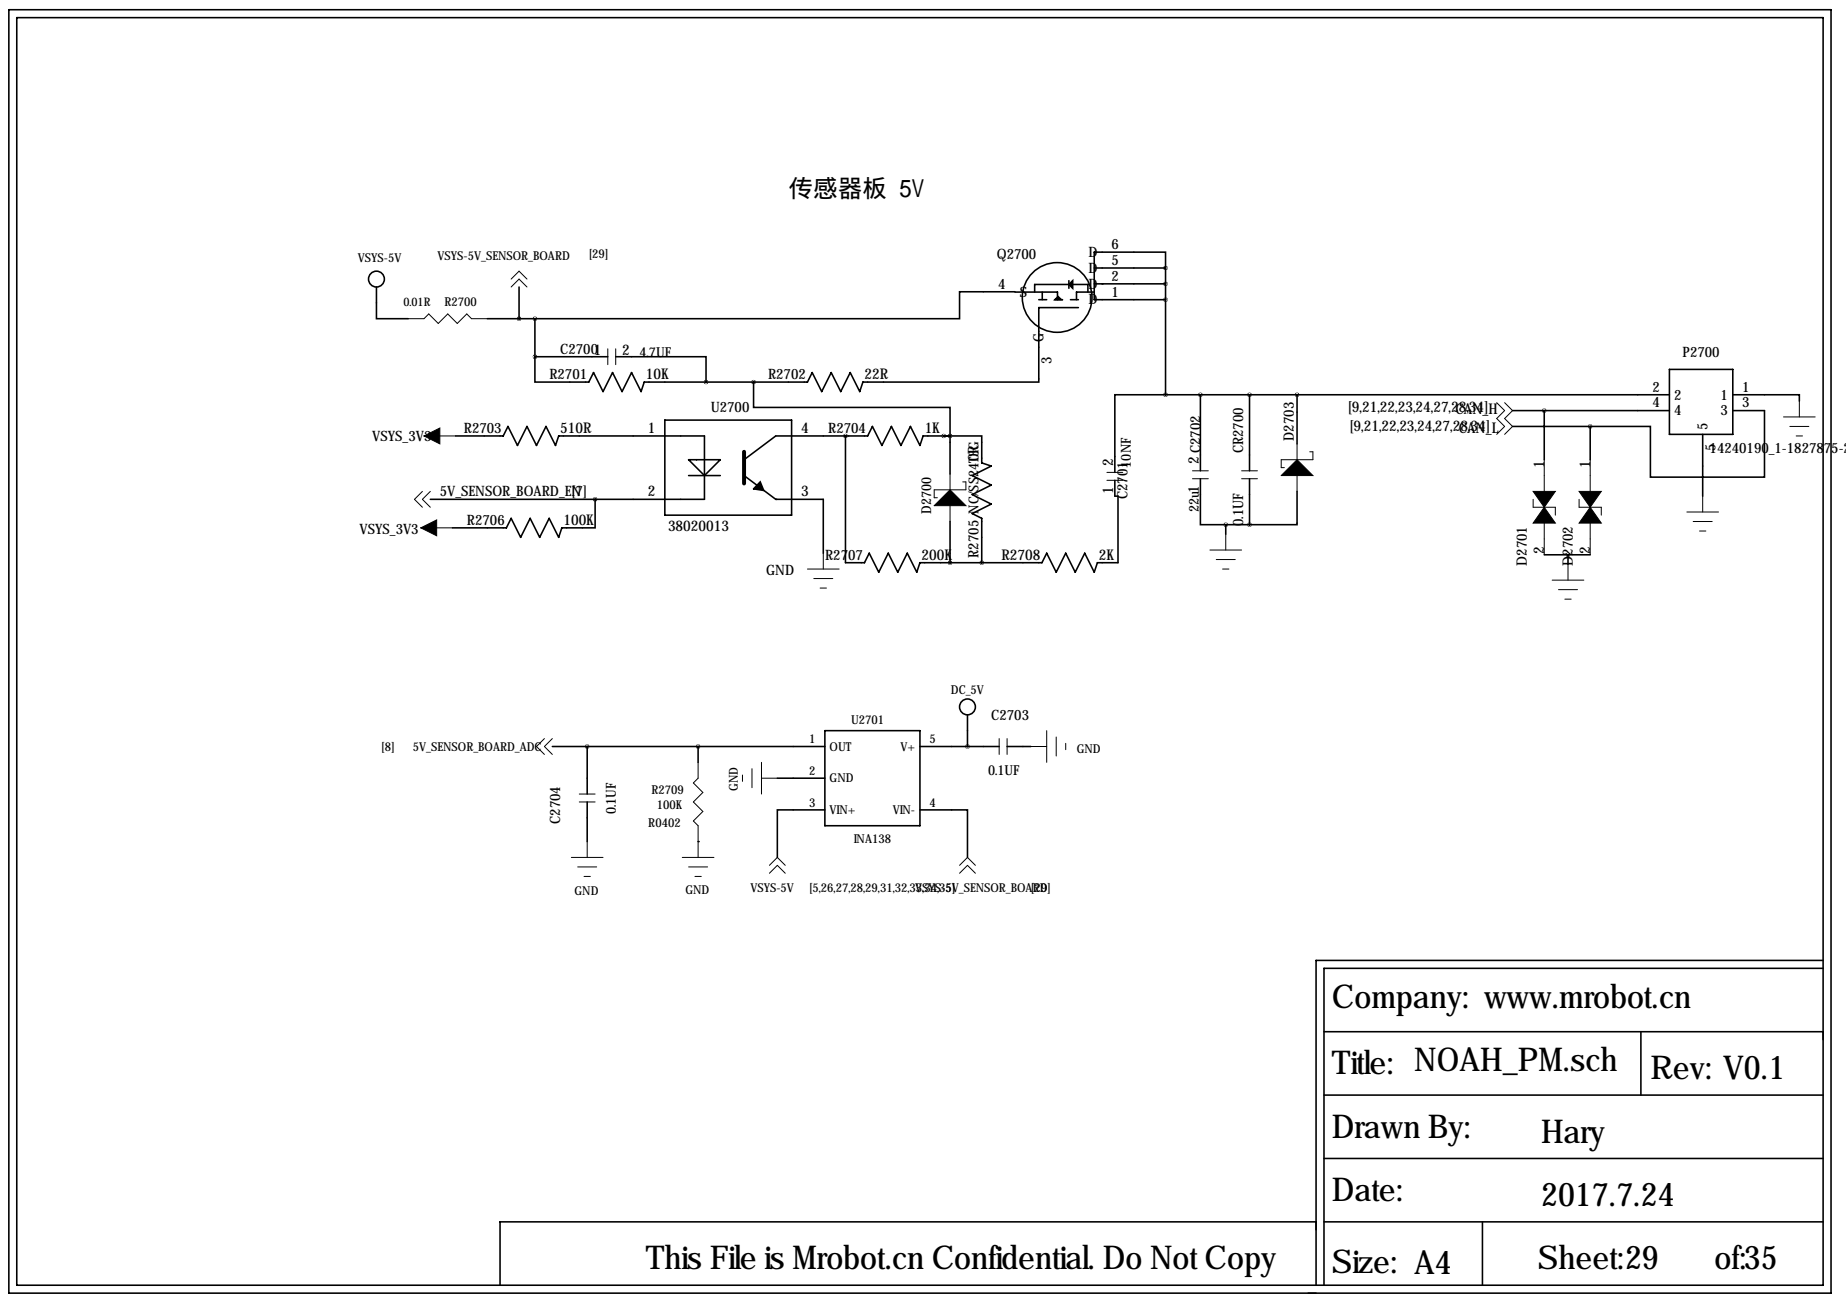
[picture p29: page 29]

Company: www.mrobot.cn

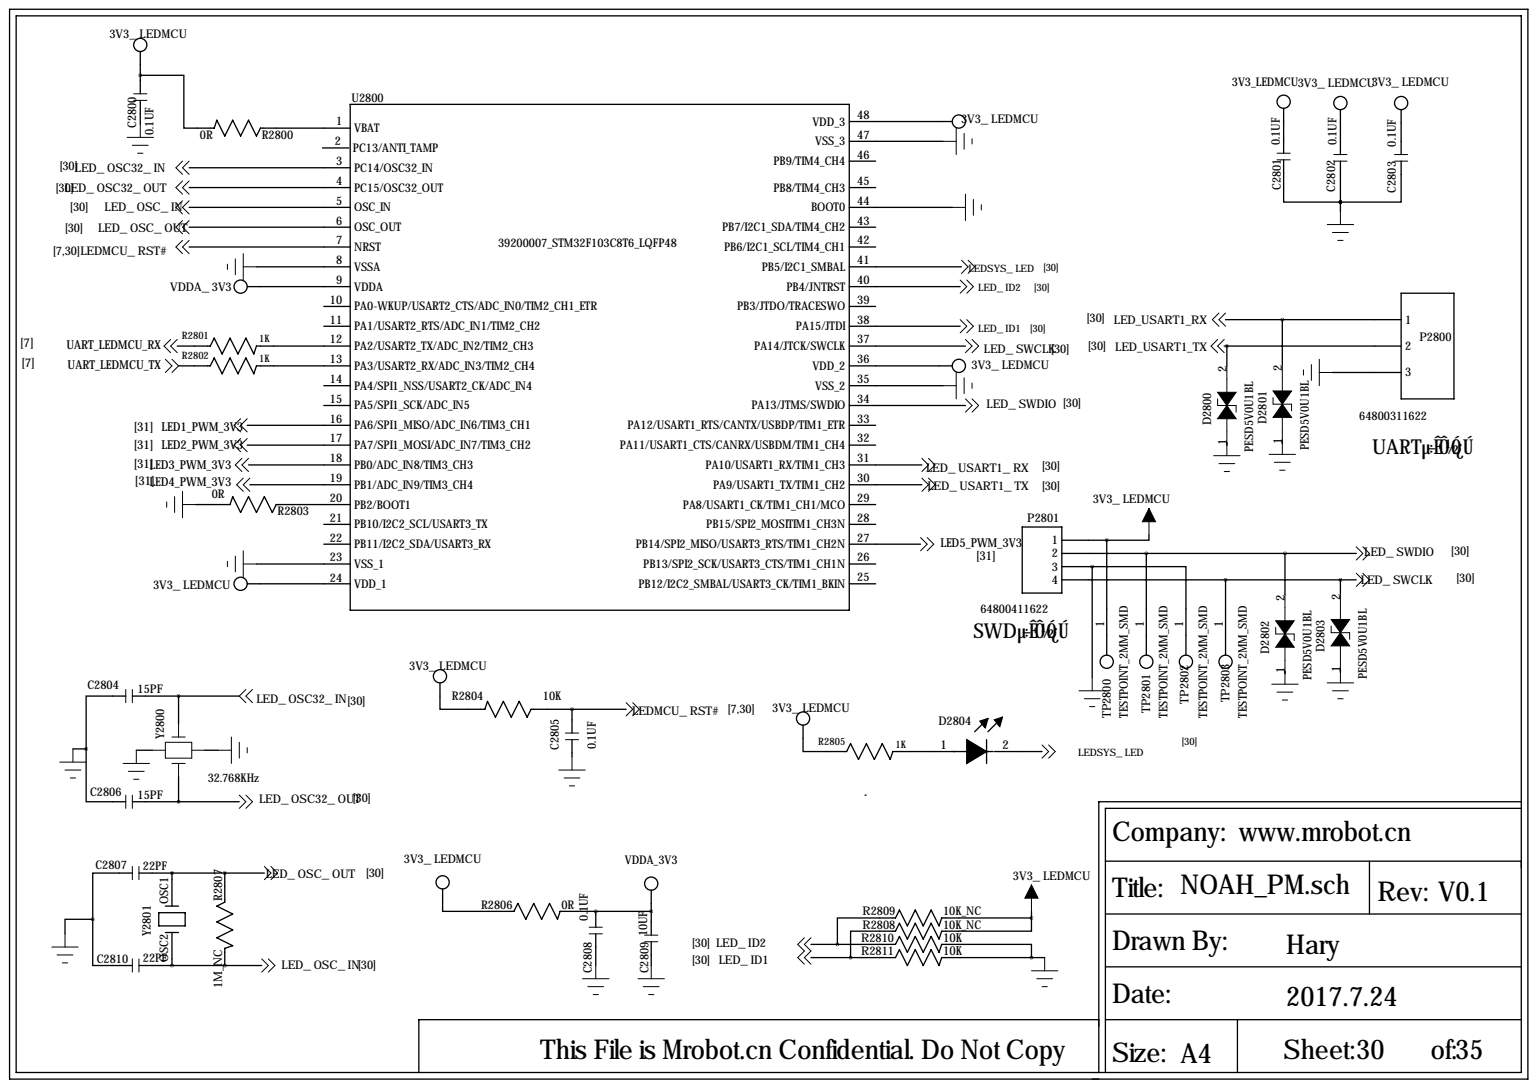
[picture p30: page 30]

Company: www.mrobot.cn

## 灯带 5V

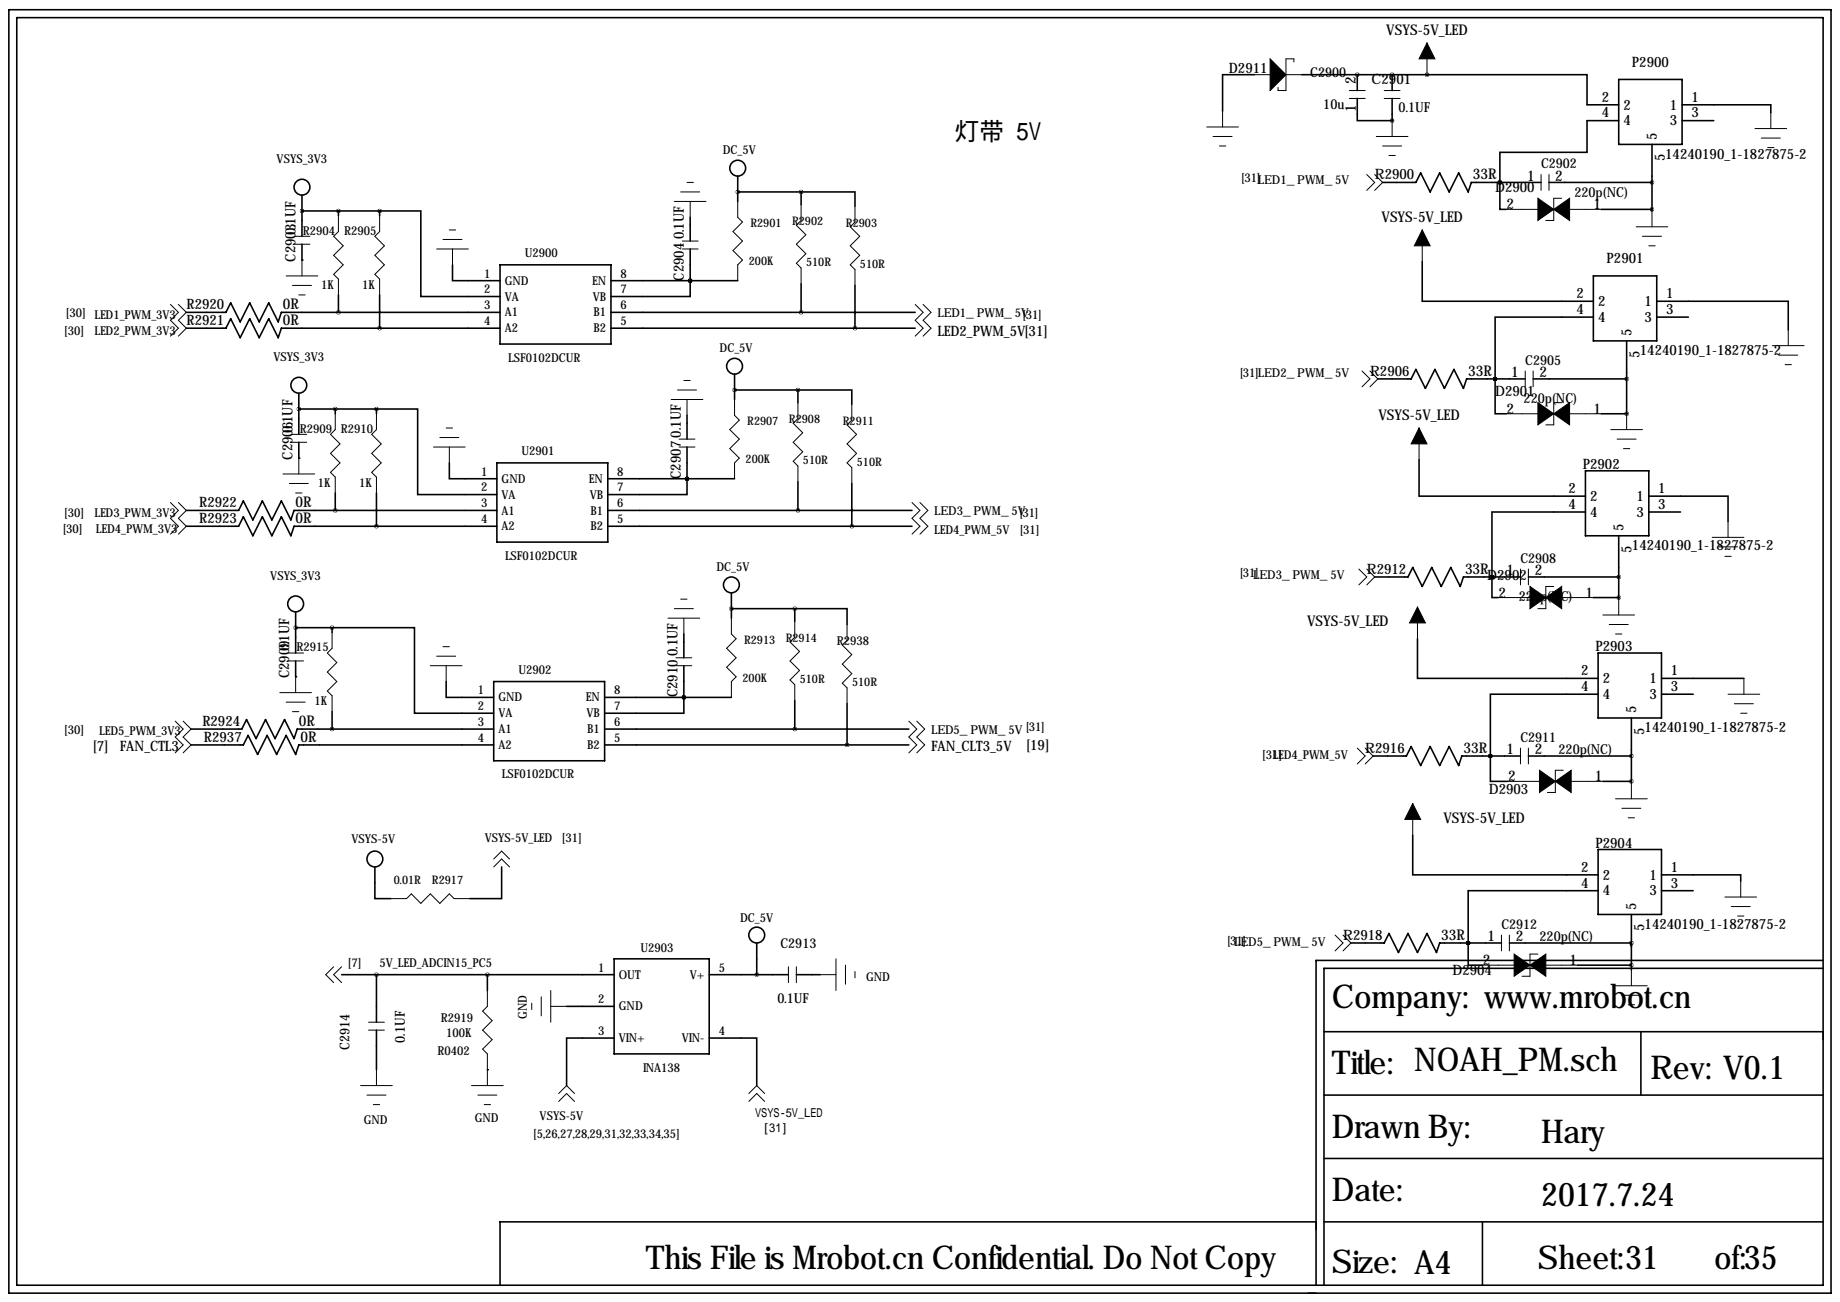
[picture p31: page 31]

Company: www.mrobot.cn

## 密码键盘 5V

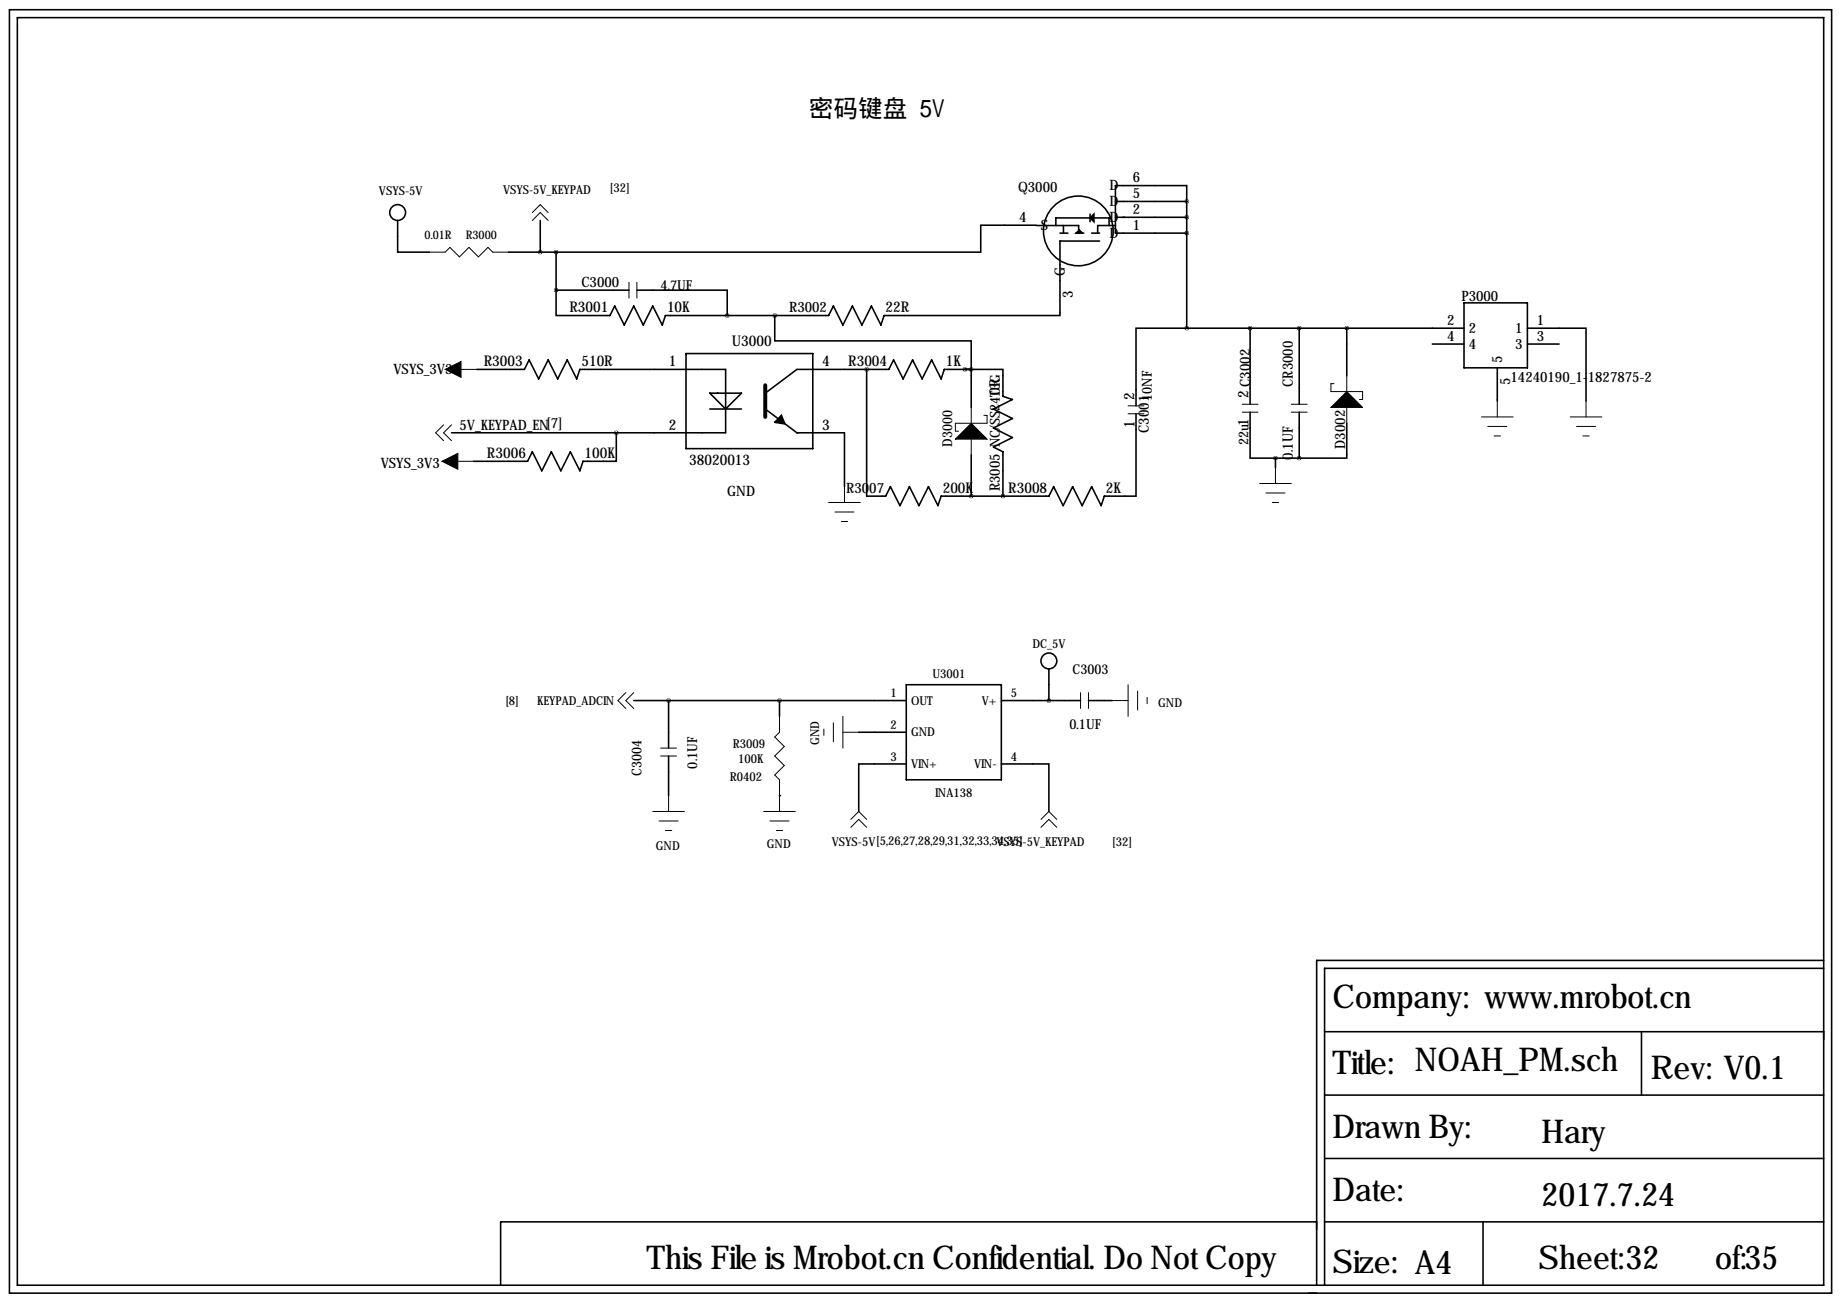
[picture p32: page 32]

Company: www.mrobot.cn

## 滑竿电机 5V

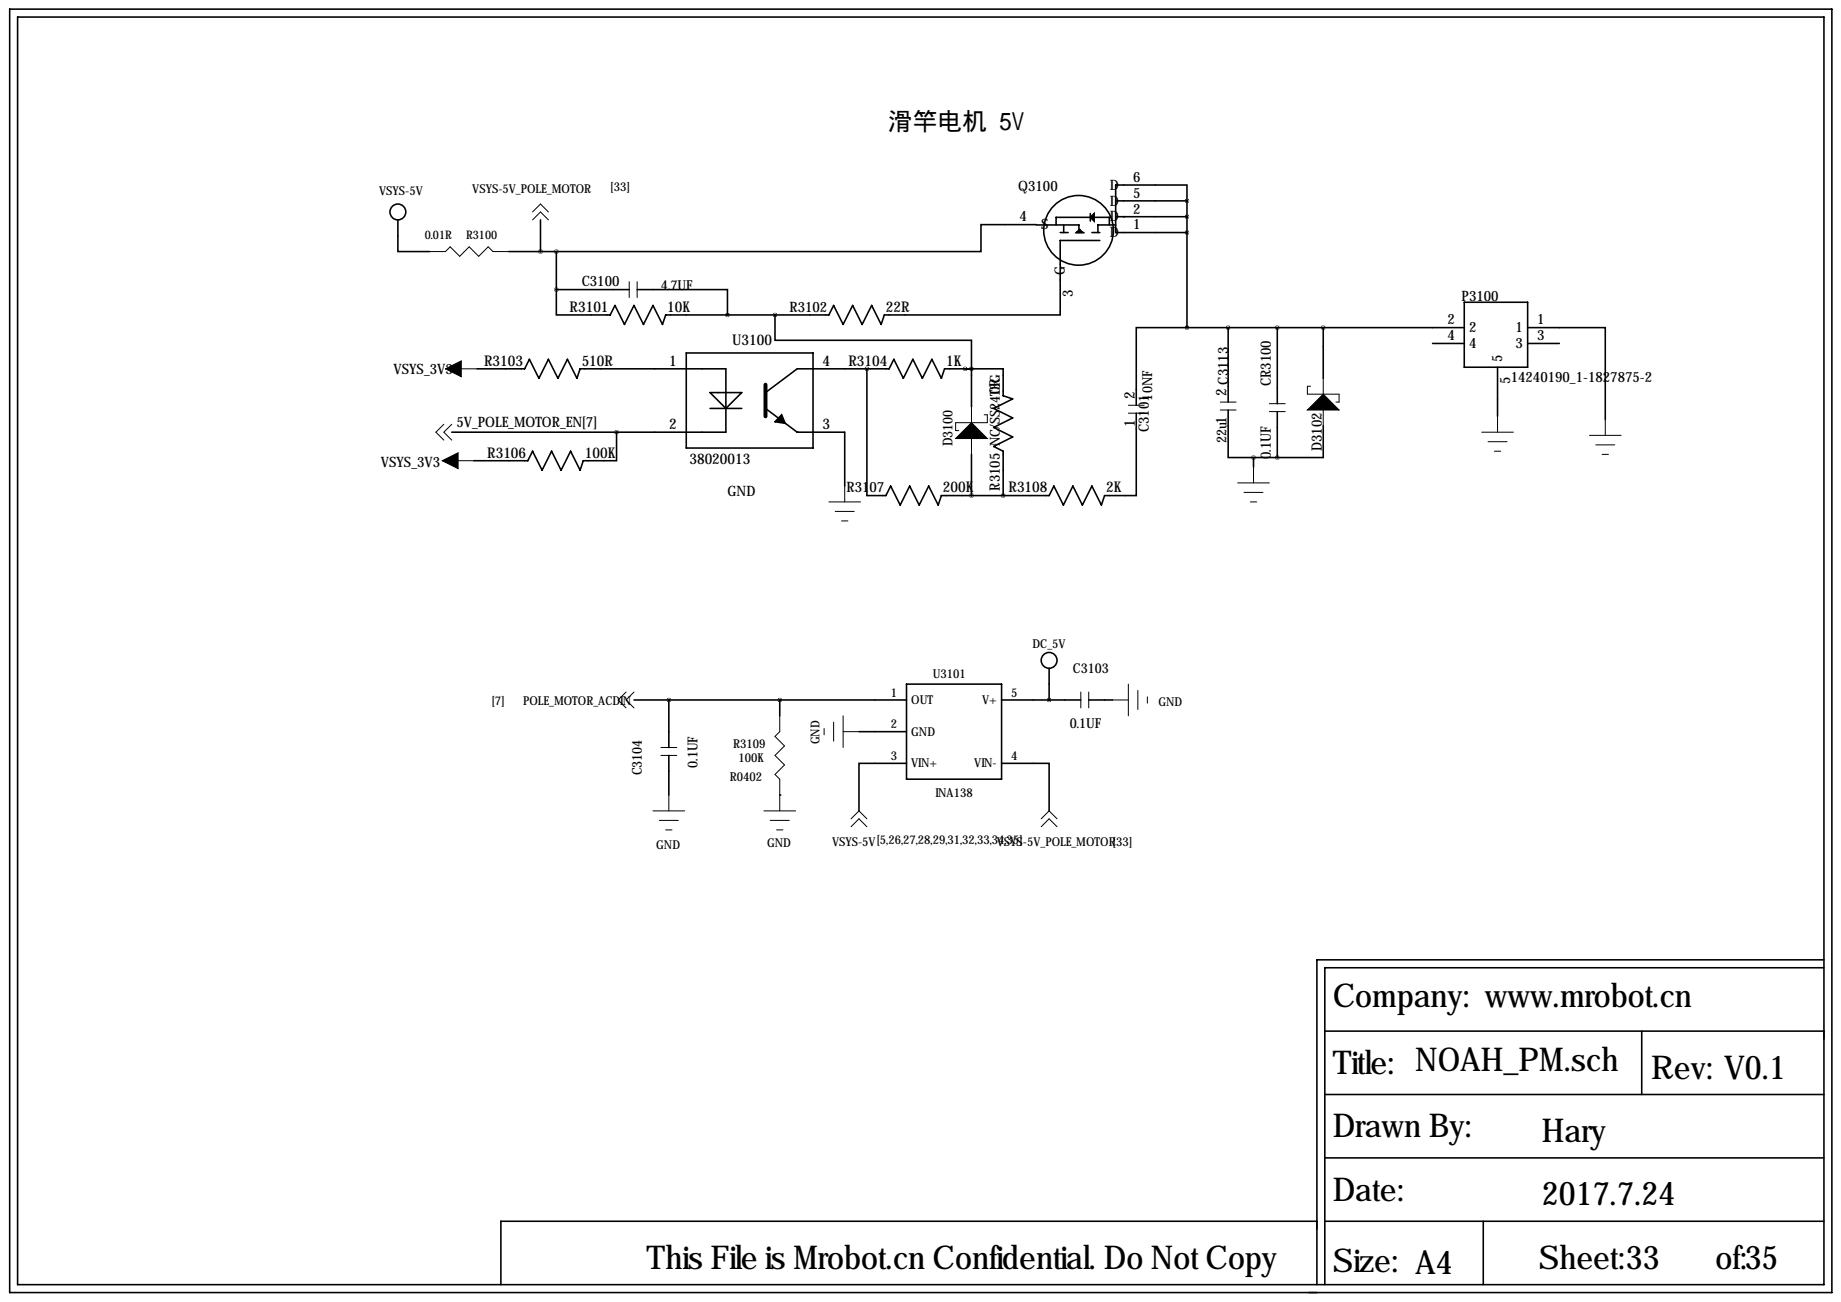
[picture p33: page 33]

Company: www.mrobot.cn

## 外部扩展 5V

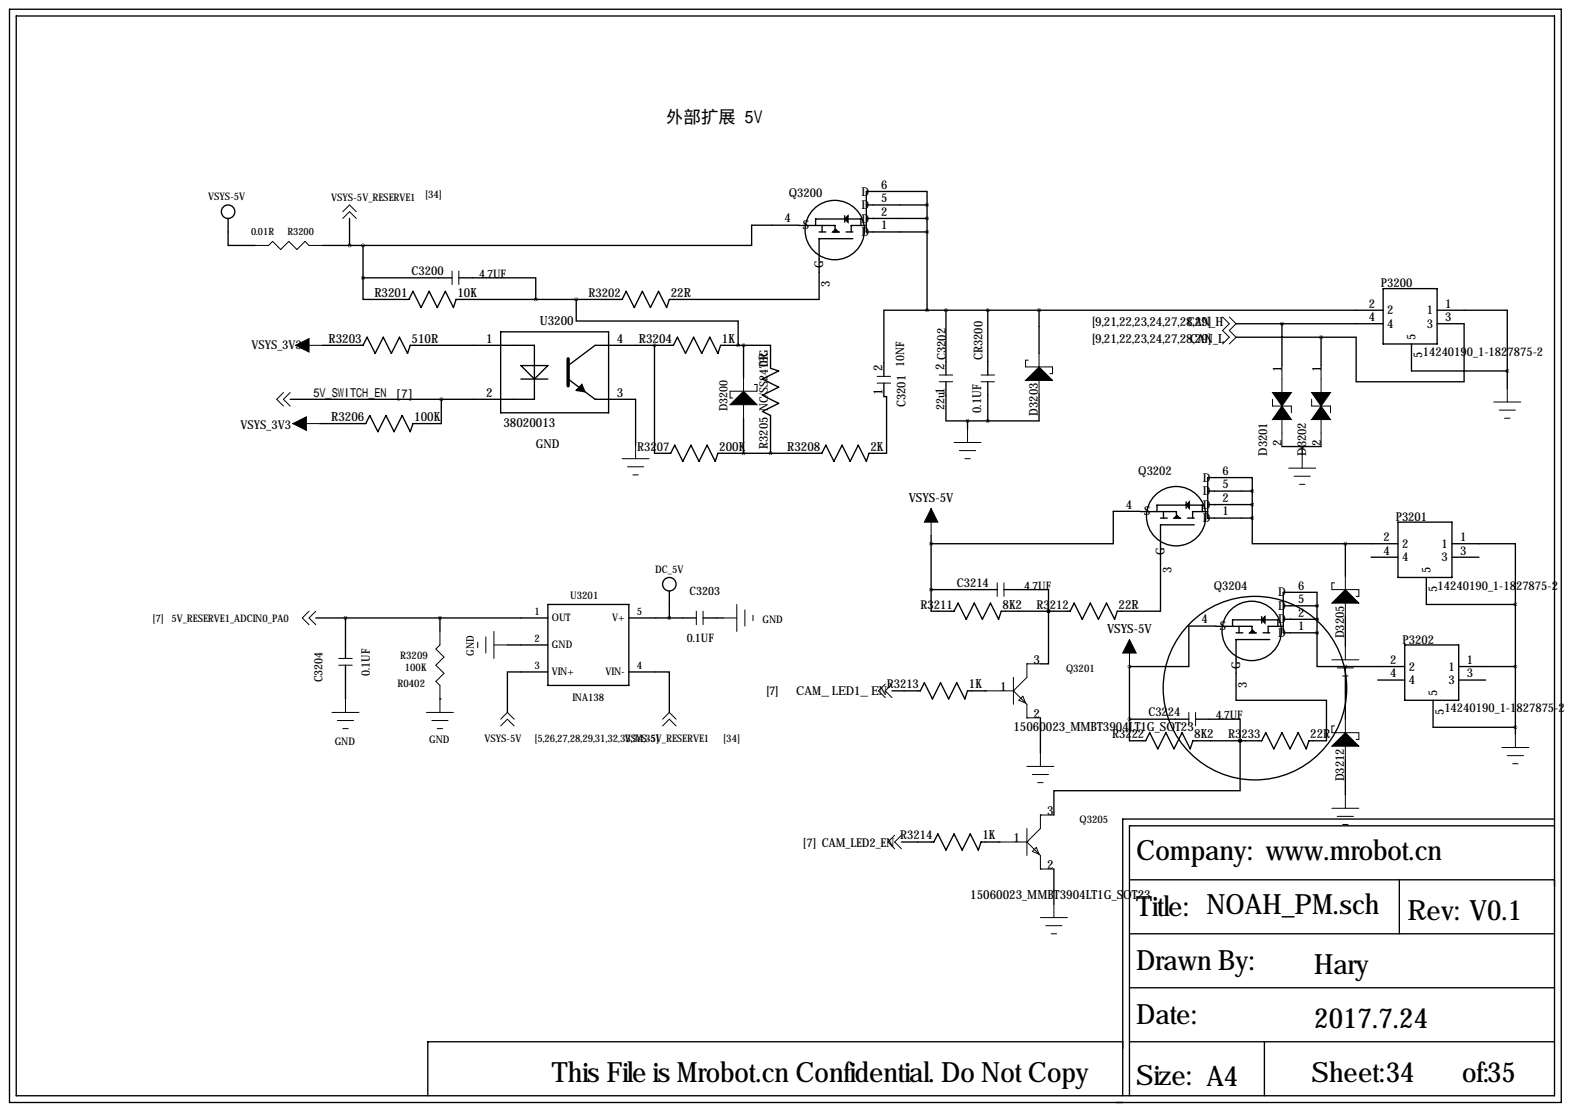
[picture p34: page 34]

Company: www.mrobot.cn

3.3V

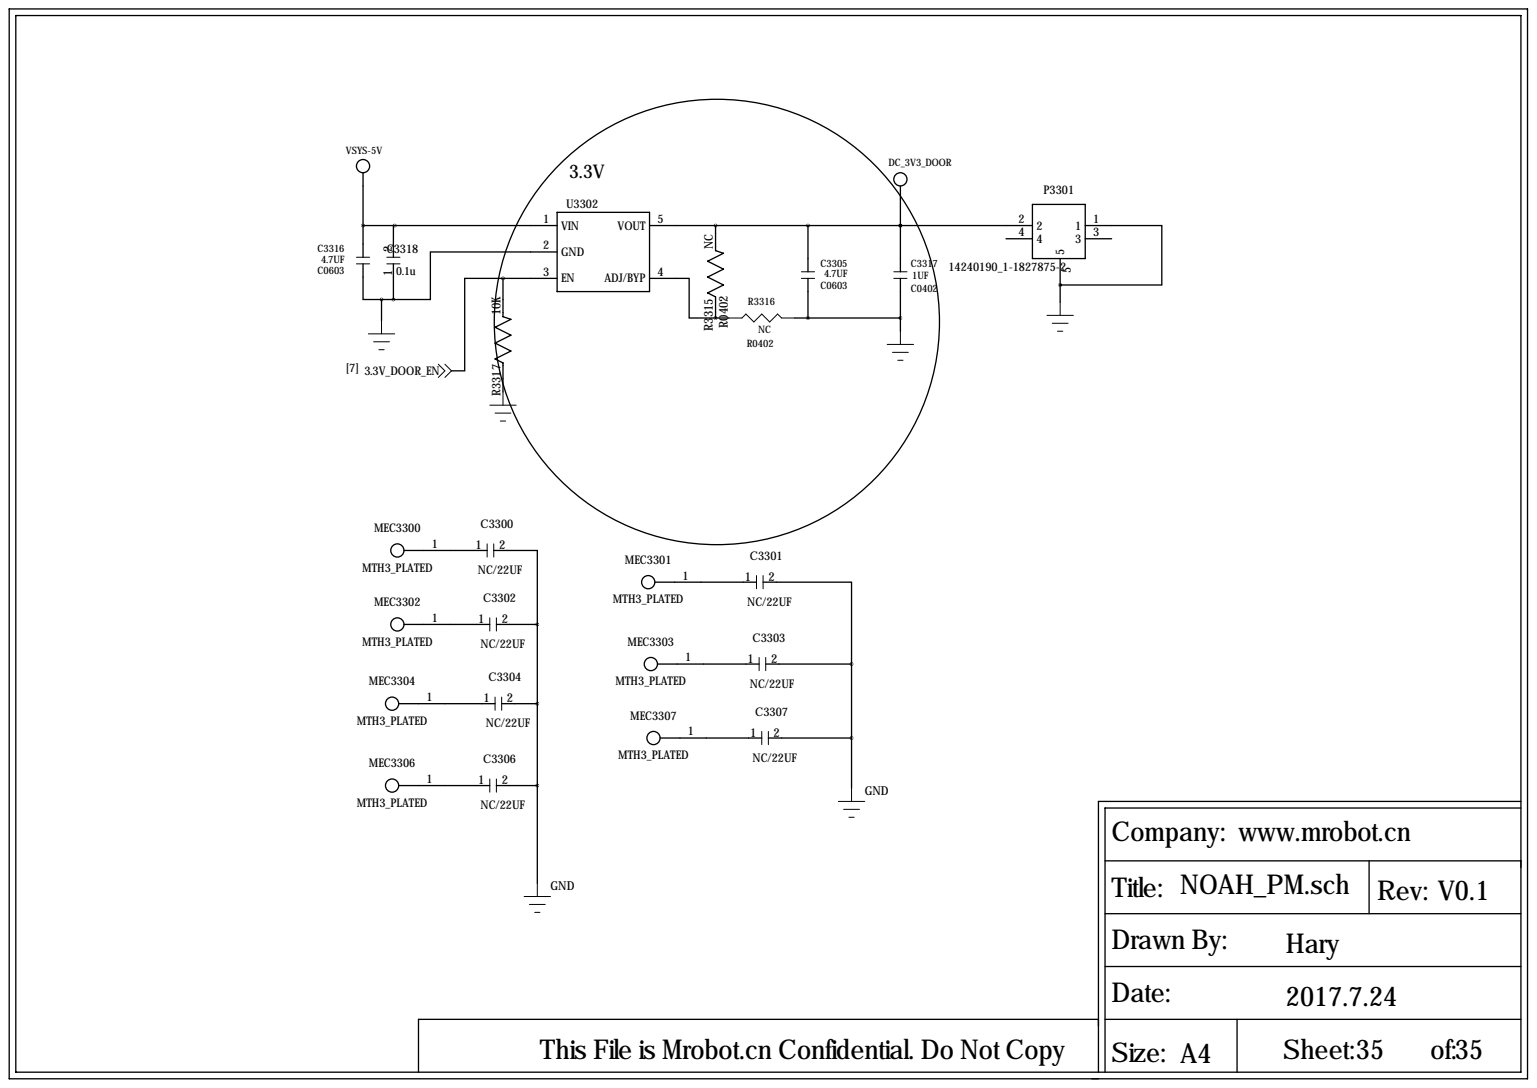
[picture p35: page 35]

Company: www.mrobot.cn
