SiChiTong/AGV_PowerBoard/include/MiCODrivers/MiCODriverPwm.h

/**
 ******************************************************************************
 * @file    MicoDriverPwm.h
 * @author  William Xu
 * @version V1.0.0
 * @date    16-Sep-2014
 * @brief   This file provides all the headers of PWM operation functions.
 ******************************************************************************
 *
 *  The MIT License
 *  Copyright (c) 2014 MXCHIP Inc.
 *
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
 *  THE SOFTWARE IS PROVIDED "AS IS", WITHOUT WARRANTY OF ANY KIND, EXPRESS OR
 *  IMPLIED, INCLUDING BUT NOT LIMITED TO THE WARRANTIES OF MERCHANTABILITY,
 *  FITNESS FOR A PARTICULAR PURPOSE AND NONINFRINGEMENT. IN NO EVENT SHALL THE
 *  AUTHORS OR COPYRIGHT HOLDERS BE LIABLE FOR ANY CLAIM, DAMAGES OR OTHER LIABILITY,
 *  WHETHER IN AN ACTION OF CONTRACT, TORT OR OTHERWISE, ARISING FROM, OUT OF OR
 *  IN CONNECTION WITH THE SOFTWARE OR THE USE OR OTHER DEALINGS IN THE SOFTWARE.
 ******************************************************************************
 */

#ifndef __MICODRIVERPWM_H__
#define __MICODRIVERPWM_H__

#pragma once
#include "common.h"
#include "platform.h"

/** @addtogroup MICO_PLATFORM
  * @{
  */

/** @defgroup MICO_PWM MICO PWM Driver
  * @brief  Pulse-Width Modulation (PWM) Functions
  * @{
  */

/******************************************************
 *                   Enumerations
 ******************************************************/

/******************************************************
 *                 Type Definitions
 ******************************************************/

 /******************************************************
 *                 Function Declarations
 ******************************************************/



/**@brief Initialises a PWM pin
 *
 * @note  Prepares a Pulse-Width Modulation pin for use.
 * Does not start the PWM output (use @ref MicoPwmStart).
 *
 * @param pwm        : the PWM interface which should be initialised
 * @param frequency  : Output signal frequency in Hertz
 * @param duty_cycle : Duty cycle of signal as a floating-point percentage (0.0 to 100.0)
 *
 * @return    kNoErr        : on success.
 * @return    kGeneralErr   : if an error occurred with any step
 */
OSStatus MicoPwmInitialize(mico_pwm_t pwm, uint32_t frequency, float duty_cycle);


/**@brief Starts PWM output on a PWM interface
 *
 * @note  Starts Pulse-Width Modulation signal output on a PWM pin
 *
 * @param pwm        : the PWM interface which should be started
 *
 * @return    kNoErr        : on success.
 * @return    kGeneralErr   : if an error occurred with any step
 */
OSStatus MicoPwmStart(mico_pwm_t pwm);
OSStatus MicoPwmStartEx(mico_pwm_t pwm);

OSStatus MicoPwmSetDuty( mico_pwm_t pwm, float duty_cycle );
/**@brief Stops output on a PWM pin
 *
 * @note  Stops Pulse-Width Modulation signal output on a PWM pin
 *
 * @param pwm        : the PWM interface which should be stopped
 *
 * @return    kNoErr        : on success.
 * @return    kGeneralErr   : if an error occurred with any step
 */
OSStatus MicoPwmStop(mico_pwm_t pwm);

/** @} */
/** @} */

#endif
