SiChiTong/AGV_PowerBoard/application/platform/voltage_detect.h

/*
 *  Author: Adam Huang
 *  Date:2016/6/8
 */
#ifndef __VOLTAGE_DETECT_H
#define __VOLTAGE_DETECT_H

#include <stdint.h>
#include "Common.h"
#include "Debug.h"
#include "Mico.h"
#define  VOLTAGE_DEBUG

#define VBAT_POWER_ON_LEVEL                 4500//x10mV
#define VBAT_LOW_POWER_LEVEL                4600//x10mV
#define VBAT_POWER_OFF_LEVEL                4450//x10mV
#define VBAT_FULL_POWER_LEVEL               5800//x10mV

#define VBAT_POWER_OFF_PERCENTAGE           10  // %
#define VBAT_POWER_LOW_WARNING_PERCENTAGE   20  // %

#define VBAT_POWER_CHARGING_LOW             20
#define VBAT_POWER_CHARGING_MEDIUM          30
#define VBAT_POWER_CHARGING_FULL            100

#define   CURRENT_THRESHOLD_H_PRINTER_MA          2500
#define   CURRENT_THRESHOLD_L_PRINTER_MA          0
#define   CURRENT_THRESHOLD_H_DLP_MA              2500
#define   CURRENT_THRESHOLD_L_DLP_MA              0
#define   CURRENT_THRESHOLD_H_2_1_PA_MA           3000
#define   CURRENT_THRESHOLD_L_2_1_PA_MA           0
#define   CURRENT_THRESHOLD_H_PAD_MA              2500
#define   CURRENT_THRESHOLD_L_PAD_MA              0
#define   CURRENT_THRESHOLD_H_5V_RESERVE1_MA      1500
#define   CURRENT_THRESHOLD_L_5V_RESERVE1_MA      0
#define   CURRENT_THRESHOLD_H_X86_MA              3000
#define   CURRENT_THRESHOLD_L_X86_MA              0
#define   CURRENT_THRESHOLD_H_DH_5V_MA            200
#define   CURRENT_THRESHOLD_L_DH_5V_MA            0
#define   CURRENT_THRESHOLD_H_SENSOR_MA           200
#define   CURRENT_THRESHOLD_L_SENSOR_MA           0
#define   CURRENT_THRESHOLD_H_5V_LED_MA           3500
#define   CURRENT_THRESHOLD_L_5V_LED_MA           0
#define   CURRENT_THRESHOLD_H_MOTOR_5V_MA         100
#define   CURRENT_THRESHOLD_L_MOTOR_5V_MA         0
#define   CURRENT_THRESHOLD_H_MOTOR_MA            2000
#define   CURRENT_THRESHOLD_L_MOTOR_MA            0
#define   CURRENT_THRESHOLD_H_DH_12V_MA           2500
#define   CURRENT_THRESHOLD_L_DH_12V_MA           0
#define   CURRENT_THRESHOLD_H_VBAT_MA             30000
#define   CURRENT_THRESHOLD_L_VBAT_MA             0
#define   CURRENT_THRESHOLD_H_12V_RESEVE2_MA      10000
#define   CURRENT_THRESHOLD_L_12V_RESEVE2_MA      0
#define   CURRENT_THRESHOLD_H_24V_RESEVE_MA       10000
#define   CURRENT_THRESHOLD_L_24V_RESEVE_MA       0


struct convert_adc_data {
    const mico_adc_t      adc_type;
    const uint8_t         convert_type;
#define                         CONVERT_TYPE_VOLTAGE            0x01
#define                         CONVERT_TYPE_CURRENTS           0x02
#define                         CONVERT_TYPE_TEMP               0x03
    const uint8_t         isNeedDelay;
    const float           convert_factor;
    const uint16_t        threshold_low;
    const uint16_t        threshold_high;
    uint16_t              err_start_time;
    const uint16_t        err_duration_time;
    uint16_t              err_value;
    const uint8_t         err_channel;
    const uint8_t         fault_bit_mask_num;
};



#pragma pack(1)
typedef struct _VoltageData_t {
    uint16_t              _5V_reserve1_currents;
    //uint16_t              _24V_nv_currents;
    //uint16_t              _12V_nv_currents;
    uint16_t              _48V_extend_currents;

    uint16_t              _12V_extend_currents;
    uint16_t              motor_currents;
    uint16_t              slam_currents;
    uint16_t              _2_1_pa_currents;

    uint16_t              pad_currents;
    uint16_t              printer_currents;
    uint16_t              x86_currents;
    uint16_t              ir_led_currents;

    uint16_t              _5V_leds_currents;

    uint16_t              recharge_currents;
    uint16_t              _24V_extend_currents;
    uint16_t              charge_currents;
    uint16_t              batin_currents;

    uint16_t              vbus_currents;
    uint16_t              bat_motor_currents;
    //  uint16_t              multi_channel_adc;

    uint16_t              _24V_temp;
    uint16_t              _12V_temp;
    uint16_t              _5V_temp;
    uint16_t              air_temp;

    uint16_t              _24V_all_currents;
    uint16_t              _12V_all_currents;
    uint16_t              _5V_all_currents;
    uint16_t              _24V_voltage;

    uint16_t              _12V_voltage;
    uint16_t               _5V_voltage;
    uint16_t               bat_voltage;
    uint16_t               sensor_board_currents;

    int16_t               _12V_router_currents;

    uint16_t              _24V_nv_currents;
    uint16_t              _12V_nv_currents;
    uint16_t              keypad_currents;

} voltage_data_t;
#pragma pack()


typedef struct _voltageConvert_t {
#if 0
    uint8_t              bat_voltage;
    uint8_t              _5V_reserve1;
    uint8_t              _12V_reserve2;
    uint8_t              _24V_all;
    uint8_t              dh_12V;
    uint8_t              dh_5V;
    uint8_t              sensor;
    uint8_t              dlp;
    uint8_t              motor_5v;
    uint8_t              _24V_reserve1;
    uint8_t              _2_1_pa;
    uint8_t              pad;
    uint8_t              printer;
    uint8_t              x86;
    uint8_t              motor;
    uint8_t              _5V_led;
#endif
    uint8_t                faultBitTemp[4];
#define         AMBIENT_TEMP_FAULT_BIT_BIT_MASK_NUM     (0)
#define         AMBIENT_TEMP_FAULT_BIT                  ((uint32_t)0x00000001)
#define         SYS_CURRENTS_FAULT_BIT_MASK_NUM         (1)
#define         SYS_CURRENTS_FAULT_BIT                  ((uint32_t)0x00000002)
#define         BAT_MOTOR_CURRENTS_FAULT_BIT_MASK_NUM   (2)
#define         BAT_MOTOR_CURRENTS_FAULT_BIT            ((uint32_t)0x00000004)
#define         MOTOR_CURRENTS_FAULT_BIT_MASK_NUM       (3)
#define         MOTOR_CURRENTS_FAULT_BIT                ((uint32_t)0x00000008)
#define         DH_5V_CURRENTS_FAULT_BIT_MASK_NUM       (4)
#define         DH_5V_CURRENTS_FAULT_BIT                ((uint32_t)0x00000010)
#define         SENSOR_CURRENTS_FAULT_BIT_MASK_NUM      (5)
#define         SENSOR_CURRENTS_FAULT_BIT               ((uint32_t)0x00000020)
#define         DLP_CURRENTS_FAULT_BIT_MASK_NUM         (6)
#define         DLP_CURRENTS_FAULT_BIT                  ((uint32_t)0x00000040)
#define         LEDS_CURRENTS_FAULT_BIT_MASK_NUM        (7)
#define         LEDS_CURRENTS_FAULT_BIT                 ((uint32_t)0x00000080)
#define         PAD_CURRENTS_FAULT_BIT_MASK_NUM         (8)
#define         PAD_CURRENTS_FAULT_BIT                  ((uint32_t)0x00000100)
#define         X86_CURRENTS_FAULT_BIT_MASK_NUM         (9)
#define         X86_CURRENTS_FAULT_BIT                  ((uint32_t)0x00000200)
#define         PA_2_1_CURRENTS_FAULT_BIT_MASK_NUM      (10)
#define         PA_2_1_CURRENTS_FAULT_BIT               ((uint32_t)0x00000400)
#define         DH_12V_CURRENTS_FAULT_BIT_MASK_NUM      (11)
#define         DH_12V_CURRENTS_FAULT_BIT               ((uint32_t)0x00000800)
#define         PRINTER_CURRENTS_FAULT_BIT_MASK_NUM     (12)
#define         PRINTER_CURRENTS_FAULT_BIT              ((uint32_t)0x00001000)
#define         RES_5V_CURRENTS_FAULT_BIT_MASK_NUM      (13)
#define         RES_5V_CURRENTS_FAULT_BIT               ((uint32_t)0x00002000)
#define         RES_12V_CURRENTS_FAULT_BIT_MASK_NUM     (14)
#define         RES_12V_CURRENTS_FAULT_BIT              ((uint32_t)0x00004000)
#define         RES_24V_CURRENTS_FAULT_BIT_MASK_NUM     (15)
#define         RES_24V_CURRENTS_FAULT_BIT              ((uint32_t)0x00008000)
#define         BAT_NV_CURRENTS_FAULT_BIT_MASK_NUM      (16)
#define         BAT_NV_CURRENTS_FAULT_BIT               ((uint32_t)0x00010000)
#define         _12V_NV_CURRENTS_FAULT_BIT_MASK_NUM     (17)
#define         _12V_NV_CURRENTS_FAULT_BIT              ((uint32_t)0x00020000)
#define         ROUTER_CURRENTS_FAULT_BIT_MASK_NUM      (18)
#define         ROUTER_CURRENTS_FAULT_BIT               ((uint32_t)0x00040000)
#define         DYP_CURRENTS_FAULT_BIT_MASK_NUM         (19)
#define         DYP_CURRENTS_FAULT_BIT                  ((uint32_t)0x00080000)
#define         IRLED_CURRENTS_FAULT_BIT_MASK_NUM       (20)
#define         IRLED_CURRENTS_FAULT_BIT                ((uint32_t)0x00100000)
#define         CHARGE_CURRENTS_FAULT_BIT_MASK_NUM      (21)
#define         CHARGE_CURRENTS_FAULT_BIT               ((uint32_t)0x00200000)
#define         BATIN_CURRENTS_FAULT_BIT_MASK_NUM       (22)
#define         BATIN_CURRENTS_FAULT_BIT                ((uint32_t)0x00400000)
#define         _24V_VOLTAGE_FAULT_BIT_MASK_NUM         (23)
#define         _24V_VOLTAGE_FAULT_BIT                  ((uint32_t)0x00800000)
#define         _12V_VOLTAGE_FAULT_BIT_MASK_NUM         (24)
#define         _12V_VOLTAGE_FAULT_BIT                  ((uint32_t)0x01000000)
#define         _5V_VOLTAGE_FAULT_BIT_MASK_NUM          (25)
#define         _5V_VOLTAGE_FAULT_BIT                   ((uint32_t)0x02000000)
#define         _5V_CURRENTS_FAULT_BIT_MASK_NUM         (26)
#define         _5V_CURRENTS_FAULT_BIT                  ((uint32_t)0x04000000)
#define         _12V_CURRENTS_FAULT_BIT_MASK_NUM        (27)
#define         _12V_CURRENTS_FAULT_BIT                 ((uint32_t)0x08000000)
#define         _24V_CURRENTS_FAULT_BIT_MASK_NUM        (28)
#define         _24V_CURRENTS_FAULT_BIT                 ((uint32_t)0x10000000)
#define         _5V_REGULATOR_TEMP_FAULT_BIT_MASK_NUM   (29)
#define         _5V_REGULATOR_TEMP_FAULT_BIT            ((uint32_t)0x20000000)
#define         _12V_REGULATOR_TEMP_FAULT_BIT_MASK_NUM  (30)
#define         _12V_REGULATOR_TEMP_FAULT_BIT           ((uint32_t)0x40000000)
#define         _24V_REGULATOR_TEMP_FAULT_BIT_MASK_NUM  (31)
#define         _24V_REGULATOR_TEMP_FAULT_BIT           ((uint32_t)0x80000000)
} voltage_convert_data_t;

typedef struct _voltageDebug_t {
    uint8_t               printType;
#define                         PRINT_NO        0x00
#define                         PRINT_ONCE      0x01
#define                         PRINT_PEROID    0x02
#ifdef  VOLTAGE_DEBUG
    uint8_t               printMaxType;
#define                         RESET_MAX_BUF   0x03
#endif
    uint16_t              peroid;
    uint32_t              startTime;
    uint8_t               uploadRate;
    uint8_t               isNeedUpload;
    uint32_t              uploadFlagTime;
} voltage_debug_t;

extern voltage_data_t *voltageConvert;
extern voltage_convert_data_t *voltageConvertData;
extern voltage_debug_t voltageDebug;

OSStatus detect_vol_init( void );
void detect_vol_tick( void );
void battery_percentage_1s_period( void );

#endif
