SiChiTong/AGV_PowerBoard/board/Noah_Powerboard/multi_channel_detection.c

/**
 ******************************************************************************
 * @file    multi_channel_detection.c
 * @author  Adam Huang
 * @version V1.0.0
 * @date    29-Nov-2016
 * @brief
 ******************************************************************************
 */

#include "multi_channel_detection.h"

#define   ADC1_DMA_CHANNELS_NUM  (14)
#define   FILTER_TIMES          (5)
#define   ADC1_DMA_BURRER_SIZE   (ADC1_DMA_CHANNELS_NUM*FILTER_TIMES)

#define   ADC3_DMA_CHANNELS_NUM  (5)
#define   FILTER_TIMES          (5)
#define   ADC3_DMA_BURRER_SIZE   (ADC3_DMA_CHANNELS_NUM*FILTER_TIMES)

extern const platform_adc_t             platform_adc_peripherals[];
__IO uint16_t adc1_dma_buffer[ADC1_DMA_BURRER_SIZE];
__IO uint16_t adc3_dma_buffer[ADC3_DMA_BURRER_SIZE];

void analog_multiplexer_init(void)
{
    platform_pin_config_t pin_config;

    pin_config.gpio_speed = GPIO_SPEED_MEDIUM;
    pin_config.gpio_mode = GPIO_MODE_OUTPUT_PP;
    pin_config.gpio_pull = GPIO_PULLUP;

    MicoGpioInitialize((mico_gpio_t)MICO_GPIO_SWITCH_EN, &pin_config);
    MicoGpioInitialize((mico_gpio_t)MICO_GPIO_SWITCH_SEL0, &pin_config);
    MicoGpioInitialize((mico_gpio_t)MICO_GPIO_SWITCH_SEL1, &pin_config);
    MicoGpioInitialize((mico_gpio_t)MICO_GPIO_SWITCH_SEL2, &pin_config);
    MicoGpioInitialize((mico_gpio_t)MICO_GPIO_SWITCH_SEL3, &pin_config);

    MicoGpioOutputLow((mico_gpio_t)MICO_GPIO_SWITCH_EN);
    MicoGpioOutputLow((mico_gpio_t)MICO_GPIO_SWITCH_SEL0);
    MicoGpioOutputLow((mico_gpio_t)MICO_GPIO_SWITCH_SEL1);
    MicoGpioOutputLow((mico_gpio_t)MICO_GPIO_SWITCH_SEL2);
    MicoGpioOutputLow((mico_gpio_t)MICO_GPIO_SWITCH_SEL3);
}


OSStatus select_multi_channel(mico_adc_t adc)
{
    OSStatus err = kNoErr;
    if (adc >= MICO_ADC_MAX || adc <  MICO_ADC_24V_TS)
        return kUnsupportedErr;

    MicoGpioOutputLow((mico_gpio_t)MICO_GPIO_SWITCH_EN);
    switch(adc)
    {
        case MICO_ADC_24V_TS:
            MicoGpioOutputLow((mico_gpio_t)MICO_GPIO_SWITCH_SEL0);
            MicoGpioOutputLow((mico_gpio_t)MICO_GPIO_SWITCH_SEL1);
            MicoGpioOutputLow((mico_gpio_t)MICO_GPIO_SWITCH_SEL2);
            MicoGpioOutputLow((mico_gpio_t)MICO_GPIO_SWITCH_SEL3);
            break;
        case MICO_ADC_12V_TS:
            MicoGpioOutputHigh((mico_gpio_t)MICO_GPIO_SWITCH_SEL0);
            MicoGpioOutputLow((mico_gpio_t)MICO_GPIO_SWITCH_SEL1);
            MicoGpioOutputLow((mico_gpio_t)MICO_GPIO_SWITCH_SEL2);
            MicoGpioOutputLow((mico_gpio_t)MICO_GPIO_SWITCH_SEL3);
            break;
        case MICO_ADC_5V_TS:
            MicoGpioOutputLow((mico_gpio_t)MICO_GPIO_SWITCH_SEL0);
            MicoGpioOutputHigh((mico_gpio_t)MICO_GPIO_SWITCH_SEL1);
            MicoGpioOutputLow((mico_gpio_t)MICO_GPIO_SWITCH_SEL2);
            MicoGpioOutputLow((mico_gpio_t)MICO_GPIO_SWITCH_SEL3);
            break;
        case MICO_ADC_AIR_TS:
            MicoGpioOutputHigh((mico_gpio_t)MICO_GPIO_SWITCH_SEL0);
            MicoGpioOutputHigh((mico_gpio_t)MICO_GPIO_SWITCH_SEL1);
            MicoGpioOutputLow((mico_gpio_t)MICO_GPIO_SWITCH_SEL2);
            MicoGpioOutputLow((mico_gpio_t)MICO_GPIO_SWITCH_SEL3);
            break;
        case MICO_ADC_24V_ALL_C:
            MicoGpioOutputLow((mico_gpio_t)MICO_GPIO_SWITCH_SEL0);
            MicoGpioOutputLow((mico_gpio_t)MICO_GPIO_SWITCH_SEL1);
            MicoGpioOutputHigh((mico_gpio_t)MICO_GPIO_SWITCH_SEL2);
            MicoGpioOutputLow((mico_gpio_t)MICO_GPIO_SWITCH_SEL3);
            break;
        case MICO_ADC_12V_ALL_C:
            MicoGpioOutputHigh((mico_gpio_t)MICO_GPIO_SWITCH_SEL0);
            MicoGpioOutputLow((mico_gpio_t)MICO_GPIO_SWITCH_SEL1);
            MicoGpioOutputHigh((mico_gpio_t)MICO_GPIO_SWITCH_SEL2);
            MicoGpioOutputLow((mico_gpio_t)MICO_GPIO_SWITCH_SEL3);
            break;
        case MICO_ADC_5V_ALL_C:
            MicoGpioOutputLow((mico_gpio_t)MICO_GPIO_SWITCH_SEL0);
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
