SiChiTong/AGV_PowerBoard/(commit log)

2017-06-22 AGV powerboard compile OK
    [Carrier_PM_V0.0_20170607.sch]
2017-06-23 Device power on OK
2017-06-27 Module control OK, ADC read anolog data OK
2017-06-27 One Wire LED Driver OK
2017-06-27 fix One Wire LED bug
    [serial_leds.c]
2017-06-28 fix one_wire_led bugs and every one_wire_led add color buffer
    [serial_leds.c, serial_leds.h]
2017-06-30 UART protocol :one_wire_led control OK
2017-06-30 UART Protocol :add new one_wire_led effect OK
    [灯带效果-06-30.xlsx]
2017-07-15 Get battery info through 232 com
2017-07-19 Add: Auto Power Off When the power is lower than 10%
2017-07-27 change communication com to UART1 ,change debug com to UART3
2017-08-04 fix module ctrl protocol, and back up here
    [app_platform.h, protocol.h, tps611xx_bl.c, uart_protocol.c]
2017-08-09 fix module ctrl bug, change ir_led default lightness to 75
    [platform.c, protocol.h, uart_protocol.c]
2017-09-05 add charge detect ,hardware V0.1
2017-09-20 HW V0.1, add fan ctrl PWM,add Leds ctrl menu, fix some adc error
    [Carrier_PM_V0.0_20170607.sch, NOAH_PM_V0.1_201708051210.sch]
2017-09-25 fix serials leds control bug and Release NOAHC001M08B102
    [app_platform.c, platform_can.c, protocol.h, serial_leds.c, tps611xx_bl.c, voltage_detect.c, voltage_detect.h]
2017-09-26 fix can communication bugs and backup
    [MiCODriverCan.h, can_protocol.c, mico_platform_common.c, platform_can.c, platform_peripheral.h]
2017-10-09 fix CAN receive bug, and backup
    [app_platform.c, can_protocol.c, platform_can.c, uart_protocol.c]
2017-10-13 fix get module status bug,add some CAN protocol
    [can_protocol.c, can_protocol.h]
2017-10-25 add set led effect protocol
2017-10-27 fix battery com logical error
    [battery.c, battery.h, can_protocol.c, protocol.h, voltage_detect.c]
2017-10-31 add charging led effect, add CAN communication timeout led effect
2017-11-16 fix check IO state for poweron or poweroff operation,but not using it. We can use it in emergency situaiton
    [app_platform.c, app_platform.h]
2017-11-22 add charging led effect and Release NOAHC001M08B104
2018-01-08 change poweroff hold time from 6s to 0.5s and Realease NOAHC001M08B105
2018-03-05 add cut off 3.3V power after power off device finished
2018-03-06 change camera leds ctrl, change door ctrl, test OK for now
2018-04-12 fix can not power on or power off when robot is charging
    [app_platform.c, board_init.c, platform.c, platform.h]
2018-04-12 fix ir duty setting bug
    [can_protocol.c, tps611xx_bl.c]
2018-04-16 fix get version bugs, test OK for now
    [can_protocol.c, protocol.h, uart_protocol.c]
2018-04-18 fix door control responding data error
    [app_platform.c, tps611xx_bl.c]
2018-04-19 Reduce the time of the first time to get battery info
2018-04-19 Remove cut off 3.3V power after power off device finished, reduce power consumption when device is poweroff
2018-04-20 Cancel ' reduce power consumption when device is poweroff', and Release NOAHC001M08B107
2018-04-24 fix NOAHC001M08B107 version number, Release NOAHC001M08B107
    [protocol.h]
2018-04-25 add Remote power ctrl:remote shutdown and remote reboot,debugging
    [app_platform.c, app_platform.h, can_protocol.c, can_protocol.h, upgrade_flash.h]
2018-04-26 fix remote power ctrl bug, add delay time when rebooting
    [can_protocol.c]
2018-04-26 fix bat protocol bug
    [can_protocol.c]
2018-04-27 fix reboot delay bugs
    [app_platform.c, upgrade_flash.h]
2018-05-02 fix LED MCU power disable bug
    [board_init.c]
2018-05-28 get HW version through HW version id, Init led Uart when device power on
2018-05-30 shutdown all the door ctrl cards when device is power on
2018-06-05 add 12DCDC fan ctrl
2018-06-26 fix get hardware version bug, init gpio 5v keypad_en GPIOE15 and 5v switch_en GPIOE14
    [app_platform.c, board_init.c, platform.c, platform.h, protocol.h]
2018-06-28 fix charging state bug
    [app_platform.c]
2018-08-16 fix battery power percent is bigger than 100% bug
    [battery.c]
2018-09-03 add get serials leds version protocol
2018-09-18 fix battery percentage bug: 99% and bigger than 100%
    [battery.c, battery.h]
2018-09-20 judge charging state by charging current
2019-07-10 灯带颜色自定义控制更改为最多两种颜色闪烁控制
